betul605/2026_ZUGA-IC/asic/reports/summary.md

# ZUGA-IC Sky130 Sentez Ozeti

| Blok | Hucre | Alan (um^2) |
|---|---:|---:|
| obi_to_axi_lite | 206 | 2996.624000 |
| gpio_axi | 110 | 1406.348800 |
| timer_axi | 987 | 10218.550400 |
| uart_axi | 756 | 9303.923200 |
| i2c_master_axi | 657 | 8012.684800 |
| yz_csr | 780 | 10774.083200 |
| yz_accel | 22362 | 254860.681600 |
| yz_top | 22342 | 259630.256000 |
