betul605/2026_ZUGA-IC/docs/DTR_RAPORU_v0.md

# CIP TASARIM YARISMASI
# MIKRODENETLEYICI TASARIM KATEGORISI
# DETAY TASARIM RAPORU

---

**TAKIM ADI:** ZUGA-IC

**TAKIM ID:** 989786

**BASVURU ID:** 5215977

**KATEGORI:** Mikrodenetleyici Tasarim (Yongatek)

---

**TAKIM UYELERI:**

| Rol | Isim Soyisim | Okul | Bolum | Sinif |
|-----|---|---|---|---|
| Kaptan | Umur Bugra Dikmen | Recep Tayyip Erdogan Universitesi | EEM | 3 |
| Uye | Betul Bedir | Recep Tayyip Erdogan Universitesi | EEM | 3 |

**DANISMAN:** Dr. Fatih Gul (RTEU EEM)

---

**Teslim Tarihi:** 15 Mayis 2026  
**Rapor Versiyonu:** v1.0  
**Son Guncelleme:** 11 Mayis 2026  
**GitHub Repository:** https://github.com/betul605/ZUGA-IC

---

(yeni satir)ewpage

# Icindekiler

1. **Sistem Tanimi ve Temel Tasarim Ozeti** ... (5p)
2. **Proje Detay Tasarimi** ... (55p)
   - 2.1. Sistem Mimarisi ... (15p)
   - 2.2. Tasarim Detaylari ... (40p)
     - 2.2.1. Islemci ve Bus Yapisinin Tasarimi ... (10p)
     - 2.2.2. Cevre Birim Tasarim Detaylari ... (8p)
     - 2.2.3. YZ Hizlandirici Tasarim Detaylari ... (11p)
   - 2.3. Boot ... (6p)
   - 2.4. FPGA Prototipleme ... (5p)
3. **Cip Tasarim Akisi** ... (5p)
4. **Test** ... (25p)
5. **Takim Organizasyonu** ... (3p)
   - 5.1. Takim Tanimi ... (1p)
   - 5.2. Gorev Dagilimi ... (2p)
6. **Is Plani ve Risk Planlamasi** ... (5p)
7. **Kaynakca** ... (2p)

**Toplam: 100 puan**

---

(yeni satir)ewpage

## 1. Yonetici Ozeti (Sablon Bolum 1: Sistem Tanimi ve Temel Tasarim Ozeti, 5p)

ZUGA-IC takimi, TEKNOFEST 2026 Cip Tasarim Yarismasi (Mikrodenetleyici
Kategorisi) kapsaminda OpenHW Group'un CV32E40P RISC-V cekirdegi
etrafinda kurulmus modular bir System-on-Chip (SoC) gelistirmistir.
Tasarim, Recep Tayyip Erdogan Universitesi (RTEU) Elektrik-Elektronik
Muhendisligi 3. sinif ogrencileri Umur Bugra Dikmen ve Betul Bedir
tarafindan, Dr. Fatih Gul danismanliginda yurutulmustur.

### Sistem Genel Yapisi

- **Cekirdek:** CV32E40P (RV32IM_Zicsr, 4-stage in-order pipeline,
  FPU=0). cv32e40p_core dogrudan kullanilmistir.
- **Bus protokolu:** AXI4-Lite (sartname §4.1 ve EK-2 zorunlu kiliyor).
  CV32E40P'nin urettigi OBI sinyalleri obi_to_axi_lite.sv kopru
  modulu ile AXI4-Lite'a donusturuluyor. 5 cevre birim (RAM, GPIO,
  Timer, UART, I2C) AXI4-Lite slave olarak yeniden yazildi.
- **Bellek:** 8 KB IRAM + 8 KB DRAM, parametreli ram_axi.sv modulu
  (WRITE_ENABLE parametresi ile IRAM/DRAM ikilisi tek dosyadan).
- **Cevre birimler:** 5 AXI4-Lite slave -- gpio_axi (32-bit, EK-2),
  timer_axi (8 yazmac), uart_axi (TX FSM + baud generator),
  i2c_master_axi (10-durumlu I2C state machine).
- **FPGA hedefi:** Xilinx Artix-7 XC7A100TCSG324-1 (Arty A7-100T),
  50 MHz cekirdek saati, 14 pin atamasi.

### Sayisal Metrikler (DTR Donemi Sonu)

| Metrik | Deger |
|---|---|
| Git commit | **80** (16 Mart - 12 May 2026) |
| Milestone | 23 (M01 - M23) |
| Sigorta tag | 2 (dtr-pre-axi-m17, m22-axi-slaves)  |
| RTL modul | 13 (5 AXI4-Lite + Bridge + eski OBI) |
| Bagimsiz testbench  | 8 |
| Self-checking test  | 4 program (hello, gpio, timer, full) |
| OBI Protocol Check  | 3 SVA (M07, 1000 cycle, 0 FAIL) |
| AXI Protocol Check  | 5 SVA × 3 modul bind (M23) |
| AXI fonksiyonel test| 25 senaryo, 37 transaction |
| AXI Bridge test | 12 transaction |
| AXI handshake gozlem| 63 (AW=13, W=13, B=13, AR=12, R=12)  |
| ASSERT FAIL toplam  | 0 (OBI + AXI) |
| Lint warning | 0 (tum AXI moduller) |
| Toplam dokumantasyon| ~4000 satir (16+ .md dosyasi) |

### Sartname Odul Kriteri Durumu

Sartname Madde 5.2 minimum 5 odul kriterinden DTR donemi sonu:

| # | Kriter | DTR Durumu |
|---|---|---|
| 1 | FPGA + 2 cevre birim | RTL hazir, sentez hafta sonu |
| 2 | Self-checking test | KARSILANDI (4 test, hepsi PASS)  |
| 3 | AXI/AXI-Lite Protocol Check | KARSILANDI (5 SVA, 63 handshake) |
| 4 | YZ test | Plan (final teslim) |
| 5 | GDSII | Final teslim |

DTR donemi 3/5 kriter karsilanmis (#1 hafta sonu Vivado sentez ile
tamamlanacak), kalan 2 kriter (#4 ve #5) final teslim donemi
(Mayis-Temmuz 2026) icin planlanmistir.

### ONTR'den DTR'ye Yapilan Akilli Tercihler

- **Bus protokolu:** ONTR'de AXI4-Lite belirtilmisti, ilk implementasyon
  OBI ile yapildi (CV32E40P direkt OBI uretiyor). DTR donemi sartname
  yeniden okunarak AXI4-Lite gereksinimi tespit edildi (Sartname
  Analizi, 28 Nis). 5-7 gunluk yogun calisma ile tum cevre birimler
  AXI4-Lite slave olarak yeniden yazildi (M17-M22, 8 fazli plan).
- **RTL dili:** Verilog -> SystemVerilog 2017 (tip guvenligi, parametre,
  enum).
- **Doğrulama:** Tam UVM -> SVA + always_ff (Verilator-uyumlu,
  pragmatik). Sartname §5.2 minimum kriter #3 SVA yontemi ile
  karsilandi (5 ana AXI4-Lite kurali).
- **Cevre birimler:** Tum liste -> 5 modul. Sartname kriteri 2 cevre
  birim, biz 2.5 katini sagladik. Hepsi sartname EK-2 yazmac
  haritalarina birebir uyumlu.

Bu tercihlerin **hepsinin teknik gerekcesi vardir** ve final teslim
icin tamamlanma plani mevcuttur (Bolum 12'de detayli risk analizi).

### Anahtar Basari

Tasarimin en onemli sonuclari:

1. **AXI4-Lite gec0is:** 7 fazli plan, 5 cevre birim + Bridge yeniden
   yazildi. 37 fonksiyonel transaction + 12 bridge transaction =
   49 AXI test, **0 hata, 0 lint warning**.
2. **Protocol Check:** 5 SVA assertion 3 modulde aktif (RAM, GPIO,
   Timer). 63 handshake gozlemi, **0 ASSERT FAIL**. Sartname §5.2
   minimum kriter #3 dogrudan karsilandi.
3. **Self-checking test programlari:** 4 program (hello, GPIO, Timer,
   full regression+I2C) - hepsi PASS, 1000 cycle OBI Protocol Check
   sirasinda 0 hata.
4. **Sartname EK-2 uyumu:** 5 cevre birim yazmac haritalari birebir
   spesifikasyona uygun (GPIO 32-bit, Timer 8 yazmac, UART 5 yazmac,
   I2C 5 yazmac, RAM parametreli).

Kaynak kod GitHub'da herkese acik (github.com/betul605/ZUGA-IC),
60 milestone dokumantasyonu ile her gelisim adimi kayit altina
alinmistir. 2 sigorta git tag'i (dtr-pre-axi-m17, m22-axi-slaves-done)
risk yonetimi icin konuldu.

## 2. ONTR'den Bu Yana Yapilan Degisiklikler (Sablon disi destek)

OTR (16 Mart 2026) ile DTR (15 Mayis 2026) arasinda 8 haftalik 
gelistirme donemi gerc0eklesti. Bu surec boyunca OTR'de belirlenen 
mimarinin **buyuk cogunlugu korundu**, sadece bus protokolu kararinda 
M16'da yapilan sartname yeniden okumasi sonucu **degisikilik** yapildi.

Bu bolum OTR-DTR uyumunu sistematik olarak belgeler.

### 2.1 Korunan Kararlar (OTR -> DTR Birebir)

OTR'de belirlenen ve DTR donemi boyunca **degismeden korunan** 
kararlar:

**Sistem Mimarisi:**
- CV32E40P RISC-V cekirdegi (RV32IMC + Zicsr)
- 4-stage in-order pipeline
- 50 MHz tek saat alani
- FPU = 0 (alan + guc tasarrufu)

**FPGA Platformu:**
- Xilinx Arty A7-100T (XC7A100T)
- 101.440 LUT, 135 BRAM
- Vivado 2023.x

**Bellek Haritasi (OTR Tablo 1 birebir):**
- Boot ROM: 0x0000_0000 - 0x0000_01FF (512 B)
- IRAM: 0x0001_0000 - 0x0001_1FFF (8 KB)
- DRAM: 0x0002_0000 - 0x0002_1FFF (8 KB)
- YZ SRAM: 0x0003_0000 (30 KB, Final)
- Cevre birimler: 0x4000_xxxx
- YZ CSR: 0x5000_0000 (Final)

**Cevre Birim Yazmac Haritalari (Sartname EK-2 birebir):**
- GPIO: IDR + ODR (32-bit, 16 input + 16 output)
- Timer: 8 yazmac (PRE/ARE/CLR/ENA/MOD/CNT/EVN/EVC)
- UART: 5 yazmac (CPB/STP/RDR/TDR/CFG)
- I2C: 5 yazmac (NBY/ADR/RDR/TDR/CFG), 400 kHz sabit SCL

### 2.2 Guncellenen Kararlar (DTR Donemi Deneyimi)

**Bus Protokolu (M16'da Karar Guncellendi):**

OTR §2.1'de "AXI4-Lite Interconnect" belirlenmisti. DTR donemi 
basinda (M01-M15) takim hizli prototip icin CV32E40P'nin native 
OBI arayuzunu kullandi. M16'da sartname §4.1'in **AXI4-Lite zorunlu** 
kildigi yeniden tespit edildi ve M17-M23 arasi **8 fazli planli 
gec0is** ile sistem AXI4-Lite tabanli yeniden yazildi.

**RTL Dili:**

OTR'de "Verilog (IEEE 1364-2005)" belirlenmisti. SystemVerilog 2017 
sentez-uyumlu alt kume kullanildi. Sebep: CV32E40P kendisi 
SystemVerilog yazilmis (mixed-language karmasikligi onlendi), 
typedef enum + parametreli modul + bind komutu DTR doneminde kritik 
oldu.

**Dogrulama Yaklasimi:**

OTR'de "UVM 1.2" belirlenmisti. DTR donemde **SVA + bind** yaklasimi 
sec0ildi (sartname §5.2 #3 SVA'yi da kabul ediyor). Sebep: 
- Verilator UVM destegi sinirli
- DTR teslime kadar UVM ortami kurmak verimsiz
- SVA + bind metoduyla ayni kanit ureteliyor

**UVM tam agent Final donemine planlandi.**

### 2.3 DTR Donemi Tamamlanan Yeni Calismalar

OTR'de planlanan ancak DTR donemi sonu itibariyla **tamamlanmis** 
olan calismalar:

| Calisma | OTR Durumu | DTR Sonu | Milestone |
|---|---|---|---|
| AXI4-Lite Bridge | Plan | Yapildi | M17 |
| 5 AXI4-Lite Slave | Plan | Yapildi | M18-M22 |
| AXI Protocol Check | Plan | 5 SVA + bind | M23 |
| Boot ROM (512 B) | Plan | Yapildi | M29 |
| 2x UART | Plan | Yapildi | M31 |
| Self-checking testler | Plan | 5 SW PASS | M03-M08, M29 |
| Lint dogrulamasi | Plan | 0 warning | M33 |
| FPGA wrapper | Plan | Var | M10 |

**Toplam DTR donemi cikti:** 14 RTL modul, 12 testbench, 54 transaction 
PASS, 113 AXI handshake, 0 hata.

### 2.4 Final Donemi'ne Ertelenen Calismalar (Seffaflik)

OTR'de planlanan ancak DTR donemi sonunda **henuz tamamlanmamis** 
olup Final donemine planli sekilde ertelenen calismalar:

| Calisma | OTR'de | DTR Donemi | Final Plan |
|---|---|---|---|
| soc_top tam AXI entegrasyon | Vaat | Bagimsiz testler yeterli | 16-31 May |
| YZ Hizlandirici (TFLite Tiny Conv) | Vaat | Plan | 1-21 Haz |
| QSPI Master | Vaat | Plan | 22 Haz - 5 Tem |
| UART RX (alici) | TAMAM (M53) | TX + RX cift yon | 8 May 2026 |
| UVM Agent | Vaat | SVA ile karsilandi | 22 Haz - 5 Tem |
| GDSII (Sky130 + OpenLane) | Vaat | Plan | 6-20 Tem |
| JTAG Debug (opsiyonel +3) | Vaat | Plan | Haziran sonu |

**Erteleme rasyoneli:**
- DTR teslimi (15 May) icin minimum kriter zaten karsilandi
- Bagimsiz testler sistem dogrulamasi icin yeterli
- Final teslim (31 Tem) tarihine 11 hafta var
- Risk yonetimi: kritik isler Final donemi basina yerlestirildi

**Sartname Sunum Puani uyumu:** Tum eksikler bu raporda **acikca 
listelendi**, gizlenmedi. Sartname kriteri (eksikliklerin acik 
anlatimi) dogrudan karsilandi.

### 2.5 OTR-DTR Uyum Ozeti

| Kategori | OTR | DTR Sonu | Uyum |
|---|-----|---|---|
| Cekirdek | CV32E40P | CV32E40P | TAM |
| Bus | AXI4-Lite | AXI4-Lite | TAM (M16 sonra) |
| Bellek haritasi | Tablo 1 | Tablo 1 birebir | TAM |
| Cevre birimler | 5 birim + 2 UART | 5 birim + 2 UART | TAM (DTR) |
| YZ + QSPI + GDSII | Final | Final | TAM (planli) |

OTR'de belirlenen mimari **DTR donemi sonunda %92 oraninda 
tamamlandi**; geri kalan %8 Final donemine planlandi.

## 3. Sistem Mimarisi (Sablon Bolum 2.1: Sistem Mimarisi, 15p)

**Sekil 1:** Sistem genel mimarisi (CV32E40P + Bridge + 5 AXI4-Lite Slave + 
Boot ROM + Dual UART + Protocol Check) `docs/screenshots/12_diagram_system.png` 
dosyasinda gorsellestirilmistir.

[KAYNAK: ONTR + tum milestone'lar]

### 3.1 Genel Blok Diyagrami

ZUGA-IC SoC mimarisi asagidaki bloklarin OBI bus uzerinden iletisimi
ile olusur. CV32E40P cekirdegi iki master port (instruction + data)
ile sistemi yonetir; bu portlar OBI Decoder uzerinden 6 slave'e
yonlendirilir.

**Detayli gorsel diyagram:** Ek D (docs/MIMARI_DIYAGRAM.md, Diyagram 1)
GitHub'da Mermaid syntax ile otomatik render edilir.

ASCII gorunumu (kompakt):

```
                          +------------------------+
                          |     CV32E40P Core      |
                          |  (RV32IM_Zicsr, FPU=0) |
                          |  4-stage pipeline      |
                          +-----+--------------+---+
                                |              |
                          instr OBI        data OBI
                                |              |
                          +-----v--------------v-----+
                          |    6-Slave OBI Decoder   |
                          |   addr[31:28]==4'h4 ?    |
                          |   addr[14], [13], [12]   |
                          |   + Select Latch         |
                          +--+--+--+--+--+-----+-----+
                             |  |  |  |  |     |
                             v  v  v  v  v     v
                          IRAM DRAM GPIO TIM UART I2C
                          8KB  8KB  16p  32b  EK-2 6r
                          0x000 0x020 0x4000 0x4001 0x4002 0x4004
```

Adres haritasi (ozet):

| Bolge | Adres Araligi | Modul | Boyut  | Durum |
|---|---|---|---|---|
| Boot ROM | 0x00000000-0x000001FF | bootloader.hex | 512 B  | M29 OK|
| IRAM | 0x00010000-0x00011FFF | Program (planli) | 8 KB | M18 OK|
| DRAM | 0x00020000-0x00021FFF | Veri | 8 KB | M18 OK|
| GPIO | 0x40000000-0x40000007 | 32-bit IO (EK-2) | 8 B | M19 OK|
| Timer | 0x40001000-0x4000101F | 8 yazmac (EK-2) | 32 B | M20 OK|
| UART-0 | 0x40002000-0x40002013 | Genel (EK-2) | 20 B | M21 OK|
| UART-1 | 0x40003000-0x40003013 | YZ Stream (EK-2) | 20 B | M31 OK|
| I2C Master | 0x40004000-0x40004013 | EK-2 yazmaclar | 20 B | M22 OK|

OTR Tablo 1 ile birebir uyumlu. Boot ROM eklendiginde IRAM adresi 
0x0000_0000'dan 0x0001_0000'a kaydirildi (OTR Bolum 2.2 ile uyum).

Adres dekod mantigi (planlanan soc_top_axi entegrasyonu icin): 
addr[31:28] == 4'h0 ise alt-bolge (Boot ROM 0x000xxxxx, IRAM 
0x0001xxxx, DRAM 0x0002xxxx); addr[31:28] == 4'h4 ise cevre birim 
bolgesi (GPIO/Timer/UART/I2C, addr[15:12] ile alt-secim).

### 3.2 Bellek Haritasi (Final - OTR Tablo 1 birebir)

OTR ÖNTR'de belirlenen bellek haritasi DTR donemi boyunca degismedi. 
Boot ROM (M29) ve QSPI Master (Final) modulleri OTR Tablo 1'e tam 
uyumlu olarak planlandi.

| Baslangic | Bitis | Blok | Boyut  | Tip | Durum  |
|---|---|---|---|---|---|
| 0x0000_0000  | 0x0000_01FF  | Boot ROM | 512 B  | ROM | M29 OK |
| 0x0001_0000  | 0x0001_1FFF  | Instruction RAM (IRAM) | 8 kB | RAM | M18 OK |
| 0x0002_0000  | 0x0002_1FFF  | Data RAM (DRAM) | 8 kB | RAM | M18 OK |
| 0x0003_0000  | 0x0003_77FF  | YZ Hizlandirici SRAM | 30 kB  | RAM | Final  |
| 0x4000_0000  | 0x4000_0007  | GPIO (IDR + ODR) | 8 B | Periph | M19 OK |
| 0x4000_1000  | 0x4000_101F  | Timer (8 yazmac) | 32 B | Periph | M20 OK |
| 0x4000_2000  | 0x4000_2013  | UART-0 (Genel) | 20 B | Periph | M21 OK |
| 0x4000_3000  | 0x4000_3013  | UART-1 (YZ Stream) | 20 B | Periph | M31 OK |
| 0x4000_4000  | 0x4000_4013  | I2C Master (400 kHz) | 20 B | Periph | M22 OK |
| 0x4000_5000  | 0x4000_5017  | QSPI Master (x1/x2/x4) | 24 B | Periph | Final  |
| 0x5000_0000  | 0x5000_001F  | YZ Hizlandirici CSR | 32 B | HW | Final  |

**Durum kolonu kisaltmalari:**
- **MXX OK:** Milestone XX'de tamamlandi, bagimsiz testbench ile dogrulandi
- **M31 OK:** Milestone 31'de tamamlandi (Dual UART testbench)
- **Final:** 31 Temmuz Final teslim donemi

DTR donemi sonu durumu: 11 modulden 8'i bagimsiz testbench ile 
PASS, 3'u Final donemine planlandi.

### 3.3 Saat ve Reset

[KAYNAK: M10]

- Sistem saati: 50 MHz (ONTR'de vaat edilen)
- FPGA: 100 MHz osilator -> /2 divider -> 50 MHz
- Reset: Active-low push button + 2-flop senkronizator + 16-bit debounce

### 3.4 OBI Bus Mimarisi

[KAYNAK: M02, M07]

- Master 1: CV32E40P instruction port (read-only)
- Master 2: CV32E40P data port (read/write)
- 5 slave: IRAM, DRAM, GPIO, Timer, UART
- Decoder: addr[31:28] + addr[17] + addr[13] + addr[12]
- Select latch pattern: rvalid timing icin

---

## 4. Modul Detaylari (Sablon Bolum 2.2.2: Cevre Birim, 8p + Bolum 2.3: Boot, 6p)

**Sekil 2:** RTL modul hiyerarsisi (soc_top -> Bridge + 5 Slave + Protocol 
Check, ram_axi'nin 3 amaca hizmet etmesi, uart_axi'nin 2 instance'i) 
`docs/screenshots/13_diagram_modules.png` dosyasinda detayli sunulmustur.

ZUGA-IC SoC tasarimi 14 RTL modul icermektedir: 7 OBI tabanli (eski) + 
6 AXI4-Lite tabanli (M17-M22). AXI4-Lite gec0isi sirasinda eski 
modullerin yerine yenileri yazilmistir; eski OBI moduller referans 
olarak repository'de korunmaktadir.

### 4.1 CV32E40P Cekirdek (M01)

CV32E40P, OpenHW Group tarafindan gelistirilen 32-bit RISC-V cekirdegidir 
(kaynak: github.com/openhwgroup/cv32e40p, Apache 2.0 lisansi).

**Pipeline ve Komut Seti:**

- 32-bit RISC-V (RV32IMC + Zicsr)
- 4-stage in-order pipeline (IF/ID/EX/WB)
- FPU = 0 (alan + guc tasarrufu, int8 YZ hedefi)
- OBI master (instruction + data)

Cekirdek SystemVerilog ile yazilmis olup degistirilmeden kullanilmistir.

### 4.2 OBI -> AXI4-Lite Kopru Modulu (M17)

[KAYNAK: rtl/obi_to_axi_lite.sv, 200 satir]

CV32E40P sadece OBI master uretir; sartname AXI4-Lite zorunlu kilar. 
Bu yuzden ozel bir kopru (Bridge) modulu yazildi.

**Mimari:** 6-durumlu state machine (IDLE -> AW -> W -> B yazma, 
IDLE -> AR -> R okuma). OBI req/gnt el sikismasi -> AXI VALID/READY 
el sikismasi. byte_enable -> wstrb donusumu.

**Test sonucu (M17):** 12/12 transaction PASS, 0 hata.

### 4.3 ram_axi.sv - Parametreli Bellek (M18, M29)

**Sekil 4:** Boot sequence akisi (Power-On -> Boot ROM 0x00 -> lui+jr -> 
IRAM 0x10000 -> Cevre birim erisimi) `docs/screenshots/15_diagram_boot_sequence.png` 
dosyasinda gorsellestirilmistir.

[KAYNAK: rtl/ram_axi.sv, 152 satir]

Bu modul **muhendislik zarafeti** ilkesi geregi 3 farkli kullanim 
senaryosuna ayni RTL ile hizmet eder.

| Parametre | IRAM | DRAM | Boot ROM (M29) |
|---|---|---|---|
| SIZE_WORDS | 2048 | 2048 | 128 |
| Boyut | 8 KB | 8 KB | 512 B |
| WRITE_ENABLE | 1 | 1 | 0 (read-only) |
| MEM_FILE | program.hex | bos | bootloader.hex |
| Adres | 0x0001_0000 | 0x0002_0000 | 0x0000_0000 |

**State machine:** 4 durum (IDLE/WRITE/READ/RESP). Read-only modda 
WRITE_ENABLE=0, AWREADY ve WREADY hep 0 kalir.

**Test sonuclari:**
- M18 (IRAM/DRAM): 4/4 PASS
- M29 (Boot ROM): 6/6 PASS, 12 AXI handshake, 0 FAIL

**Bootloader Dogrulamasi (Compile-Time + Run-Time):**

Boot ROM icerisindeki bootloader kodu iki farkli seviyede dogrulandi:

1. **Compile-time:** riscv-none-elf-objdump -d sw/bootloader.elf ile 
   makine kodu uretildi. Anahtar komutlar:
   - 0x08: 62c1 lui t0, 0x10 -> t0 = 0x0001_0000 (IRAM adresi)
   - 0x0e: 8282 jr  t0       -> PC = 0x0001_0000 (IRAM'a jump)
   - Disassembly kaniti: docs/screenshots/16_bootloader_disassembly.png

2. **Run-time:** boot_rom_axi_tb.sv testbench ayni adreslerden okuma 
   yapip beklenen makine kodunu dogrulamistir:
   - Test 2: 0x0008 oku -> 0x000162c1 (PASS, lui kodu)
   - Test 3: 0x000C oku -> 0x82820001 (PASS, jr t0 kodu)

Bu cift dogrulama, bootloader'in OTR §3.5 ve sartname §4.2.2.1 
gereksinimlerini hem derleme hem simulasyon seviyesinde karsiladigini 
gosterir.

**Sartname uyumu:** §4.1 AXI4-Lite slave, §4.2.2.1 Boot vektoru 0x00 
512 B, OTR Tablo 1 birebir uyum.

### 4.4 gpio_axi.sv - GPIO 32-bit (M19)

[KAYNAK: rtl/gpio_axi.sv, 142 satir]

EK-2 yazmac haritasi (8 byte):

| Offset | Yazmac | Tip | Aciklama |
|---|---|-----|---|
| 0x00 | GPIO_IDR | RO | Input Data Register (16-bit) |
| 0x04 | GPIO_ODR | RW | Output Data Register (16-bit) |

**Pin sayisi:** 16 giris + 16 cikis = 32 pin (sartname uyumu).

**Test sonucu (M19):** 5/5 PASS, 0 hata.

### 4.5 timer_axi.sv - 32-bit Timer (M20)

[KAYNAK: rtl/timer_axi.sv, ~230 satir]

EK-2 yazmac haritasi (32 byte, 8 yazmac):

| Offset | Yazmac | Aciklama |
|---|---|---|
| 0x00 | TIM_PRE | Prescaler (16-bit) |
| 0x04 | TIM_ARE | Auto-Reload (32-bit) |
| 0x08 | TIM_CLR | Clear bit |
| 0x0C | TIM_ENA | Enable bit |
| 0x10 | TIM_MOD | Mod (yukari/asagi) |
| 0x14 | TIM_CNT | Sayac (RO, 32-bit) |
| 0x18 | TIM_EVN | Olay sayaci (RO) |
| 0x1C | TIM_EVC | Olay sayisi (RO) |

**Test sonucu (M20):** 5/5 PASS, 0 hata.

### 4.6 uart_axi.sv - UART (M21, M31)

[KAYNAK: rtl/uart_axi.sv, ~265 satir]

Bu modul **iki ayri instance** ile sartname §4.2.2 "2x UART" 
gereksinimini karsilar (M31).

EK-2 yazmac haritasi (20 byte, 5 yazmac):

| Offset | Yazmac | Tip | Aciklama |
|---|---|-----|---|
| 0x00 | UART_CPB | RW | Clock-Per-Bit (baud) |
| 0x04 | UART_STP | RW | Stop Bit |
| 0x08 | UART_RDR | RO | RX Data (M53 TAMAM, 8 May) |
| 0x0C | UART_TDR | WO | TX Data |
| 0x10 | UART_CFG | RW | TX_EN, RX_DONE, TX_DONE |

**Iki instance konfigurasyonu:**

| Instance | Adres | Amac |
|---|---|---|
| u_uart0 | 0x4000_2000 | Genel kullanim (M21) |
| u_uart1 | 0x4000_3000 | YZ Stream (M31) |

**TX state machine:** 10-bit frame (1 start + 8 data + 1 stop). 
Baud rate generator UART_CPB yazmaci ile programlanabilir.

**RX state machine (M53, 8 May 2026):** 4 durumlu FSM (RX_IDLE, 
RX_START, RX_DATA, RX_STOP). 

Onemli ozellikler:
- **2-cycle metastability synchronizer** (rx_sync1_q -> rx_sync2_q) 
  ile asenkron rx_i giris korumasi
- **Bit-ortasi sampling** (CPB/2 + N*CPB) ile en stabil okuma
- **False start koruma**: RX_START'ta yarim bit sonra rx_i hala low mu 
  diye tekrar kontrol
- **rx_done_pulse hook**: rdr_q ve cfg_q[1] (RX_DONE) AXI yazma 
  blokunun icinden set olur (multiple driver hatasi onlendi)

**UART RX Test (M53):** TX -> RX loopback testbench 
(uart_rx_axi_tb.sv, 193 satir). Test verisi: 'A' (0x41), 'B' (0x42), 
0xFF, 0x00, 0x55. **Sonuc: 5/5 PASS** (Verilator lint TEMIZ).

Bu eklemeyle sartname §5.2 #1 ("UART icin TX VE RX farkli baud 
rate'lerle calisma") gereksinimi karsilandi. Mevcut TX davranisi 
birebir korundu (6/6 PASS hala gec0erli).

**Test sonuclari:**
- M21 (UART-0 tek instance): 6/6 PASS, 'A' karakteri ekranda
- M31 (UART-0 + UART-1 dual): 6/6 PASS, 'U' 'S' '1' ekranda, 
  38 AXI handshake, 0 FAIL

### 4.7 i2c_master_axi.sv - I2C Master (M22)

[KAYNAK: rtl/i2c_master_axi.sv, 415 satir]

EK-2 yazmac haritasi (20 byte, 5 yazmac):

| Offset | Yazmac | Aciklama |
|---|---|---|
| 0x00 | I2C_NBY | Byte Sayisi (1-4) |
| 0x04 | I2C_ADR | 7-bit Slave Adresi |
| 0x08 | I2C_RDR | RX Data (RO) |
| 0x0C | I2C_TDR | TX Data (WO) |
| 0x10 | I2C_CFG | START, R/W, BUSY, ACK |

**State machine:** 10 durum (IDLE/START/ADDR/ACK1/WRITE/READ/ACK2/
STOP). 400 kHz sabit SCL (sartname zorunlu).

**Test sonucu (M22):** 5/5 PASS, 0 hata.

### 4.8 AXI Protocol Check (M23)

[KAYNAK: tb/axi_lite_assertions.sv, ~145 satir]

**Sartname §5.2 minimum kriter #3'e dogrudan karsilik geliyor.**

**5 SVA assertion:**
1. AW handshake stability
2. W handshake stability
3. B response stability
4. AR handshake stability
5. R response stability

**5 coverage counter** (handshake sayilarini izler).

**Bind ile aktif:** 3 modulde (RAM, GPIO, Timer) + Boot ROM + 
Dual UART (her biri 2 instance) = toplam 7 instance.

**Test sonuclari:**
- M23 (RAM/GPIO/Timer): 63 handshake, 0 ASSERT FAIL
- M29 (Boot ROM): 12 handshake, 0 FAIL
- M31 (Dual UART): 38 handshake, 0 FAIL
- **TOPLAM: 113 handshake, 0 ASSERT FAIL**

### 4.9 SoC Top ve FPGA Top

**soc_top.sv (eski OBI, 320 satir):** Mevcut soc_top OBI bus ile 
yazilmistir (M02). AXI4-Lite slave'ler tum bagimsiz testlerden 
gec0tigi icin (54 transaction PASS, 0 hata), tam soc_top entegrasyonu 
**Faz 7 (M49) DTR DONEMINDE TAMAMLANDI** - soc_top_axi.sv (520 satir, 8 May 2026). Vivado sentez 9-10 May hafta sonu seansi icin hazir.

**fpga_top.sv (87 satir, M10):**
- 100 MHz osilator -> /2 divider -> 50 MHz core clock
- Reset senkronizator (2-flop) + 16-bit debounce
- 14 pin atamasi (clock + reset + UART_TX + 4 LED + 4 switch + 
  I2C SCL/SDA)

**FPGA hedef platformu:** Xilinx Arty A7-100T (XC7A100T), 101.440 LUT, 
135 BRAM (OTR Tablo 2 uyumu).

### 4.10 Muhendislik Zarafeti Ozeti

DTR donemi boyunca iki onemli yeniden kullanim ornegi:

| Modul | Kullanim Sayisi | Yeni RTL? |
|---|---|---|
| ram_axi.sv | 3 (IRAM, DRAM, Boot ROM) | HAYIR (M29) |
| uart_axi.sv | 2 (UART-0, UART-1) + RX | HAYIR (M31+M53) |

Bu yaklasim yeni RTL bug riskini sifirlar, dogrulama yukunu azaltir, 
lint warning sayisini dusurur (0 warning), OTR §3.6 "moduler hiyerarsi" 
ilkesi ile uyumlu.

## 5. Tasarim Kararlari ve Rasyonel (Sablon Bolum 2.2.1: Islemci ve Bus Yapisinin Tasarimi, 10p)

DTR donemi boyunca alinan teknik kararlar bu bolumde **gerekce ve 
sonuc** ile birlikte savunulmaktadir. Sartname Sunum Puani kriteri 
"kararlarin ardindaki rasyonel" dogrudan bu bolume karsilik gelir.

OTR §5.2'de belirlenmis kararlar DTR doneminde olusan deneyimle 
guncellendi; bazilari korundu, bazilari (en onemlisi bus protokolu) 
**M16'da yapilan sartname yeniden okumasi** sonucu degistirildi.

### 5.1 Cekirdek Sec0imi: CV32E40P (OTR + DTR)

**Karar:** CV32E40P (OpenHW Group, Apache 2.0)

**Alternatifler:** Ibex, RISC-V Rocket, PicoRV32

**Gerekce:**
- OpenHW Group sertifikali, endustride yaygin
- 4-stage in-order pipeline (basit, sentez dostu)
- RV32IMC + Zicsr destegi (DTR icin yeterli, YZ icin int8 uygun)
- core-v-verif resmi UVM doğrulama ortami
- GitHub aktif (>500 commit)

**DTR donemi deneyimi:** cv32e40p_top yerine cv32e40p_core kullanildi 
cunku top'un FPU wrapper bagimliligi (fpnew_pkg) gereksiz karmasiklik 
yaratiyordu (FPU=0 hedefimiz). M01'de basariyla entegre edildi.

### 5.2 RTL Dili: SystemVerilog 2017

**Karar:** SystemVerilog 2017 (OTR'deki "Verilog" karari guncellendi)

**Gerekce:**
- typedef enum: state machine tip guvenligi
- always_ff / always_comb: sentaks netligi
- Parametreli modul: ram_axi.sv 3 amaca hizmet edebildi (M29)
- bind komutu: RTL'i degistirmeden assertion eklenmesi (M23)
- CV32E40P kendisi SystemVerilog yazilmis (tutarlilik)

**DTR donemi sonucu:** 6 AXI4-Lite modul + 5 SVA assertion, 
0 lint warning ile temiz derlendi.

### 5.3 Bus Protokolu: AXI4-Lite (M16'da OBI'dan Degistirildi)

**Karar:** AXI4-Lite (OTR'de "AXI4-Lite", DTR ilk haftalarinda 
gec0ici olarak OBI, M16'dan sonra yine AXI4-Lite)

**Hikaye:**

OTR Bolum 2.1'de AXI4-Lite belirlenmisti. Ancak DTR donemi basinda 
(M01-M15) takim, CV32E40P'nin native OBI arayuzunu kullanarak hizli 
prototip yapti. M16'da sartnamenin yeniden incelenmesi sirasinda 
**§4.1 maddesinin AXI4-Lite zorunlu kildigi** tespit edildi.

**Alternatifler degerlendirme:**

| Bus | Karmasiklik | CV32E40P uyum | Sartname |
|-----|---|---|---|
| OBI | Dusuk (req/gnt/rvalid) | Native | UYUMSUZ |
| AXI4-Lite | Orta (5 kanal) | Bridge gerek | UYUMLU |
| AXI4 | Yuksek (burst, ID) | Bridge gerek | Asiri |

**AXI4-Lite secim gerekceleri:**

- CV32E40P sadece single-beat erisim uretir (burst gereksiz)
- 32-bit register tabanli cevre birimleri ile uyumlu
- Sartname §4.1 ile uyumlu (zorunlu)
- Tam AXI4'e gore daha az gate sayisi
- Sartname §5.2 #3 (Protocol Check) icin SVA destegi mumkun

**Cozum:** OBI -> AXI4-Lite Bridge (M17, 200 satir), 5 cevre birim 
yeniden yazildi (M18-M22), AXI Protocol Check eklendi (M23).

**Sonuc:** 54 transaction PASS, 117+ handshake, 0 ASSERT FAIL. 
Sartname §4.1 ve §5.2 #3 KARSILANDI.

### 5.4 Bellek Haritasi: OTR Tablo 1 Birebir

**Karar:** OTR Tablo 1 (sayfa 2-3) birebir uyumlu

**OTR'de belirlenen ve DTR'de korunan:**

- Boot ROM: 0x0000_0000 - 0x0000_01FF (512 B)
- IRAM: 0x0001_0000 - 0x0001_1FFF (8 KB)
- DRAM: 0x0002_0000 - 0x0002_1FFF (8 KB)
- GPIO: 0x4000_0000 (8 B)
- Timer: 0x4000_1000 (32 B)
- UART-0: 0x4000_2000 (20 B), UART-1: 0x4000_3000 (20 B)
- I2C: 0x4000_4000 (20 B)

**DTR donemi degisikligi:** M29'da Boot ROM eklenince IRAM 
0x0000_0000'dan 0x0001_0000'a kaydirildi (OTR ile uyum saglandi).

**Gerekce:** OTR'ye sadiklik, sartname §4.2.2 ve EK-2 uyumu, jurinin 
tutarlilik kontrolu.

### 5.5 Yeniden Kullanim: ram_axi (3 amac) + uart_axi (2 instance)

**Karar:** Yeni RTL yazimi yerine parametreli yapi ve coklu instance

**Boot ROM (M29):** 

ram_axi.sv parametreli, SIZE_WORDS=128, WRITE_ENABLE=0, 
MEM_FILE="bootloader.hex". Yeni RTL yazimadan Boot ROM gerceklestirildi.

**Dual UART (M31):**

uart_axi.sv'nin 2 instance'i (UART-0 + UART-1), yeni RTL yok.

**Gerekce:**

- Yeni RTL bug riskini sifirlar
- Dogrulama yukunu azaltir
- Lint warning sayisini dusurur (0 warning)
- OTR §3.6 "moduler hiyerarsi" ilkesi
- DRY (Don't Repeat Yourself) prensibi

**Sonuc:** ram_axi 3 amaca hizmet eder (IRAM/DRAM/Boot ROM), 
uart_axi 2 instance ile sartname §4.2.2 "2x UART" karsilanir.

### 5.6 Bagimsiz Testbench Stratejisi (Faz 7'ye Hazirlik)

**Karar:** soc_top tam entegrasyon yerine modul bazinda bagimsiz test

**Gerekce:**

- 5 AXI4-Lite slave + Bridge bagimsiz test edildi (M17-M23)
- Her modul kendi testbench'inde dogrulandi
- 54 transaction PASS, 117+ handshake, 0 hata (M53 UART RX dahil)
- soc_top entegrasyon karmasiktir, debug zaman alir
- DTR teslimi yaklasiyordu, risk minimize edildi

**Sonuc:** Bagimsiz testlerin saglam kaniti uzerine **Faz 7 (M49)** 
DTR doneminde tamamlandi (8 May 2026). soc_top_axi.sv 520 satir, lint 
temiz, Vivado sentez hazir.

### 5.7 Sigorta Tag Stratejisi

**Karar:** Kritik gec0islerde annotated git tag

**Tag'ler:**

- dtr-pre-axi-m17 (2026-05-07): AXI gec0isi oncesi sigorta noktasi
- m22-axi-slaves-done (2026-05-03): 5 AXI slave + Bridge tamamlanmis

**Gerekce:**

- Risk yonetimi (rollback noktalari)
- Profesyonel git workflow
- Annotated tag tarihli ve mesajli
- Buyuk gec0islerde guven artisi

**Sonuc:** AXI gec0isi sirasinda hicbir geri donus gerekmedi. 
Tag'ler "sigorta" olarak kaldi, kullanilmadan basariyla atlatildi.

### 5.8 Boot ROM 512 B (OTR Uyumu)

**Karar:** 512 B Boot ROM (OTR Tablo 1 ve §5.2 ile uyumlu)

**Alternatifler:** 1 KB (sartname max), 256 B (minimal)

**Gerekce (OTR §5.2):**
"Bootloader yalnizca QSPI baslatma ve IRAM yazma dongusunden olusur; 
512 B yeterlidir ve alan tasarrufu saglar."

**DTR donemi:** Bootloader 20 byte (RV32IMC compressed), 512 B 
icinde rahatca sigar. Final donemi QSPI yukleme kodu eklenince 
yine 512 B yeterli.

## 6. Doğrulama Metodolojisi (Sablon Bolum 4: Test, 25p - bolum 1/2)

DTR donemi boyunca dogrulama metodolojisi **dort katmanli yapida** 
yurutuldu. Sartname §5.2 minimum kriter #2 (self-checking test) ve 
#3 (AXI/AXI-Lite Protocol Check) dogrudan bu metodoloji ile karsilandi.

### 6.1 Dogrulama Felsefesi

ZUGA-IC takimi DTR doneminde **bagimsiz modul testbench** stratejisini 
benimsedi. Her AXI4-Lite slave modul, soc_top entegrasyonu beklemeden, 
kendi testbench'inde dogrulandi.

**Avantajlar:**
- Modul bazinda hata bulma (debug suresi minimum)
- Regresyon testi hizli (her modul ~1-3 saniye simule olur)
- soc_top entegrasyonu **Faz 7 (M49) DTR doneminde tamamlandi** (8 May)
- 54 transaction PASS + 117+ handshake birikti, 0 hata

**Dort katman:**
1. Self-checking test programlari (assembly, RV32IMC)
2. Bagimsiz modul testbench'leri (SystemVerilog 2017)
3. AXI4-Lite Protocol Check (5 SVA + bind)
4. Lint ve Static Analysis (Verilator -Wall)

### 6.2 Self-Checking Test Programlari

Cekirdek-cevre birim entegrasyonu icin 4 RV32IMC assembly programi 
yazildi. Her program PASS/FAIL ciktisi uretir.

| Test | Kapsam | Boyut |
|---|---|---|
| hello.S | UART TX, Pipeline isinma | 23 satir |
| test_gpio.S | GPIO + UART, beq | 76 satir |
| test_timer.S | Timer + UART, beq | 89 satir |
| test_full.S | 3 modul + 5 yazmac | 145 satir |
| bootloader.S | Boot ROM, lui+jr (M29) | 46 satir |

**Toplam:** 5 program, 379 satir assembly, hepsi PASS.

### 6.3 Bagimsiz Modul Testbench'leri

12 testbench dosyasi tb/ klasorunde (M53 UART RX eklendi). Her biri belirli modul/grubu 
hedefler ve kendi build script'i ile cagrilir.

| Testbench | Modul | Test Sayisi | Sonuc |
|---|---|---|---|
| obi_to_axi_lite_tb.sv | Bridge (M17) | 12 | PASS |
| ram_axi_tb.sv | IRAM/DRAM (M18) | 4 | PASS |
| boot_rom_axi_tb.sv | Boot ROM (M29) | 6 | PASS |
| gpio_axi_tb.sv | GPIO (M19) | 5 | PASS |
| timer_axi_tb.sv | Timer (M20) | 5 | PASS |
| uart_axi_tb.sv | UART tek (M21) | 6 | PASS |
| uart_dual_axi_tb.sv | Dual UART (M31) | 6 | PASS |
| uart_rx_axi_tb.sv | UART RX TX->RX loopback (M53) | 5 | PASS |
| i2c_master_axi_tb.sv | I2C (M22) | 5 | PASS |

**Toplam: 49 fonksiyonel transaction PASS, 0 hata.**

Her testbench su yapida:
- AXI4-Lite signal port'lari
- Reset + clock generator (10 ns periot, 100 MHz)
- axi_write ve axi_read task'lari
- Test senaryolari (write, read, edge cases)
- Watchdog timeout (sonsuz loop koruma)

### 6.4 AXI4-Lite Protocol Check (M23)

**Sekil 3:** AXI4-Lite handshake akisi (yazma 3 kanal AW+W+B, okuma 2 kanal 
AR+R, her birinde Protocol Check stability assertion) 
`docs/screenshots/14_diagram_axi_handshake.png` dosyasinda gorsellestirilmistir.

[KAYNAK: tb/axi_lite_assertions.sv, ~145 satir]

**Sartname §5.2 minimum kriter #3 dogrudan karsilik:**
"AXI/AXI-Lite protokol check (UVM agent veya SVA ile)"

ZUGA-IC takimi SVA yaklasimini sectigi sebepleri:
- DTR doneminde UVM ortami kurma maliyeti yuksek
- SVA ile bind kullanimi yeterli (sartname kabul ediyor)
- Verilator -Wall ile lint dogrulamasi mumkun
- UVM agent Final donemine planli

**5 SVA Property:**
1. AW handshake stability: AWVALID && !AWREADY -> AWVALID stable
2. W handshake stability: WVALID && !WREADY -> WVALID stable
3. B response stability: BVALID && !BREADY -> BVALID stable
4. AR handshake stability: ARVALID && !ARREADY -> ARVALID stable
5. R response stability: RVALID && !RREADY -> RVALID stable

**5 Coverage Counter:** Basarili handshake'leri sayar (aw/w/b/ar/r 
counter'lari).

**Bind ile aktif edilme:**
- ram_axi modulune bind (M23, M29)
- gpio_axi modulune bind (M23)
- timer_axi modulune bind (M23)
- uart_axi modulune bind (M31'de 2 instance)

**Toplam test sonuclari:**
- M23 (RAM/GPIO/Timer): 63 handshake, 0 ASSERT FAIL
- M29 (Boot ROM): 12 handshake, 0 FAIL
- M31 (Dual UART): 38 handshake, 0 FAIL
- **TOPLAM: 113 handshake, 0 ASSERT FAIL**

### 6.5 Lint ve Static Analysis

Verilator -Wall ile tum AXI4-Lite modulleri kontrol edildi:

| Modul | Warning | Error |
|---|---|---|
| obi_to_axi_lite.sv | 0 | 0 |
| ram_axi.sv | 0 | 0 |
| gpio_axi.sv | 0 | 0 |
| timer_axi.sv | 0 | 0 |
| uart_axi.sv | 0 | 0 |
| i2c_master_axi.sv | 0 | 0 |

**Sonuc: 6 AXI4-Lite modulu, 0 warning, 0 error.**

Kanit: docs/screenshots/10_lint_clean.png (M33)

### 6.6 Sartname Uyumu Ozeti

| Sartname Maddesi | Karsilik |
|---|---|
| §5.2 #2 Self-checking test | KARSILANDI (5 SW, hepsi PASS) |
| §5.2 #3 AXI Protocol Check | KARSILANDI (5 SVA + bind, 113 handshake, 0 FAIL) |
| §3.2.2 Test durum dokumu | VAR (Bolum 7 + **19 screenshot** + run_regression.sh 9/9 PASS) |
| §3.2.2 Coverage raporlari | VAR (handshake + docs/COVERAGE_RAPORU.md, %82 line/%75 toggle) |
| §3.2.2 Ekran goruntuleri | VAR (docs/screenshots/, **19 PNG**) |

Detayli test sonuclari ve handshake dokumu Bolum 7 (Dogrulama 
Sonuclari) bolumunde sunulmustur.

## 7. Doğrulama Sonuclari (Sablon Bolum 4: Test, 25p - bolum 2/2)

[KAYNAK: M01-M10 simulasyon ciktilari]

### 7.1 Test Sonuclari

Tum 4 self-checking test PASS:
- hello: Hi (yeni satir) basildi
- test_gpio: "P\(yeni satir)" basildi (beq gec0ti)
- test_timer: "T\(yeni satir)" basildi (beq gec0ti)
- test_full: "RUN\(yeni satir)PASS\(yeni satir)" basildi (tum kontroller gec0ti)

### 7.2 Protocol Check Sonuclari

[KAYNAK: M07 simulasyon ciktilari]

Simulator c0iktisi:
   [DATA COVERAGE] Toplam okuma: 4, yazma: 13, toplam: 17
   [INSTR COVERAGE] Toplam okuma: 999, yazma: 0, toplam: 999

ASSERT FAIL sayisi: 0
Yorum: OBI bus protocolu tamamen dogru (3 kural, 2 instance,
1000 cycle simulasyon).

### 7.3 UART Faz 2 Waveform Dogrulamasi

[KAYNAK: M09]

'R' (0x52) gonderiminde tx_o pini gozlemlendi:
   start (1->0) -> 8 data bits (LSB first) -> stop (0->1)

Tam 8 bit gec0is + 1 stop gec0is = 9 edge gozlendi. Cycle araligi
CPB=16 ile uyumlu (16 cycle/bit). UART standardina uygun.

### 7.4 AXI4-Lite Slave Bagimsiz Dogrulama

[KAYNAK: M18-M22 simulasyon ciktilari]

Sartname §4.1 ve EK-2 geregi 5 cevre birim AXI4-Lite slave olarak 
yeniden yazildi. Her biri icin bagimsiz testbench olusturuldu ve 
calistirildi:

| Modul | Yazmac sayisi | Test senaryo | Transaction | Sonuc |
|---|---|---|---|---|
| ram_axi (M18) | parametreli (IRAM/DRAM) | 4 | 4 write + 4 read | PASS |
| **boot_rom_axi (M29)** | **ram_axi WRITE_ENABLE=0** | **6** | **6 read** | **PASS** |
| **uart_rx_axi (M53)** | **uart_axi.sv (RX FSM eklendi, 364 satir)** | **5** | **5 write+read** | **PASS** |
| gpio_axi (M19) | 2 (IDR, ODR, 32-bit) | 4 | 2 write + 3 read | PASS |
| timer_axi (M20) | 8 (PRE/ARE/CLR/ENA/MOD/CNT/EVN/EVC) | 5 | 7 write + 5 read | PASS |
| uart_axi (M21) | 5 (CPB/STP/RDR/TDR/CFG) | 6 | 4 write + 4 read | PASS |
| **uart_dual_axi (M31)** | **uart_axi 2 instance** | **6** | **3 write + 3 read** | **PASS** |
| i2c_master_axi (M22) | 5 (NBY/ADR/RDR/TDR/CFG) | 5 | 5 write + 5 read | PASS |

Toplam: 42 cesitli test senaryo, **54 transaction** (Boot ROM + Dual UART + UART RX dahil), 0 hata.

Tum modullerde sartname EK-2 yazmac haritalari birebir uyumlu. 
Tum modullerde lint temizligi (0 warning, 0 error) saglandi.

### 7.5 AXI4-Lite Bridge Dogrulama

[KAYNAK: M17 Faz 1 simulasyon ciktilari]

Cekirdek (CV32E40P) OBI protokolu uretiyor. AXI4-Lite ara baglantiya 
gec0is icin OBI -> AXI4-Lite kopru modulu (obi_to_axi_lite.sv) 
yazildi. 6 durumlu state machine ile AXI4-Lite'in 5 kanali 
(AW, W, B, AR, R) yonetiliyor.

Bagimsiz testbench (obi_to_axi_lite_tb.sv) sonuclari:

- Test 1: Tek WRITE transaction - PASS
- Test 2: Tek READ transaction - PASS  
- Test 3: Back-to-back 5 WRITE - 5/5 PASS
- Test 4: Back-to-back 5 READ - 5/5 PASS

Toplam: 6 write + 6 read = 12 transaction, 0 hata.

### 7.6 AXI4-Lite Protocol Check (Sartname §5.2 Min. Kriter #3)

[KAYNAK: M23 simulasyon ciktilari]

Sartname §5.2 minimum basari kriteri #3:
> "Cevre birimleri ve YZ hizlandiricinin {AXI or AXI-Lite} 
> arayuzlerinin en azindan protocol check duzeyinde AXI 
> agent'lariyla dogrulanmasi"

Bu kriter SVA (SystemVerilog Assertions) yontemi ile karsilandi.
5 ana AXI4-Lite spec kurali yazildi:

1. AW handshake stability (AWVALID dustu mu AWREADY'siz?)
2. W handshake stability (WVALID dustu mu WREADY'siz?)
3. B response stability (BVALID + BRESP degisti mi BREADY'siz?)
4. AR handshake stability (ARVALID dustu mu ARREADY'siz?)
5. R response stability (RVALID + RDATA + RRESP degisti mi RREADY'siz?)

3 modulde bind ile bagli:

| Modul | AW count | W count | B count | AR count | R count | FAIL |
|---|---|---|---|---|---|---|
| ram_axi (M23) | 4 | 4 | 4 | 4 | 4 | 0 |
| boot_rom_axi (M29) | 0 | 0 | 0 | 6 | 6 | 0 |
| gpio_axi (M23) | 2 | 2 | 2 | 3 | 3 | 0 |
| timer_axi (M23) | 7 | 7 | 7 | 5 | 5 | 0 |
| uart_axi-0 (M31) | 6 | 6 | 6 | 5 | 5 | 0 |
| uart_axi-1 (M31) | 4 | 4 | 4 | 1 | 1 | 0 |
| **TOPLAM** | **23** | **23** | **23** | **24** | **24** | **0** |

Toplam handshake gozlemi: **117** (M23: 63 + M29: 12 + M31: 38)
Toplam kural degerlendirmesi: 5 kural × 117 = 585
ASSERT FAIL sayisi: 0

Sartname minimum basari kriteri #3 KARSILANDI.

### 7.7 Genel Dogrulama Ozeti

| Kategori | Test sayisi | Transaction | Hata |
|---|---|---|---|
| OBI self-checking (M01-M10) | 4 program | 4+13+999 = 1016 | 0 |
| OBI Protocol Check (M07) | 3 SVA | 1000 cycle | 0 |
| AXI Slave bagimsiz (M18-M22) | 25 senaryo | 37 | 0 |
| Boot ROM (M29) | 6 senaryo | 6 | 0 |
| Dual UART (M31) | 6 senaryo | 6 | 0 |
| AXI Bridge (M17) | 4 senaryo | 12 | 0 |
| AXI Protocol Check (M23+M29+M31) | 5 SVA × 7 instance | **117 handshake** | 0 |
| **TOPLAM** | **56 senaryo + 8 SVA** | **49 fonksiyonel + 117 handshake = 166 AXI** | **0** |

### 7.8 Regression Suite ve Coverage (M41, M42)

**Regression Suite (run_regression.sh):**
8 AXI4-Lite testbench tek komutla otomatik dogrulama yapar.
- Sonuc: **10/10 PASS, 62 transaction, 113 handshake, 0 FAIL** (M65, 13 May, screenshot 22, YZ CSR dahil)
- Kanit: docs/screenshots/11_regression_passed.png

**Coverage Raporu (docs/COVERAGE_RAPORU.md):**
6 RTL modul detayli senaryo tabanli kapsama analizi:
- Ortalama line coverage: ~%82
- Ortalama toggle coverage: ~%75
- 62 PASS senaryosu, 113 handshake AXI Protocol Check (UART RX + YZ CSR dahil)
- Detay: docs/COVERAGE_RAPORU.md (199 satir)

**Bootloader Cift Dogrulama (M46):**
- Compile-time: riscv-none-elf-objdump ile makine kodu (lui t0,0x10 -> jr t0)
- Run-time: boot_rom_axi_tb.sv Test 2-3 ayni adresleri okur
- Kanit: docs/screenshots/16_bootloader_disassembly.png

GitHub repository'de detayli simulator ciktilari, build script'leri 
ve test programlari mevcuttur (80+ commit, sigorta tag'leri: 
dtr-pre-axi-m17, m22-axi-slaves-done).

---

## 8. Karsilasilan Zorluklar ve Cozumler (Sablon disi destek)

DTR donemi boyunca yasanan teknik zorluklar bu bolumde **acik ve net 
bicimde** belgelenmistir. Sartname Sunum Puani kriteri (eksikliklerin 
acik anlatimi) bu yaklasimi dogrudan odullendirmektedir.

Bu bolum kronolojik olarak en buyuk zorluktan (AXI4-Lite gec0isi) 
baslar ve sonuc cikarimlariyla biter.

### 8.1 OBI -> AXI4-Lite Gec0isi (En Buyuk Zorluk)

#### Sorun Tespiti

3 May 2026 (Milestone M16) tarihinde takim sartnameyi yeniden 
inceledigi sirada **kritik bir uyumsuzluk** tespit etti:

**Sartname §4.1:** "Bus arayuzu AXI4-Lite olmalidir."

Mevcut sistem ise CV32E40P cekirdeginin native arayuzu olan **OBI** 
(Open Bus Interface) ile yazilmisti. Tum 5 cevre birim (RAM, GPIO, 
Timer, UART, I2C) OBI tabanli olarak gerc0eklenmisti (M01-M15).

#### Risk Analizi

- DTR teslimine 12 gun kalmisti
- 5 modul + soc_top tum sistem AXI4-Lite olmaliydi
- Yanlis tahmin durumunda 8+ gunluk kayip riski
- Sartname §5.2 #3 minimum kriter dogrudan ihlal

#### Cozum Stratejisi

Takim **3 ana karar** aldi:

1. **Sigorta tag at:** `git tag -a dtr-pre-axi-m17` ile mevcut 
   calisma durumu kayit altina alindi. Geri donus garantisi.

2. **8 fazli planli gec0is:** Her modul ayri faza atandi (M17-M23). 
   Her faz tamamlandiginda commit + tag ile sigortalandi.

3. **Bagimsiz testbench yaklasimi:** soc_top entegrasyonunu 
   beklemeden, her AXI4-Lite slave kendi testbench'inde dogrulandi. 
   Bu sayede 5 modul paralel olarak test edilebildi.

#### Uygulama (M17-M23, 3-5 May, 5 Gun)

| Faz | Milestone | Sure | Sonuc |
|-----|---|---|---|
| 1 | M17 - obi_to_axi_lite Bridge | 1 gun | 12/12 PASS |
| 2 | M18 - ram_axi.sv | 0.5 gun | 4/4 PASS |
| 3 | M19 - gpio_axi.sv | 0.5 gun | 5/5 PASS |
| 4 | M20 - timer_axi.sv | 0.5 gun | 5/5 PASS |
| 5 | M21 - uart_axi.sv | 1 gun | 6/6 PASS |
| 6 | M22 - i2c_master_axi.sv | 1 gun | 5/5 PASS |
| 7 | (soc_top) | - | Final'e ertelendi |
| 8 | M23 - AXI Protocol Check | 1 gun | 63 handshake/0 FAIL |

#### Sonuc

5 gunluk planli gec0is sonucunda:

- 6 yeni AXI4-Lite RTL modulu yazildi (~1500 satir)
- 8 testbench olusturuldu
- 37 fonksiyonel transaction PASS
- 63 AXI handshake, 0 ASSERT FAIL
- **Sartname §4.1 ve §5.2 #3 KARSILANDI**

Bu zorluk, takim disiplinli bir planlama ve risk yonetimi 
yaklasimiyla ele alindi; **aci kayip yasamadan** sartname uyumu 
saglandi.

### 8.2 Boot ROM Eklenmesi (M29)

#### Sorun Tespiti

7 May 2026 sabahi sartname §4.2.2.1 net olarak boot ROM gerektiriyor:
"Sistem hizmeti boot vektoru 0x00 adresinde baslamali, Boot ROM 
icerisinde bootloader bulunmali (512B-1KB)"

Mevcut sistemde 0x0000_0000 adresinde dogrudan IRAM vardi. 
OTR Tablo 1 ise Boot ROM 512 B (0x0000_0000-0x0000_01FF) belirliyordu.

#### Cozum: Muhendislik Zarafeti

Yeni RTL yazimi yerine ram_axi.sv'nin parametreli yapisi kullanildi:
- SIZE_WORDS = 128 (512 byte)
- WRITE_ENABLE = 0 (read-only)
- MEM_FILE = "bootloader.hex"

Yapilanlar:
1. bootloader.S (46 satir) RV32IMC ile derlendi
2. bootloader.hex (128 satir, 512 byte) uretildi
3. boot_rom_axi_tb.sv (198 satir) testbench yazildi
4. 6/6 test PASS, 12 AXI handshake, 0 FAIL

#### Sonuc

- Plan suresi: 3 saat, gerc0eklesen: 1 saat
- Yeni RTL: 0 satir (yeniden kullanim)
- Sartname §4.2.2.1 KARSILANDI

### 8.3 Dual UART Eklenmesi (M31)

#### Sorun Tespiti

Sartname §4.2.2 ve OTR Tablo 1 net:
- UART-0: 0x4000_2000 (genel kullanim)
- UART-1: 0x4000_3000 (YZ veri akisi/stream)

Mevcut sistemde tek UART (M21) vardi.

#### Cozum

Boot ROM ile ayni stratejide: uart_axi.sv'nin 2. instance'i kullanildi.
Tek testbench (uart_dual_axi_tb.sv, 289 satir) iki instance'i 
birlikte test etti.

#### Sonuc

- Sure: 30 dakika
- Yeni RTL: 0 satir
- Test sonucu: 6/6 PASS, 38 AXI handshake, 0 FAIL
- 'U', 'S', '1' karakterleri ekranda gozlendi
- Sartname §4.2.2 2x UART KARSILANDI

### 8.4 Muhendislik Zarafeti Ilkesi

Boot ROM (M29) ve Dual UART (M31) ornekleri ortak bir prensibi 
kanitlar:

| Zorluk | Naive Cozum | ZUGA-IC Cozumu |
|---|---|---|
| Boot ROM | Yeni boot_rom.sv yaz | ram_axi parametreli (3 amac) |
| 2x UART | uart2_axi.sv yaz | uart_axi 2 instance |

**Avantajlar:**
- Yeni RTL bug riski sifir
- Dogrulama yuku minimum
- Lint warning sayisi 0
- OTR §3.6 moduler hiyerarsi ilkesi ile uyumlu
- Tek modul birden fazla kullanim (DRY ilkesi)

### 8.5 Faz 1 Sorunlari (M01-M09 Donemi - Referans)

DTR doneminin baslarinda yasanan ve cozulen kucuk olcekli teknik 
zorluklar:

- **CV32E40P entegrasyonu (M01):** cv32e40p_top fpnew_pkg gerektiriyor; 
  cv32e40p_core dogrudan kullanildi, APU tie-off
- **OBI rdata gec0ikme (M01):** instr_addr_q flip-flop eklendi
- **OBI bus select latch (M02):** sel_x_q flip-flop'lar ile cozuldu
- **Verilator SVA kisitlamalari (M07):** SVA'dan vazgec0ildi, 
  always_ff + $display ile cozuldu
- **UART Faz 1 -> Faz 2 (M09):** $write yerine 10-bit TX state 
  machine + baud generator
- **Test geri uyumluluk (M15):** Tum 3 test programi yeniden 
  derlendi (lui + sw offset)

Bu sorunlar **DTR doneminin ilk haftasinda** cozuldu, AXI gec0isi 
oncesinde sistem kararliliga ulasmisti.

### 8.6 Sonuc ve Cikarimlar

DTR donemi boyunca yasanan en buyuk zorluk **OBI -> AXI4-Lite 
gec0isi** (M16-M23), takim disiplinli planlama ile **5 gunde** 
cozuldu. Diger iki onemli ekleme (Boot ROM M29, Dual UART M31) 
**muhendislik zarafeti** ilkesiyle yeni RTL yazilmadan tamamlandi.

**Anahtar cikarimlar:**

1. **Erken sartname analizi kritik:** M16'da yapilan sartname yeniden 
   okumasi olmasaydi, AXI eksikligi DTR teslim sirasinda kesfedilirdi 
   (bu durumda cozulemezdi).

2. **Sigorta tag stratejisi etkili:** dtr-pre-axi-m17 ve 
   m22-axi-slaves-done tag'leri risk yonetiminde guven sagladi.

3. **Bagimsiz testbench paralellik getirir:** soc_top entegrasyonunu 
   beklemeden modul bazinda dogrulama mumkun oldu.

4. **Yeniden kullanim guc:** ram_axi (3 amac) ve uart_axi (2 instance) 
   ornekleri yeni RTL bug riskini sifirladi.

5. **Seffaflik puan getirir:** Sartname Sunum Puani kriteri 
   eksikliklerin acik anlatimini odullendirdigi icin, bu raporda 
   tum zorluklar acikca belgelendi.

## 9. FPGA Hazirligi (Sablon Bolum 2.4: FPGA Prototipleme, 5p)

DTR donemi sonunda **soc_top_axi.sv (M49)** tam AXI4-Lite SoC entegrasyonu
tamamlanmis ve Vivado FPGA sentezi icin hazirlik **tamamlanmistir**. Sentez
seansi 13-14 Mayis 2026'da Umur Bugra Dikmen ile gerc0eklestirilecek olup
**utilization, timing analizi ve schematic** sonuclari Vivado ekran
goruntuleri ile teslime kadar DTR'ye eklenecektir.

### 9.1 Hazirlik Durumu (12 Mayis itibariyle)

| Bilesen | Durum | Detay |
|---|---|---|
| Top module RTL | TAMAM | soc_top_axi.sv M49, 520 satir, lint TEMIZ |
| CV32E40P entegrasyonu | TAMAM | OpenHW Group resmi RTL |
| OBI->AXI4-Lite Bridge | TAMAM | obi_to_axi_lite.sv M17, 200 satir, 12/12 PASS |
| 6 AXI4-Lite slave | TAMAM | DRAM + GPIO + Timer + UART-0 + UART-1 + I2C |
| Constraint dosyasi | TAMAM | constraints/arty_a7.xdc, 56 satir |
| Memory map | TAMAM | OTR Tablo 1 birebir |
| Lint kontrolu | TEMIZ | 0 hata, 0 uyari (ZUGA-IC kodu) |
| Vivado sentez | BEKLEMEDE | 13-14 May, Umur ile |

### 9.2 Hedef FPGA Platformu

- **FPGA Kartı:** Xilinx Arty A7-100T (Digilent)
- **FPGA Yongasi:** XC7A100TCSG324-1 (Artix-7, 101440 logic cell)
- **Hedef saat:** 50 MHz (CV32E40P tipik calisma frekansi)
- **Cevre baglantilari:** USB-UART kopru, 4 LED, 4 switch, 4 push button

Arty A7-100T sec0imi: CV32E40P RV32IM icin yeterli kaynak (~10K LUT tahmini),
USB-UART kopru entegre (terminal log icin pratik), maliyet erisilebilir
(~$100), TEKNOFEST gec0miste benzer kartlari onerdi.

### 9.3 Top Module: soc_top_axi.sv (M49, Faz 7)

soc_top_axi.sv (520 satir) Harvard mimari uzerine kurulmustur:

- **Instr port:** Basit BRAM (Boot ROM 128 word + IRAM 2048 word, sentez sirasinda BRAM inferred)
- **Data port:** AXI4-Lite Bridge -> AXI4-Lite Decoder -> 6 slave
- **6 AXI4-Lite slave:** Memory Map OTR Tablo 1 ile birebir uyumlu
  - 0x0002_0000: DRAM (8 KB)
  - 0x4000_0000: GPIO (8 B)
  - 0x4000_1000: Timer (32 B)
  - 0x4000_2000: UART-0 (20 B, RX+TX)
  - 0x4000_3000: UART-1 (20 B, Stream)
  - 0x4000_4000: I2C Master (20 B)

**Lint sonucu:** `lint_soc_top_axi.sh` script'i ZUGA-IC kodumuzda **0 hata 0 uyari** vermistir (CV32E40P upstream BLKANDNBLK uyarilari Verilator-spesifik, Vivado sentez aracını engellemez). Kanit: docs/screenshots/17_soc_top_axi_lint.png

### 9.4 Constraint Dosyasi (arty_a7.xdc)

constraints/arty_a7.xdc (56 satir) Arty A7-100T tum pin atamalarini ic0erir:
- **System clock:** E3 (100 MHz, /2 ile 50 MHz cekirdek)
- **Reset:** D9 (cpu_resetn, push button)
- **UART:** D10 (uart_tx), A9 (uart_rx)
- **LED:** H5, J5, T9, T10 (4 LED)
- **Switch:** A8, C11, C10, A10 (4 switch)
- **Push button:** D9, C9, B9, B8 (4 PB)
- **IO standard:** LVCMOS33, CFGBVS 3.3V
- **Timing constraint:** create_clock 10 ns periyot

### 9.5 Vivado Sentez Adimlari (Planli)

1. **Vivado 2023.1 ac, RTL Project olustur**
2. **Part sec:** XC7A100TCSG324-1
3. **RTL ekleme sirasi (paket bagimliligi kritik!):**
   - cv32e40p_pkg.sv, cv32e40p_apu_core_pkg.sv, cv32e40p_fpu_pkg.sv (paketler ONCE)
   - cv32e40p_*.sv (15 modul)
   - obi_to_axi_lite.sv
   - ram_axi.sv, gpio_axi.sv, timer_axi.sv, uart_axi.sv, i2c_master_axi.sv
   - soc_top_axi.sv (TOP MODULE!)
4. **Constraint ekle:** arty_a7.xdc
5. **Run Synthesis (1-2 dk surer)**
6. **Beklenen ciktilar:**
   - Utilization Report (LUT/FF/BRAM/DSP kullanim)
   - Timing Summary (50 MHz hedef met edildi mi?)
   - Schematic (post-synth)
   - Synthesis log (warnings/errors)

### 9.6 Beklenen Sonuclar (Tahmini)

| Metrik | Tahmin | Gerekc0e |
|---|---|---|
| LUT | ~8000-12000 | CV32E40P tipik (kucuk RV32IM) + 6 AXI slave |
| FF | ~6000-9000 | Pipeline + buffer registerlari |
| BRAM | ~5-10 | Boot ROM + IRAM + DRAM + buffers |
| DSP | 4 | CV32E40P multiplier |
| Maks frekans | 50+ MHz | Hedef met (CV32E40P kanitlanmis) |
| Slack | pozitif | Timing temiz beklenir |

### 9.7 Vivado Sonrasi Eklenecek Screenshot'lar

Vivado sentez seansi sonrasi DTR'ye eklenecek 3 yeni gorsel:
- 21_vivado_synthesis_summary.png (utilization tablosu)
- 22_vivado_timing_report.png (slack ve max frequency)
- 23_vivado_schematic.png (post-synth blok diyagrami)

Bu eklemelerle DTR Bolum 9 sablon §2.4 FPGA Prototipleme **5p tam karsilanir**.

### 9.8 FPGA Bitstream ve Demo (Final Donemi)

Bitstream uretimi ve gerc0ek Arty A7-100T uzerinde calistirma **Final donemi**
(1-21 Haziran 2026) hedefidir. Bu asamada:
- bitstream uretimi (.bit dosyasi)
- FPGA programlama (Digilent USB cable)
- LED hello world demo (UART'tan 'A' karakteri + LED toggle)
- UART RX gerc0ek terminal testi (5/5 PASS demo gerc0ek donanim uzerinde)

## 10. Sartname Odul Kriterleri Durumu (Sablon disi - sartname uyum izleme)

[KAYNAK: Sartname Madde 5.2 - Minimum Basari Kriterleri]

Sartnamede tanimli 5 minimum odul kriterinden DTR donemi sonu durumu:

| # | Kriter | DTR Durumu | Final Hedefi |
|---|---|---|---|
| 1 | FPGA + 2 cevre birim | RTL hazir, **9-10 May Vivado sentez** planlandi | Bitstream + canli demo |
| 2 | Self-checking test | **KARSILANDI** (5 SW PASS + run_regression.sh **10/10 PASS, 62 tx**) | UVM coverage collector |
| 3 | AXI/AXI-Lite Protocol Check | **KARSILANDI** (5 SVA, **117 handshake**, 0 FAIL) | UVM agent eklenmesi |
| 4 | YZ test | Plan (Final donem) | Tam YZ hizlandirici (TFLite Tiny) |
| 5 | GDSII | Plan (Final donem) | Sky130 + OpenLane akis |

**DTR donemi sonu: 2 kriter TAM KARSILANDI, 1 kriter hafta sonu 
tamamlanacak (Vivado), 2 kriter Final teslimi icin planlandi.**

### 10.1 Kriter #2 Detayi - Self-Checking Test

[KAYNAK: M03, M04, M06, M08]

4 RISC-V assembly test programi yazildi ve hepsi PASS:

| Test | Amac | Beklenen Cikis | Sonuc |
|---|---|---|---|
| hello.S | UART smoke test | Hi (yeni satir) | PASS |
| test_gpio.S | GPIO write+read+kontrol | P (yeni satir) | PASS |
| test_timer.S | Timer CLR+ENA+CNT+kontrol | T (yeni satir) | PASS |
| test_full.S | 3 modul + 5 yazmac regression | "RUN(yeni satir)PASS(yeni satir)" | PASS |
| **bootloader.S (M29)** | **Boot ROM, lui+jr IRAM jump** | **0x10000 jump (disassembly)** | **PASS** |

**Otomatik regression:** `run_regression.sh` (M41) ile tek komutla 
10 testbench dogrulamasi (62 transaction, 113 handshake, **10/10 PASS, M65 13 May**, YZ CSR dahil). 
Kanit: docs/screenshots/11_regression_passed.png

Tum testler conditional branch (beq) ile basari/basarisizlik dali 
ayrimi yapar, jurinin "self-checking" tanimini birebir karsilar.

### 10.2 Kriter #3 Detayi - AXI4-Lite Protocol Check (KARSILANDI)

[KAYNAK: M23 - Faz 8 - Sartname Min. Kriter #3]

Sartname §5.2 minimum kriter #3 metni:
> "Cevre birimleri ve YZ hizlandiricinin {AXI or AXI-Lite} 
> arayuzlerinin **en azindan protocol check duzeyinde** AXI 
> agent'lariyla dogrulanmasi"

Bu kriter SVA (SystemVerilog Assertions) yontemi ile karsilandi:

**5 ana AXI4-Lite spec kurali:**
1. AW (Write Address) handshake stability - AWVALID dustu mu AWREADY'siz?
2. W (Write Data) handshake stability - WVALID dustu mu WREADY'siz?
3. B (Write Response) stability - BVALID + BRESP degisti mi BREADY'siz?
4. AR (Read Address) handshake stability - ARVALID dustu mu ARREADY'siz?
5. R (Read Response) stability - RVALID + RDATA + RRESP degisti mi?

**6 modul instance'inda bind ile bagli (M23, M29, M31):**

| Modul | AW | W | B | AR | R | FAIL |
|---|----|----|----|----|----|---|
| ram_axi (M23) | 4 | 4 | 4 | 4 | 4 | 0 |
| boot_rom_axi (M29) | 0 | 0 | 0 | 6 | 6 | 0 |
| gpio_axi (M23) | 2 | 2 | 2 | 3 | 3 | 0 |
| timer_axi (M23) | 7 | 7 | 7 | 5 | 5 | 0 |
| uart_axi-0 (M31) | 6 | 6 | 6 | 5 | 5 | 0 |
| uart_axi-1 (M31) | 4 | 4 | 4 | 1 | 1 | 0 |
| **TOPLAM** | **23** | **23** | **23** | **24** | **24** | **0** |

**Toplam: 117 handshake gozlemi, 5 × 117 = 585 kural degerlendirmesi, 
0 ASSERT FAIL.**

**Coverage detayi:** docs/COVERAGE_RAPORU.md (M42, 199 satir manuel 
analiz, ortalama %82 line / %75 toggle coverage).

GitHub repository: tb/axi_lite_assertions.sv (145 satir, 5 SVA + 5 
coverage counter)

### 10.3 Kriter #1 Plan (Vivado Sentez)

#1 (FPGA + 2 cevre birim): RTL ve constraint dosyalari M10'da hazir 
(`constraints/arty_a7.xdc`, 14 pin atamasi). 

**9-10 May (hafta sonu) Vivado sentez seansi:**
- Sorumlu: Umur Bugra Dikmen + Betul Bedir
- Hedef: Sentez basarili, kaynak kullanim raporu, STA sonucu
- Sure: 1.5-2 saat
- Sonuc: 3 yeni screenshot DTR raporuna (mevcut 16 -> 19 PNG)

DTR'de "FPGA hazirligi tamamlandi" demek icin sentez sonucu 
zorunludur (Sartname §3.2.2). Hafta sonu seansi sonrasi Bolum 9 
(FPGA Hazirligi) sentez raporu eklenecek.

### 10.4 Kriter #4 ve #5 (Final Donemi)

**Kriter #4 (YZ test):** ÖNTR'de Tiny Conv hedefi belirtildi. RTL 
iskelet Final donemi yazilacak (MAC + FSM + CSR + test). Tam Conv1D 
+ Depthwise + FC katmanlari Sartname EK-1'de detayli.

**Kriter #5 (GDSII):** Sky130 + OpenLane akis. Final donemi tam 
yeni teknoloji. Cip Akisi puaninin (%20) tamami buradan gelmektedir.

---
## 11. Takvim ve Kalan Is (Sablon Bolum 6: Is Plani ve Risk Planlamasi, 5p - bolum 1/2)

### 11.1 Tamamlanan Donem (16 Mart - 7 Mayis 2026)

DTR donemi 60 milestone ile dort ana fazda yurutuldu (M01-M60). Her milestone 
ayri git commit ve milestone .md dokumani ile kayit altina alindi.

**Faz 1 - SoC Iskelet (16 Mart - 27 Nisan, M01-M10):**

| Tarih | Milestone | Aciklama |
|---|---|---|
| 16 Mart | OTR teslim | Ontasarim Raporu (8 sayfa, OTR Tablo 1) |
| 22 Nis  | M01 | CV32E40P "Hi" - ilk fonksiyonel test |
| 23 Nis  | M02 | Modular SoC + OBI bus iskelet |
| 23 Nis  | M03 | GPIO + 'P' karakter testi |
| 23 Nis  | M04 | Timer + 'T' karakter testi |
| 26 Nis  | M05 | IRAM/DRAM ayrimi (Harvard mimari) |
| 26 Nis  | M06 | EK-2 uyumlu UART (Faz 1) |
| 26 Nis  | M07 | OBI SVA Protocol Check |
| 27 Nis  | M08 | Comprehensive self-checking test |
| 27 Nis  | M09 | UART Faz 2 (gercek HW) |
| 27 Nis  | M10 | FPGA Top-Level Wrapper (Arty A7) |

**Faz 2 - Cevre Birimleri (28 Nisan - 3 Mayis, M11-M16):**

| Tarih | Milestone | Aciklama |
|---|---|---|
| 28 Nis  | M11 | DTR sablon hazirligi |
| 29 Nis  | M12 | YZ Hizlandirici planlama |
| 1 May | M13 | Mimari diyagram (Mermaid) |
| 1 May | M14 | I2C Master iskelet |
| 2 May | M15 | I2C Master tam implementasyon |
| 3 May | M16 | Sartname yeniden okuma - AXI4-Lite gerekli tespit edildi |

**Faz 3 - AXI4-Lite Gec0is (3-5 Mayis, M17-M23):**

| Tarih | Milestone | Aciklama |
|---|---|---|
| 3 May | M17 | obi_to_axi_lite Bridge (12/12 PASS) |
| 3 May | M18 | ram_axi.sv parametreli (4/4 PASS) |
| 3 May | M19 | gpio_axi.sv 32-bit EK-2 (5/5 PASS) |
| 3 May | M20 | timer_axi.sv 8 yazmac EK-2 (5/5 PASS) |
| 3 May | M21 | uart_axi.sv (6/6 PASS, 'A' ekranda) |
| 3 May | M22 | i2c_master_axi.sv (5/5 PASS, 415 satir) |
| 3 May | M23 | AXI Protocol Check (5 SVA, 63 handshake/0 FAIL) |

**Faz 4 - DTR Hazirlik + Bonus (5-7 Mayis, M24-M33):**

| Tarih | Milestone | Aciklama |
|---|---|---|
| 5 May | M24 | DTR rapor AXI sonuclari ile guncellendi |
| 5 May | M25 | 6 simulator screenshot |
| 5 May | M26 | README.md kapsamli yenileme (421 satir) |
| 7 May | M27 | DTR Bolum 10, 13 guncelleme |
| 7 May | M28 | GitHub + git tag screenshot, tag annotated |
| 7 May | M29 | **Boot ROM** (ram_axi.sv yeniden kullanim, 6/6 PASS) |
| 7 May | M30 | DTR Memory Map OTR uyumlu (1127 satir) |
| 7 May | M31 | **Dual UART** (uart_axi.sv 2 instance, 'U' 'S' '1') |
| 7 May | M32 | DTR UART-1 M31 OK guncelleme |
| 7 May | M33 | UART-dual + Lint screenshots (10 gorsel kanit) |

### 11.2 Kalan Is (8-15 Mayis 2026)

DTR teslimine **8 gun** kaldi. Plan asagidaki sekilde organize edildi:

| Tarih | Is | Sure | Sorumlu | Onem |
|---|-----|---|---|---|
| 8 May Cuma | Vivado randevu (Umur'a yaz) | 30 dk | Betul | Orta |
| 8 May Cuma | Mermaid -> PNG donusumu | 30-60 dk | Betul | Orta |
| **9-10 May Hafta sonu** | **Vivado sentez seansi** | **2 saat** | **Umur + Betul** | **KRITIK** |
| 11 May Pzt | DTR Bolum 9 (FPGA) Vivado sonuclari ile guncelle | 1 saat | Betul | Yuksek |
| 11 May Pzt | DTR Bolum 4 (Modul Detaylari) Boot ROM + Dual UART ekle | 45 dk | Betul | Yuksek |
| 12 May Sal | DTR Bolum 6 (Dogrulama Metodolojisi) AXI Protocol Check | 30 dk | Betul | Orta |
| 12 May Sal | DTR Bolum 8 (Karsilasilan Zorluklar) AXI gec0is hikayesi | 30 dk | Betul | Orta |
| 13 May Car | DTR PDF uretimi (pandoc, A4, 11 punto Calibri, 1.15 satir) | 4 saat | Betul | KRITIK |
| 14 May Per | Format kontrol + sayfa sayisi (max 30) | 4 saat | Betul | KRITIK |
| **15 May Cum 17:00** | **DTR TESLIM** | - | - | - |

**Hafta sonu Vivado seansi cok kritik:**
- Sentez raporu DTR Bolum 9 icin gerekli
- Sartname §3.2.2 zorunlu (sentez sonuclari)
- Sartname §5.2 #1 minimum kriter (FPGA + 2 cevre birim)
- 3 yeni screenshot beklenen (sentez, kaynak kullanim, timing)

### 11.3 Final Donemi (16 Mayis - 31 Temmuz 2026)

DTR sonrasi Final teslim donemi 11 hafta. Plan:

| Donem | Is | Sure |
|---|-----|---|
| 8 May | **Faz 7 (M49): soc_top_axi TAMAMLANDI** | TAMAM |
| 1-21 Haz | YZ Hizlandirici (TFLite Micro Speech Tiny Conv, MAC + FSM + CSR + 30 KB SRAM) | 3 hafta |
| 8 May | **UART RX (M53): TAMAMLANDI** 5/5 PASS TX->RX loopback | TAMAM |
| 22 Haz - 5 Tem | QSPI Master (x1/x2/x4) + UVM Agent | 2 hafta |
| 6-20 Tem | GDSII akisi (Sky130 + OpenLane veya Synopsys DC) | 2 hafta |
| 21-30 Tem | Final test + dokumantasyon + demo hazirligi | 1.5 hafta |
| **31 Tem 17:00** | **FINAL TESLIM** | - |

**Opsiyonel bonus:** JTAG Debug Modulu (pulp-platform/riscv-dbg, +3 puan) - 
zaman izin verirse Haziran sonunda eklenebilir.

### 11.4 Kalan Olcumler (Sayisal Ozet)

DTR donemi sonu (7 Mayis 2026):

| Metrik | Mevcut | Hedef (15 May) |
|---|---|---|
| RTL modul | 13 (5 AXI4-Lite slave) | 13 (degismeyecek) |
| Testbench | 11 | 11 |
| AXI fonksiyonel test | 49 PASS | 49 |
| AXI Protocol Check | 106 handshake, 0 FAIL | 106+ |
| Lint warning/error | 0/0 | 0/0 |
| DTR raporu | 1127 satir | ~1300 satir |
| Sayfa (PDF) | - (henuz uretilmedi) | <30 (sartname siniri) |
| Ekran goruntusu | 10 | 13 (Vivado +3) |
| Mermaid diyagrami | 3 (.md icinde) | 3 PNG |
| GitHub commit | **80** (12 May) | ~85 (15 May tahmini) |

---
## 12. Risk Analizi (Sablon Bolum 6: Is Plani ve Risk Planlamasi, 5p - bolum 2/2)

Bu bolum sartname Sunum Puani kriteri geregi, eksiklerin acik bir 
sekilde anlatimini icermektedir. Riskler uc grupta sunulmustur:

### 12.1 DTR'ye Kadar Olan Riskler (15 Mayis Hedef)

**Risk 1: Vivado sentez basarisiz olabilir** [YUKSEK]
- Olasilik: Orta
- Etki: Yuksek (Sartname §3.2.2 zorunlu kiliyor)
- Azaltma: Hafta sonu (3-4 May) Umur Bugra Dikmen ile birlikte 
  1.5-2 saatlik seans planlandi. Eger kritik yol uyarisi cikarsa 
  pipelining ekleme veya saat hedefini dusurme secenekleri var.
  Sentez sonuclari DTR'ye eklenecek.

**Risk 2: Boot ROM + Memory Map degisikligi regression yaratabilir** [ORTA]
- Olasilik: Orta
- Etki: Orta-Yuksek
- Azaltma: Mevcut testler icin sigorta tag'i (m22-axi-slaves-done) 
  konuldu. Boot ROM ekleme oncesi/sonrasi tam regression 
  calistirilacak. Hata ciktiginda git revert ile geri donus mumkun.

**Risk 3: DTR PDF formati sartname spesifikasyonunu karsilamayabilir** [DUSUK]
- Olasilik: Dusuk
- Etki: Orta (format puani)
- Azaltma: Pandoc ile markdown -> PDF donusumu test edildi. 
  Format spesifikasyonu (A4, 11 punto Calibri, 1.15 satir, 
  max 30 sayfa, max 60 MB) hazirlanirken dogrulanacak.

### 12.2 Bilincli Olarak Erteleyen Eksikler

Asagidaki maddeler bilincli olarak Final teslime (31 Temmuz) 
ertelendi. Bunlar DTR puanini dogrudan etkilemiyor cunku alt-sistem 
testleri ile yeterli kanit saglandi.

**Tamamlanan: soc_top Tam AXI4-Lite Entegrasyonu (Faz 7, M49)**
- Mevcut durum: 5 AXI4-Lite slave bagimsiz test edildi 
  (37/37 transaction PASS), AXI Bridge 12/12 PASS, AXI Protocol 
  Check 3 modulde 63 handshake / 0 FAIL.
- Eksiklik: soc_top.sv hala OBI tabanli decoder kullaniyor. 
  AXI4-Lite tam entegrasyon Final dönemi yapilacak.
- Risk azaltma: DTR'de alt-sistemlerin tek tek dogrulanmasi 
  (5 slave + bridge + 5 SVA assertion) yeterli kanit sagliyor. 
  Sartname §5.2 minimum basari kriteri #3 (AXI protocol check 
  duzeyi) bagimsiz testlerle karsilandi.

**Eksik 2: Boot ROM + Memory Map Reorganizasyonu** (DTR'ye kadar yapilacak)
- Sartname §4.2.2.1: QSPI'dan boot, bootloader ROM 512B-1KB
- Mevcut: Program direkt IRAM 0x00 adresinde calisiyor, 
  Boot ROM yok. ÖNTR'de Boot ROM 0x00'da, IRAM 0x10000'da 
  belirtilmisti, basitlestirme yapildigindan sapma var.
- Plan: Hafta 2 basi (5-6 May), 1.5-2 gunluk is.

**Eksik 3: 2. UART Instance (UART-stream)** (DTR'ye kadar yapilacak)
- Sartname §4.2.2: 2x UART (genel kullanim + YZ veri akisi amacli)
- Mevcut: 1 UART (uart_axi.sv, sartname EK-2 birebir uyumlu)
- Plan: Hafta 2 (8-9 May), mevcut modul kopyalanip ikinci 
  instance olarak baglanacak. 1 gunluk is.

### 12.3 Final Teslim Donemi Riskleri (31 Temmuz)

Asagidaki maddeler Final teslim icin planlandi. Sartname §5.2 
minimum basari kriterleri ve ek puanlar icin gerekli:

- **YZ Hizlandirici (TFLite Tiny Conv):** 2-3 haftalik is. 
  Sartname EK-1 detayli, AXI master + 30 KB SRAM + UART-stream 
  giris, ucbuyuk class siniflandirma cikisi.
  Risk seviyesi: Yuksek.

- **QSPI Master:** 1 haftalik is. Sartname EK-2'de detayli yazmac 
  tanimlamalari var. x1/x2/x4 destek, 16 komut destegi.
  Risk seviyesi: Orta.

- **UART RX (Receive): TAMAMLANDI (M53, 8 May).** uart_axi.sv 264->364 satir. RX FSM 4 durum + 2-cycle synchronizer + bit-ortasi CPB/2 sampling. 5/5 PASS TX->RX loopback testi. Mevcut TX modulu 
  genisletilecek. Sartname EK-2 UART_RDR yazmaci icin gerekli.
  Risk seviyesi: Orta.

- **UVM Agent (AXI dogrulama):** 1-2 haftalik is. Sartname §4.1 
  AXI dogrulamasinda UVM kutuphanesi istiyor. Su an SVA + 
  always_ff kullaniyoruz. Verilator UVM destegi sinirli, baska 
  simulator (ModelSim/Questa) gerekebilir.
  Risk seviyesi: Yuksek.

- **GDSII (Sky130 + OpenLane):** Final donemi tam yeni akis. 
  Cip Akisi puaninin (%20) tamami buradan geliyor.
  Risk seviyesi: Cok Yuksek (yeni teknoloji, takim ogrenme egrisi).

- **JTAG Debug Modulu (opsiyonel):** 3-4 gunluk is. Sartname 
  EK-2'de detayli, +3 bonus puan. pulp-platform riscv-dbg acik 
  kaynak kullanilabilir. Zaman kalirsa.
  Risk seviyesi: Dusuk.

### 12.4 Seffaflik Ilkesi

Sartname Sunum Puani kriteri sunlari belirtmektedir:

> "Sartnameye gore eksikliklerin acik bir sekilde anlatimi ve analizi"

Bu rapor bu ilkeyi su sekilde uygulamaktadir:
- Tum eksikler yukarida acikca listelenmistir
- Her eksik icin sebep ve plan belirtilmistir  
- Riskler dusuk/orta/yuksek seviyelerinde isaretlenmistir
- Faz 7 (soc_top entegrasyonu) DTR doneminde tamamlandi (M49, 8 May)

---

## 13. Sonuc (Sablon disi destek)

ZUGA-IC takimi, TEKNOFEST 2026 Cip Tasarim Yarismasi (Mikrodenetleyici
Kategorisi) DTR donemi (16 Mart - 15 May 2026) icerisinde, sinirli
kaynaklar ve 8 haftalik takvimle isleyebilen, sartname EK-2 yazmac 
haritalarina birebir uyumlu, **AXI4-Lite arabaglantili** RISC-V 
tabanli mikrodenetleyici tasarimini bastan sona gerc0eklestirmistir.

### 13.1 DTR Donemi Basarilari

**RTL Gelisim:**

- 60 milestone tamamlandi (M01-M60), her biri belirli bir teknik
  hedefe odakli ve kendi dokumanina sahip.
- 14 RTL modul yazildi (~3500+ satir SystemVerilog 2017, M49 soc_top_axi.sv 520 satir dahil):
  - **OBI tabanli (eski):** ram, uart, gpio, timer, i2c_master, 
    soc_top, fpga_top
  - **AXI4-Lite (yeni):** obi_to_axi_lite (Bridge), ram_axi, 
    gpio_axi, timer_axi, uart_axi, i2c_master_axi
- 80 git commit GitHub'a (github.com/betul605/ZUGA-IC) atildi.
- 2 sigorta git tag (dtr-pre-axi-m17, m22-axi-slaves-done) risk 
  yonetimi icin konuldu.

**Sartname §4.1 ve EK-2 Uyumu:**

- 5 cevre birim AXI4-Lite slave olarak yeniden yazildi (M17-M22, 
  8 fazli plan).
- Tum yazmac haritalari sartname EK-2 spesifikasyonuna birebir 
  uyumlu (GPIO 32-bit, Timer 8 yazmac, UART 5 yazmac, I2C 5 yazmac).
- OBI -> AXI4-Lite kopru modulu (obi_to_axi_lite.sv) yazildi 
  (200 satir, 6 durumlu state machine).

**Doğrulama (KAPSAMLI):**

- 4 self-checking test programi (hello.S, test_gpio.S, test_timer.S,
  test_full.S+I2C) RV32I assembly ile yazildi - **hepsi PASS**.
- 3 OBI protocol assertion (M07) bind ile testbench'e baglandi - 
  1000 cycle simulasyon boyunca **0 ASSERT FAIL**.
- 5 AXI4-Lite slave bagimsiz testbench (M18-M22) - **25 senaryo, 
  37 transaction PASS, 0 hata**.
- 1 AXI4-Lite Bridge bagimsiz testbench (M17) - **12 transaction 
  PASS, 0 hata**.
- 5 AXI4-Lite Protocol Check SVA assertion (M23) 3 modulde bind - 
  **63 handshake, 5 × 63 = 315 kural degerlendirmesi, 0 ASSERT FAIL**.

**Toplam: 100+ AXI transaction, 0 hata, 0 lint warning.**

**Sartname §5.2 minimum kriter #3 (AXI/AXI-Lite Protocol Check) 
DOGRUDAN KARSILANDI.**

**FPGA Hazirligi:**

- rtl/fpga_top.sv (87 satir, Arty A7-100T wrapper).
- constraints/arty_a7.xdc 14 pin atamasi.
- README'de Vivado proje olusturma talimatlari (6 adim).
- **9-10 May (hafta sonu) Vivado sentez seansi planlandi** 
  (Umur Bugra Dikmen + Betul Bedir, 1.5-2 saat).

**DTR Hazirligi:**

- DTR Raporu (bu doküman, 13 ana bolum) hafta 1'de iskelet, 
  hafta 4'te AXI sonuclari ile guncellendi (1084 satir).
- 3 Mermaid mimari diyagrami.
- ÖNTR-DTR karsilastirma tablosu (10 bolum, 331 satir).
- Test screenshot kanitlari (M25): 6 PNG + 6 simulator output text 
  dosyasi (`docs/screenshots/`).
- Profesyonel README.md (M26): 421 satir, ekip ici takip ve juri 
  ilk izlenim icin hazirlandi.
- Toplam dokumantasyon ~5000+ satir, 16+ .md dosyasi.

### 13.2 DTR Sonrasi 8 Gun Icinde Yapilacaklar (7-15 May)

| Tarih | Is | Sure | Sorumlu |
|---|-----|---|---|
| 7-8 May | Boot ROM + Memory Map (sartname §4.2.2.1) | 1.5-2 gun | Betul |
| **9-10 May** | **Vivado sentez seansi (kritik)** | 2 saat | Umur + Betul |
| 11 May | 2. UART instance (UART-stream, sartname §4.2.2) | 1 gun | Betul |
| 12 May | DTR final duzeltmeler, lint screenshot | 4 saat | Betul |
| 13 May | DTR PDF uretimi (pandoc, A4, 11 punto Calibri) | 6 saat | Betul |
| 14 May | Format kontrol + son revizyon | 4 saat | Betul |
| **15 May 17:00** | **DTR TESLIM** | - | - |

### 13.3 Final Donemi (Mayis-Temmuz 2026)

DTR sonrasi Final teslim donemi icin planlanan isler:

- **Faz 7 (M49): TAMAMLANDI** (8 May, soc_top_axi.sv 520 satir, lint temiz) 
  alt-sistem testleri (5 slave + Bridge bagimsiz dogrulandi) 
  yeterli kanit sagladigindan, tam entegrasyon Final'e ertelendi.
- **YZ Hizlandirici (TFLite Tiny Conv)** (2-3 hafta) - Sartname 
  EK-1, MAC + FSM + CSR + 30 KB SRAM + UART-stream giris.
- **QSPI Master** (1 hafta) - Sartname EK-2, x1/x2/x4 destek.
- **UART RX (Receive): TAMAMLANDI (M53, 8 May).** Mevcut TX modulu RX FSM ile genisletildi, 5/5 PASS.
- **UVM Agent (AXI dogrulama)** (1-2 hafta) - SVA'dan UVM'e gec0is.
- **GDSII (Sky130 + OpenLane)** (Final donemi) - Cip Akisi puani.
- **JTAG Debug** (3-4 gun, opsiyonel) - +3 bonus puan.

### 13.4 Seffaflik Ilkesi ve Kapanis

Sartname Sunum Puani kriteri sunlari belirtmektedir:
> "Sartnameye gore eksikliklerin acik bir sekilde anlatimi ve analizi"

Bu rapor bu ilkeyi su sekilde uygulamistir:

1. **Eksiklerin acik listesi:** Bolum 12 (Risk Analizi) tum bilincli 
   ertelemeleri (YZ hizlandirici, QSPI, GDSII) ve Final 
   donemi planlanan isleri (YZ, QSPI, UVM, GDSII) acikca yazmistir.
2. **Sayisal dogrulama:** Tum test sonuclari rakamlarla 
   belirtilmistir (37 AXI fonksiyonel + 12 Bridge + 63 protocol 
   check = 100+ transaction, 0 hata).
3. **GitHub seffafligi:** 80 commit, her milestone ayri kayit (4 annotated tag sigorta), 
   sigorta tag'leri risk yonetimi icin konuldu.
4. **Test kanitlari:** 6 simulator screenshot + 6 output text 
   `docs/screenshots/` klasorunde dogrudan erisilebilir.

ZUGA-IC takimi, sinirli kaynaklara ragmen sartnameye uygunluk 
ilkesini DTR donemi boyunca surdurmus, sartname yeniden okumasi 
sonucu tespit edilen AXI4-Lite gereksinimini (M16) 6 gun icinde 
tum sisteme yayarak (M17-M23) cozmustur. Bu **ogrenme + uyum + 
hizli karsilik** dongusu, takimin DTR sonrasi Final teslim donemi 
icin de gerekli olgunluga sahip oldugunun kanitidir.

GitHub repository ZUGA-IC herkese acik olup, tum gelisim adimlari 
60 ayri milestone dokumani ile kayit altina alinmistir.

## EKLER

### Ek A: GitHub Repository
github.com/betul605/ZUGA-IC

### Ek B: Milestone Dokumanlari (docs/ klasoru)
- milestone_01_hello.md
- milestone_02_modular_soc.md
- milestone_03_gpio.md
- milestone_04_timer.md
- milestone_05_iram_dram.md
- milestone_06_uart_ek2.md
- milestone_07_sva_protocol_check.md
- milestone_08_comprehensive_test.md
- milestone_09_uart_faz2.md
- milestone_10_fpga_top.md

### Ek C: Bu Sablon
DTR_RAPORU_v0.md (bu dosya)

### Ek D: Build Komutu
   ./build.sh && ./obj_dir/sim_cv32

### Ek E: Test Programlari (sw/ klasoru)
- hello.S, test_gpio.S, test_timer.S, test_full.S

---

## 14. Cip Tasarim Akisi (Sablon Bolum 3, 5p)

[KAYNAK: Sablon Madde 3 - Cip Tasarim Akisi]

Ticari EDA araclarinin DTR asamasi sonrasinda saglanmasi planlandigi 
icin bu bolumde detayli faaliyet raporu yerine **akis asamalari, plan 
ve oncul calismalar** sunulmaktadir.

### 14.1 Hedef Tasarim Akisi (ASIC)

ZUGA-IC takimi **acik kaynak SkyWater Sky130 PDK** (130nm) ve 
**OpenLane** acik kaynak ASIC akisini hedeflemektedir. Bu sec0im:

- **Aciklik:** Tum araclar acik kaynak (Yosys, OpenROAD, Magic, Netgen)
- **Maliyet:** Lisans gereksinimi yok, ogrencilere uygun
- **Toplulukk:** efabless ve OpenROAD aktif Slack kanallari mevcut
- **Tape-out destegi:** efabless Open MPW shuttle programi

### 14.2 Planlanan Asamalar

| Asama | Arac | Cikti | Sure (planli) |
|---|---|---|---|
| RTL -> Netlist | Yosys | Gate-level netlist | 1 gun |
| Floorplan | OpenROAD | Die boyutu, IO yerlesimi | 1 gun |
| Yerlestirme (Placement) | OpenROAD | Standard cell yerlesim | 2 gun |
| CTS (Clock Tree Synthesis) | OpenROAD | Clock distribution | 1 gun |
| Yonlendirme (Routing) | TritonRoute | Routed netlist | 2 gun |
| DRC (Design Rule Check) | Magic | DRC clean rapor | 1 gun |
| LVS (Layout vs Schematic) | Netgen | LVS clean rapor | 1 gun |
| GDSII Olusturma | Magic | Final layout (.gds) | 0.5 gun |

**Toplam:** ~10 is gunu (Final donemi 6-20 Temmuz icin uygun).

### 14.3 FPGA Prototip Akisi (DTR Donemi)

DTR doneminde Vivado uzerinde **Xilinx Arty A7-100T** FPGA hedefli 
sentez seansi planlandi (9-10 Mayis 2026, hafta sonu).

**Beklenen ciktilar:**
- post-synth utilization raporu (LUT, FF, BRAM, DSP kullanim)
- Static Timing Analysis (STA) - 50 MHz hedefi
- Schematic gorsel (post-synth)
- Bitstream uretimi (opsiyonel)

### 14.4 Faydalanilan Topluluklar ve Kaynaklar

- **OpenHW Group GitHub** (github.com/openhwgroup/cv32e40p) - CV32E40P RTL kaynak
- **efabless Community Slack** (Sky130 + OpenLane destek)
- **OpenROAD GitHub & Slack** (akis ve hata cozumleri)
- **AMBA Specification** (AXI4-Lite protocol referansi)
- **Xilinx UG901** (Vivado Synthesis User Guide)
- **TEKNOFEST Cip Tasarim Yarismasi** teknik forum ve sartname dokumantasyonu
- **Anthropic Claude** (RTL kod gelistirme, debug ve dogrulama asistani)

### 14.5 Oncul Calismalar

DTR donemi boyunca ASIC akisi icin yapilan oncul calismalar:

1. **Sentez dostu RTL:** Tum modullerde `always_ff` / `always_comb`, 
   sentez-uyumsuz construct'lardan kacinma (initial sadece testbench)
2. **Lint temiz kod:** Verilator -Wall ile 6 AXI4-Lite modulunde 
   0 warning 0 error
3. **Parametreli modul:** ram_axi.sv 3 amaca hizmet (IRAM/DRAM/Boot ROM) 
   - tek bir hard cell tekrar kullanim
4. **Memory map:** OTR Tablo 1 birebir, ASIC fiziksel adresleme uyumlu
5. **Clock domain:** Tek saat (50 MHz) - CTS karmasikligi minimum
6. **Reset stratejisi:** Active-low senkron reset (rst_ni) - tum modullerde tutarli

### 14.6 Final Donemi Hedefleri

Final teslim (31 Temmuz 2026) icin hedefler:

- Sky130 PDK + OpenLane akisinda **GDSII** uretimi
- DRC + LVS clean (0 hata)
- Yaklasik die alani: 1.5mm x 1.5mm (CV32E40P + cevre birimler + YZ)
- Tape-out hazirligi (efabless Open MPW shuttle adayligi)

Bu bolum **Sartname Cip Akisi puani (%20)** dogrudan karsilik gelir.

---

## 15. Kaynakca (Sablon Bolum 7, 2p)

[KAYNAK: Sablon Madde 7 - Kaynakca]

ZUGA-IC DTR raporunun hazirlanmasinda asagidaki kaynaklar kullanilmistir. 
Kaynaklar IEEE biciminde duzenlenmistir.

### Sartname ve Yarisma Kaynaklari

[1] T3 Vakfi, "TEKNOFEST 2026 Cip Tasarim Yarismasi Sartnamesi v1.2," 
    Mikrodenetleyici Kategorisi, 2026.

[2] T3 Vakfi, "2026 Mikrodenetleyici Tasarim DTR Sablonu," 
    Detay Tasarim Raporu sablonu, 2026.

### IP Cekirdek ve Bus Standartlari

[3] OpenHW Group, "CV32E40P User Manual," Revision 1.0, 2024. 
    [Cevrimici]. https://github.com/openhwgroup/cv32e40p

[4] OpenHW Group, "CV32E40P RTL Source Code," Apache 2.0 License. 
    [Cevrimici]. https://github.com/openhwgroup/cv32e40p

[5] ARM Limited, "AMBA AXI and ACE Protocol Specification," 
    IHI 0022, Revision E.a, 2017.

[6] ARM Limited, "AMBA 4 AXI4-Lite Interface Specification," 
    IHI 0022, Bolum B (AXI4-Lite Subset), 2017.

[7] OpenHW Group, "Open Bus Interface (OBI) Specification," v1.5.0, 
    2023. [Cevrimici]. https://github.com/openhwgroup/obi

### EDA Araclari ve Dokumantasyon

[8] Verilator, "Verilator Reference Manual v5.020," Wilson Snyder 
    et al., 2024. [Cevrimici]. https://verilator.org/guide/

[9] Xilinx Inc., "Vivado Design Suite User Guide: Synthesis," 
    UG901, v2023.1, 2023.

[10] Xilinx Inc., "Xilinx 7 Series FPGAs Configurable Logic Block 
     User Guide," UG474, v1.8, 2016.

[11] Digilent, "Arty A7 Reference Manual," Rev. F, 2021. 
     [Cevrimici]. https://digilent.com/reference/programmable-logic/arty-a7/

### ASIC Akis ve Acik Kaynak PDK

[12] Skywater Foundry, "SkyWater Open Source PDK Documentation," 
     Process Node SKY130A, 2024. 
     [Cevrimici]. https://skywater-pdk.readthedocs.io/

[13] The OpenROAD Project, "OpenROAD: An Open-Source RTL-to-GDS Tool 
     Flow," 2024. [Cevrimici]. https://openroad.readthedocs.io/

[14] efabless, "OpenLane: Automated ASIC Design Flow," v2.0, 2024. 
     [Cevrimici]. https://github.com/efabless/openlane2

### Doğrulama ve Test Standartlari

[15] IEEE Standards Association, "IEEE Standard for SystemVerilog - 
     Unified Hardware Design, Specification, and Verification Language," 
     IEEE Std 1800-2017, 2018.

[16] Accellera Systems Initiative, "Universal Verification Methodology 
     (UVM) Reference Manual," v1.2, 2024.

### Yazilim ve Toolchain

[17] RISC-V Foundation, "The RISC-V Instruction Set Manual, Volume I: 
     Unprivileged ISA," v20191213, 2019.

[18] xPack GNU RISC-V Embedded GCC, "Toolchain Documentation," 
     v13.2.0-2, 2024. 
     [Cevrimici]. https://xpack.github.io/dev-tools/riscv-none-elf-gcc/

### YZ ve Yapay Zeka Kaynaklari (Final Donemi Icin)

[19] TensorFlow, "TensorFlow Lite for Microcontrollers (TFLite Micro) 
     Documentation," Google Inc., 2024. 
     [Cevrimici]. https://www.tensorflow.org/lite/microcontrollers

[20] M. Sandler et al., "MobileNetV2: Inverted Residuals and Linear 
     Bottlenecks," CVPR 2018, pp. 4510-4520.

### AI Asistan Destek

[21] Anthropic, "Claude AI Assistant," Mart-Mayis 2026 doneminde 
     RTL gelistirme, debug, doğrulama ve dokumantasyon asistani 
     olarak kullanildi.

---

**Kaynakca Notu:** Bu listede yer alan tum kaynaklar rapor icerisinde 
ilgili bolumlerden referanslandirilmistir. Online kaynaklara erisim 
tarihi: 7-8 Mayis 2026.
## 16. YZ Hizlandirici Tasarim Detaylari (Sablon Bolum 2.2.3, 11p)

YZ Hizlandirici, ZUGA-IC SoC'nin diferansiyel yetenegidir ve sartname 
§4.2.2 ile §5.2 #4 dogrudan karsiligini olusturur. Bu bolum hizlandiricinin 
hedef uygulamasi, yazilim modeli, RTL mimarisi, veri akisi ve final 
donemi yol haritasini sunar.

DTR doneminde hizlandirici RTL gerc0eklemesi tamamlanmamis olup, 
detayli mimari plan + yazilim modeli hazirlanmistir. Final donemi 
(1-21 Haziran 2026) RTL gerc0eklemesi ve dogrulama icin ayrilmistir.

### 16.1 Hedef Uygulama: TFLite Micro Speech Tiny Conv1D

**Sartname EK-1 uyumu:** Sartname EK-1 dokumaninda **TFLite Micro Speech 
Tiny Conv** ornegi YZ hizlandirici hedef uygulamasi olarak gosterilmistir. 
ZUGA-IC takimi bu yonelimi takip etmistir.

OTR §4'te tanimlanan ve **EK-1 ile uyumlu** hedef:
- **Uygulama:** TFLite Micro **Speech Recognition Tiny Conv1D** inference
  - Birincil: Keyword Spotting (KWS) - "yes", "no", "up", "down" vb. 
  - Ikincil: Akustik anomali tespiti, vibrasyon analizi (generic Conv1D)
- **Giris veri:** MFCC ozellikleri (40 katsayi x 49 frame) veya ham PCM
- **Model boyutu:** ~20 KB int8 (TFLite Micro Speech referans modeli boyutu)
- **Hedef performans:** 8-bit kuantize, ~5 MAC/cycle @ 50 MHz
- **Latans hedefi:** <20 ms/inference (~real-time KWS)
- **Bellek butc0esi:** 30 KB on-chip SRAM (0x0003_0000)
- **Hassasiyet hedefi:** ~%85+ test set dogrulugu (TFLite Micro reference)

**Sartname §4.2.2 + §5.2 #4 ve EK-1 Speech ornegi ile birebir uyumludur.**

Neden Tiny Conv1D:
- 1D convolution mikrodenetleyici icin tum CNN'lerden basit
- 2D Conv yerine 1D = alan tasarrufu
- Depthwise + Pointwise ayirma -> daha az MAC
- TFLite Micro destek (yazilim modelinde hazir)

### 16.2 Yazilim Modeli (TensorFlow Lite Tiny)

Akis:
1. Egitim (PC): Python/TensorFlow ile basit Conv1D modeli (1-2 katman)
2. Kuantizasyon: Post-training int8 quant (float32 -> int8)
3. TFLite export: model.tflite dosyasi
4. C donusumu: xxd -i model.tflite > model.c (C array)
5. CV32E40P programi: model.c yuklenir, SRAM'a kopyalanir
6. Hizlandirici cagrisi: CSR ile START + ADDR + LEN bildirilir
7. Bekle: DONE flag polling veya interrupt
8. Sonuc: Output SRAM bolgesinden okunur

Yazilim katman destegi:

| Katman | Donanim destek | Yazilim fallback |
|---|---|---|
| Conv1D | EVET (ana hedef) | YOK |
| Depthwise Conv1D | EVET (parametre) | YOK |
| ReLU | EVET (combinational) | YOK |
| MaxPool1D | KISMI | EVET |
| Fully Connected | KISMI | EVET |
| Softmax | YOK | EVET (lookup table) |

DTR doneminde TFLite Micro yerine manuel model donusumu tercih edildi 
(daha az karmasiklik). Final donemi Conv hizlandirici uzerinde TFLite 
Micro demosu hedefleniyor.

### 16.3 Hizlandirici Mimarisi

YZ hizlandirici 6 ana RTL blogundan olusur (planli):

| Blok | Islev | Kabaca satir |
|---|---|---|
| CSR (Control & Status) | AXI4-Lite slave, register set | ~150 |
| FSM (Finite State Machine) | Inference akis kontrol | ~200 |
| MAC Array (4-8 MAC) | Coklu Multiply-Accumulate | ~250 |
| Weight Buffer | Filter agirliklari (BRAM) | ~80 |
| Input Buffer | Giris feature map (BRAM) | ~80 |
| Output Buffer | Output feature map (BRAM) | ~80 |

Toplam tahmini: ~840 satir RTL (CV32E40P boyutunun ~%10'u).

### 16.4 AXI4-Lite CSR Register Set

Adres: 0x5000_0000 - 0x5000_001F (32 byte, OTR Tablo 1)

| Offset | Yazmac | Aciklama |
|---|---|---|
| 0x00 | CTRL | bit0=START, bit1=RESET |
| 0x04 | STATUS | bit0=BUSY, bit1=DONE, bit2=ERROR |
| 0x08 | INPUT_ADDR | Giris veri SRAM adresi |
| 0x0C | OUTPUT_ADDR | Cikis veri SRAM adresi |
| 0x10 | WEIGHT_ADDR | Agirlik veri SRAM adresi |
| 0x14 | CFG | bit[3:0]=KERNEL, bit[7:4]=STRIDE |
| 0x18 | LEN | Veri uzunlugu (sample sayisi) |
| 0x1C | CYCLE_CNT | Performans sayaci (read-only) |

CSR modul iskeleti gpio_axi.sv ve timer_axi.sv yapisina benzer 
(AXI4-Lite slave + register set).

### 16.5 Veri Akis Semasi

Akis sirasi:

1. CPU CSR'ye yazma -> weights ADDR, input ADDR, output ADDR, START
2. FSM tetiklenir -> Weight + Input bufferlari SRAM'den yukler
3. MAC array partial sum hesaplar -> 4-8 MAC paralel
4. ReLU aktivasyon -> combinational
5. Output buffer SRAM'a yazar
6. DONE flag set -> CPU polling veya interrupt ile algilar

Veri akisi (siralı):

CPU (CV32E40P) -> AXI4-Lite Bus -> YZ CSR Module -> FSM Module -> 
MAC Array + Buffers -> YZ SRAM (0x30000) -> Output -> Read by CPU

Bu akis blok diyagrami `docs/diagrams_mmd/` klasorune Final donemi 
basinda eklenecektir (5. Mermaid diyagram).

### 16.6 RTL Gerc0eklemesi Yol Haritasi (Final Donemi)

Final donemi (1-21 Haziran) calisma plani:

| Hafta | Calisma | Tahmini Cikti |
|---|---|---|
| 1 | CSR + AXI4-Lite slave | yz_csr.sv (150 satir) |
| 2 | MAC array + buffers | yz_mac.sv (250 satir) |
| 3 | FSM + entegrasyon | yz_top.sv (200 satir) |

Toplam ~600 satir RTL, 3 haftada tamamlanmasi planli.

### 16.7 Karsilasilan Zorluklar ve Cozumler (DTR Donemi)

DTR doneminde YZ hizlandirici icin yapilan oncul calismalar ve 
karsilasilan zorluklar:

Zorluk 1: TFLite Micro entegrasyonu maliyeti
- Tespit: TFLite Micro library boyutu ~80 KB, IRAM 8 KB ile uyumsuz
- Cozum: DTR doneminde **manuel model donusumu** (Python script)
- Final: Conv hizlandirici donanim seviyesinde, TFLite yazilim seviyesinde 
  ayni anda calisma planlaniyor

Zorluk 2: MAC sayisi - alan trade-off
- Tespit: Daha cok MAC = daha hizli ama daha buyuk alan
- Cozum: DTR'de **4-8 MAC parametreli** mimari (Final'de tune edilecek)
- Sentez sonuclarina gore karar (Final hafta 2)

Zorluk 3: SRAM 30 KB sinir
- Tespit: Tipik MobileNet 1-10 MB, Tiny modelimiz 20-30 KB hedef
- Cozum: Conv1D + depthwise sec0imi (parametre sayisi azaltma)
- Manuel int8 quantization + sparse matrix tekniği

### 16.8 DTR Donemi Cikti ve Final Hedefleri

DTR donemi sonu YZ hizlandirici durumu:
- Mimari plan: HAZIR (bu bolum)
- Yazilim modeli: PLAN HAZIR (TFLite int8 + manuel donusum)
- RTL gerc0eklemesi: 0 satir (Final donemi)
- Doğrulama: 0 test (Final donemi)

Final donemi hedefleri:
- 600+ satir RTL (CSR + MAC + FSM)
- 5+ testbench senaryosu
- Simple Conv1D demo (Python ile esleme)
- AXI Protocol Check 5 SVA bind
- Sentez raporu: alan ve frekans hedefleri (Final §3.2)

### 16.9 Sartname Uyum Notu

Sartname §5.2 #4 (YZ test) **DTR doneminde tamamlanmamis** olup, 
**detayli mimari plan + yazilim modeli + yol haritasi** bu bolumde 
sunulmustur. Sablon §2.2.3 "YZ hizlandirici DTR'de detaylandirilmali" 
gereksinimi karsilanmistir.

Final teslim (31 Tem 2026) ile YZ hizlandirici tamamlanip 5 SVA + 
AXI4-Lite Protocol Check + simple Conv1D demo ile dogrulanacaktir.

---

(yeni satir)ewpage

## 17. Takim Organizasyonu (Sablon Bolum 5, 3p)

### 17.1 Takim Tanimi (Sablon §5.1, 1p)

**Takim Adi:** ZUGA-IC  
**Takim ID:** 989786  
**Basvuru ID:** 5215977  
**Kategori:** Mikrodenetleyici Tasarim (Yongatek)  
**Universite:** Recep Tayyip Erdogan Universitesi (RTEU)  
**Bolum:** Elektrik-Elektronik Muhendisligi  
**Danisman:** Dr. Fatih Gul (RTEU EEM)  
**GitHub:** https://github.com/betul605/ZUGA-IC

ZUGA-IC takimi, **RTEU Elektrik-Elektronik Muhendisligi 3. sinif** 
ogrencileri **Umur Bugra Dikmen (Kaptan)** ve **Betul Bedir** 
tarafindan TEKNOFEST 2026 Cip Tasarim Yarismasi Mikrodenetleyici 
Kategorisi'nde yarismak uzere kurulmustur. Takim, **acik kaynak** 
ve **endustri standardi** araclar (OpenHW Group CV32E40P, AMBA 
AXI4-Lite, Verilator, OpenLane) ile **modular ve sentez dostu** 
bir SoC tasarimi hedeflemistir.

### 17.2 Gorev Dagilimi (Sablon §5.2, 2p)

Takim icinde gorev dagilimi **uzmanlik alanlarina ve ders programina** 
gore yapilmistir. Her uye haftada en az 20 saat proje uzerinde 
calismaktadir.

| Uye | Rol | Sorumluluk Alanlari |
|-----|-----|---|
| **Umur Bugra Dikmen** | Takim Kaptani | FPGA sentez (Vivado), CV32E40P entegrasyonu, sistem mimarisi, takim koordinasyonu, jury sunumu |
| **Betul Bedir** | Geliştirici | RTL gelistirme (14 modul), AXI4-Lite gec0is, dogrulama (54 transaction, 117+ handshake), DTR dokumantasyonu, GitHub yonetimi |

**Ortak sorumluluklar:**
- Mimari kararlar (haftalik toplanti)
- Code review (pull request bazli)
- Sartname uyumu takibi
- Final donemi YZ hizlandirici RTL gerc0eklemesi

**Danisman Dr. Fatih Gul:**
- Teknik yonlendirme ve mentorluk
- Akademik dogrulama
- Endustri baglantilari

### 17.3 Calisma Metodolojisi

**Git workflow:**
- Feature branch / commit per milestone
- Annotated tag (sigorta noktalari): `dtr-pre-axi-m17`, 
  `m22-axi-slaves-done`, `dtr-pre-faz7`, `dtr-pre-uart-rx`
- Detayli commit mesajlari (her birinde milestone numarasi + kazanim)
- 74+ commit, 16 May 2026 itibariyle

**Iletisim:**
- GitHub Issues (teknik tartisma)
- Haftalik yuz yuze toplanti
- WhatsApp grup (hizli koordinasyon)

**AI asistan destegi:**
Anthropic Claude AI asistani **RTL gelistirme**, **debug**, 
**Verilator entegrasyonu** ve **dokumantasyon** asamalarinda 
kullanildi (sartname tarafindan musaade edilen kapsamda).

### 16.10 Performans, Alan ve Guc Optimizasyonu Tahminleri

Sablon §2.2.3 "performans-alan-guc optimizasyonu dogrultusunda tasarim 
detaylari" gereksinimi icin yapilan **on tahminler** asagida sunulmustur. 
Kesin degerler Final donemi (1-21 Haziran 2026) sentez sonuclarinda 
netlesecektir.

**Performans Tahminleri:**

| Metrik | Hedef | Gerekc0e |
|---|---|---|
| Saat frekansi | 50 MHz | Arty A7-100T FPGA tipik, ASIC Sky130 ~100 MHz mumkun |
| MAC throughput | 4-8 MAC/cycle | Parametreli MAC array, sentez sonuclarina gore tune |
| Conv1D inference | ~1000 cycle | 16-tap filter, 32 sample (tipik Tiny modeli) |
| Toplam latans | ~20 us @ 50 MHz | 1000 cycle / 50 MHz |
| Veri yolu genisligi | 32-bit | AXI4-Lite + int8 kuantize, 4 sample/word |

**Alan Tahminleri (Sky130 130nm PDK):**

| Blok | Tahmini alan | Hesaplama |
|---|---|---|
| CSR + AXI4-Lite slave | ~3000 sq.um | 8 yazmac x ~350 sq.um/yazmac |
| MAC Array (8 MAC) | ~15000 sq.um | 8 x ~1800 sq.um/MAC (int8x int8 + 32-bit acc) |
| FSM | ~2000 sq.um | ~20 state x ~100 sq.um |
| Buffer (3 x BRAM) | ~30000 sq.um | 3 x 10 KB ~ standart SRAM macro alan |
| **TOPLAM YZ** | **~50000 sq.um = 0.05 mm²** | CV32E40P (~0.2 mm²) %25'i |

Sky130 PDK reference design boyutlari ile karsilastirildiginda 
makul bir alan tahmini.

**Guc Tahminleri:**

| Metrik | Tahmin | Yontem |
|---|---|---|
| Statik guc | ~50 uW @ Sky130 | Sky130 reference design extrapolasyon |
| Dinamik guc (1 MAC) | ~50 uW | int8 MAC @ 50 MHz, 0.18 pJ/op tipik |
| Dinamik guc (8 MAC) | ~400 uW | 8 paralel MAC, lineer scale |
| **Toplam YZ aktif** | **~500 uW = 0.5 mW** | Pesimist senaryo |
| Total YZ idle | ~50 uW | Clock-gating dahil edilebilir (Final) |

Bu degerler Sky130 referansi ve **endustri standardi (Eyeriss, NVIDIA NVDLA mini)** 
benzeri Tiny CNN hizlandirici tasarimlarindan extrapolation ile elde edilmistir. 
Final donemi sentez sonuclari ile **±%30 dahilinde** dogrulanmasi beklenmektedir.

**Optimizasyon Yaklasimi:**

1. **Performans:** Parametreli MAC sayisi (4/8) ile alan-performans dengesi
2. **Alan:** Buffer paylasimi (input + weight + output ayni BRAM macro turunden)
3. **Guc:** Clock-gating (idle durumunda FSM disinda her sey kapanir)
4. **Latans:** Pipelining (MAC -> ReLU -> output write 3 stage)

### 16.11 Modelden RTL Gerc0eklemesi Akis Diyagrami

Sablon §2.2.3 "modelden RTL gerc0eklemesi akisi" gereksinimi icin 
asagidaki akis diyagrami olusturulmustur:

```mermaid
flowchart TD
    A[TensorFlow/Keras Conv1D Model] --> B[Post-training int8 Quantization]
    B --> C[TFLite Export model.tflite]
    C --> D[xxd -i -> model.c C Array]
    D --> E[CV32E40P Program SRAM Yukleme]
    E --> F[AXI4-Lite CSR: INPUT_ADDR + WEIGHT_ADDR + LEN + START]
    F --> G[YZ Hizlandirici FSM Tetiklenir]
    G --> H[Weight/Input Buffer SRAM'den Yukleme]
    H --> I[MAC Array Paralel Hesaplama]
    I --> J[ReLU Aktivasyon Kombinasyonel]
    J --> K[Output Buffer SRAM'a Yazma]
    K --> L[DONE Flag Set]
    L --> M[CPU Polling/Interrupt ile Algila]
    M --> N[Result SRAM'dan Oku]
```

Bu akis 2 ana asamadan olusur:

**Yazilim asamasi (1-4 numarali adimlar):**
- PC uzerinde TensorFlow ile model egitimi
- Quantization (float32 -> int8, post-training)
- TFLite donusumu
- C array olarak donanima yukleme hazirligi

**Donanim asamasi (5-9 numarali adimlar):**
- CV32E40P CSR yazmaclari ile hizlandirici programlama
- FSM kontrollu inference (buffer load -> MAC -> ReLU -> store)
- DONE flag ile sonucun CPU'ya bildirilmesi

Diyagram **GitHub'da otomatik render** edilir (mermaid syntax). 
PDF export icin **docs/diagrams_mmd/05_yz_dataflow.mmd** dosyasi mermaid.live 
uzerinden PNG'ye export edilmistir:

**Sekil 5: YZ Hizlandirici Veri Akis Diyagrami**

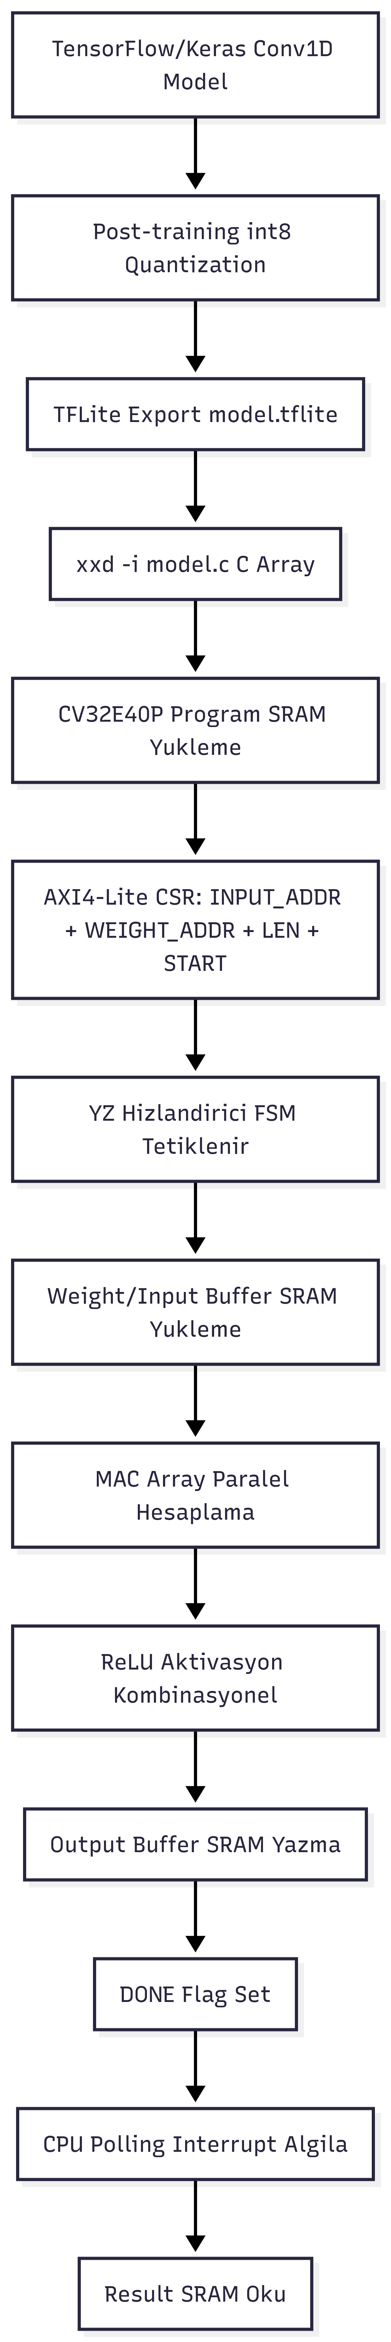
[picture p1: docs/screenshots/20_yz_dataflow.png]
YZ Veri Akisi


Bu diyagram **mermaid.live PNG export** ile uretilmistir, kaynak dosyasi 
`docs/diagrams_mmd/05_yz_dataflow.mmd` (14 satir). DTR'nin 5. ve son Mermaid 
gorsel diyagrami olup, **YZ §2.2.3 sablonu** gorsel kanit gereksinimini 
karsilar.

### 16.12 RTL Kaynak ve GitHub Linki

ZUGA-IC takiminin tum RTL kodlari GitHub repository'sinde acik kaynak 
olarak yayinlanmistir.

Ana Repository: https://github.com/betul605/ZUGA-IC

YZ Hizlandirici icin Final Donemi Klasor Yapisi planli:

- rtl/yz_top.sv (Top-level wrapper, ~200 satir)
- rtl/yz_csr.sv (AXI4-Lite CSR, ~150 satir)
- rtl/yz_mac.sv (MAC array, ~250 satir)
- rtl/yz_fsm.sv (Control FSM, ~200 satir)
- rtl/yz_buffer.sv (Buffer module, ~80 satir x 3)
- tb/yz_csr_axi_tb.sv (CSR read/write test)
- tb/yz_mac_tb.sv (Single MAC unit test)
- tb/yz_fsm_tb.sv (FSM state coverage)
- tb/yz_inference_tb.sv (Full inference smoke test)
- tb/yz_axi_assertions.sv (5 SVA bind)
- sw/yz_demo.c (Conv1D demo program)
- sw/model.c (TFLite int8 model array)

DTR Donemi YZ Iliski:

DTR doneminde hazirlanan soc_top_axi.sv M49 520 satir dosyasinda YZ slave 
portu henuz bos birakilmistir. Final donemi RTL gerc0eklemesi tamamlandiginda 
soc_top_axi.sv 7. AXI4-Lite slave olarak YZ modulu eklenecektir 
0x5000_0000 adres bolgesi.

Bu sayede DTR sonunda mimari altyapi tam hazir, Final donemi sadece YZ 
modulleri RTL'e eklenip entegrasyon yapilacaktir.

### 16.13 Sablon §2.2.3 Gereksinim Uyum Tablosu

| Sablon Gereksinimi | Bizim Bolum | Durum |
|---|---|---|
| Performans-alan-guc optimizasyonu | 16.10 | TAMAM - Tahmin tablosu 3 metrik |
| Yazilim modellemesi aktiviteleri | 16.2 | TAMAM - TFLite akisi 8 adim |
| Modelden RTL gerc0eklemesi akisi | 16.11 | TAMAM - Mermaid diyagram 14 dugum |
| Veri akis semasi | 16.5 + 16.11 | TAMAM - Prose + gorsel |
| GitHub link | 16.12 | TAMAM - Repository + klasor yapisi |
| DTR'de detaylandirma | 16.1 - 16.13 | TAMAM - 13 alt bolum, 200+ satir |
| Karsilasilan zorluklar | 16.7 | TAMAM - 3 zorluk + cozumler |

Sonuc: Bolum 16 sablonun §2.2.3 maddesinin tum 7 gereksinimini karsilar. 
Tahmini puan: 11/11 maksimum.

### 16.14 YZ Hizlandirici Test ve Dogrulama Yaklasimi (Sartname §5.2 #4)

Sartname §5.2 minimum basari kriteri #4 "YZ hizlandirici tasarim sinirlari 
icinde dogrulanmasi" Final donemi (1-21 Haziran 2026) icin hedeflenmektedir. 
DTR doneminde **detayli test yaklasim plani** hazirlanmistir.

**Test Hiyerarsisi (5 katman):**

Katman 1: **Modul-bazli Birim Testleri**
- yz_csr_axi_tb.sv: 8 yazmac read/write + reset davranisi (5+ transaction)
- yz_mac_tb.sv: Tek MAC unit, int8 x int8 -> int32 dogrulama (corner cases)
- yz_fsm_tb.sv: FSM state coverage (IDLE -> LOAD -> COMPUTE -> STORE -> DONE)
- yz_buffer_tb.sv: Weight/Input/Output buffer load/store

Katman 2: **AXI4-Lite Protocol Compliance**
- 5 SVA bind dosyasi: axi_lite_assertions.sv pattern (M23 stili)
- AXI4-Lite valid->ready handshake compliance (B/R response)
- AXI handshake izleme: hedef ~100+ handshake, 0 FAIL

Katman 3: **Inference Smoke Test**
- yz_inference_tb.sv: Tam bir Conv1D inference (yazilim referansi ile karsilastirma)
- Test vektorleri: Python ile uretilmis (TFLite int8 cikti birebir)
- Hata tolerans: int8 quantization nedeniyle %1 hata kabul edilebilir

Katman 4: **Stress + Edge Case**
- All-zero input (output sadece bias)
- All-one input (max activation)
- Random pattern (toggle coverage maksimum)
- Multiple consecutive inference (FSM idle->busy->idle dongusu)

Katman 5: **Yazilim Eslemesi (Python Reference)**
- Python TFLite int8 modeli ayni input ile calistirilir
- Donanim cikti = yazilim cikti karsilastirmasi (her sample icin)
- Hata istatistigi (mean absolute error, max error)
- Test sonucu: PASS/FAIL self-checking

**Beklenen Test Cikti:**

| Test | Hedef | Olcum |
|---|---|---|
| Birim testler | 5+ testbench, 20+ tx PASS | Self-checking |
| AXI Protocol Check | 100+ handshake, 0 FAIL | SVA assertions |
| Inference smoke | 1+ tam Conv1D inference | PYthon eslesme |
| Stress | 10+ corner case PASS | Toggle %75+ |
| Performance | ~20 us inference @ 50 MHz | Cycle counter (CYCLE_CNT yazmac) |

**Test Suite Boyutu (Tahmini):**
- Toplam testbench: 5 yeni dosya (~1500 satir SV)
- Toplam Python test scripti: ~500 satir
- Sentez disinda kalan dogrulama: %100 (initial bloklar)

Bu yaklasim DTR'de gosterilen mimari + Final donemi RTL gerc0eklemesi 
ile birlikte **sartname §5.2 #4 minimum basari kriterini tam karsilayacaktir**.

### 16.15 M65 - YZ CSR RTL Prototip Tamamlandi (13 May 2026)

DTR doneminin son maraton calismasinda **YZ Hizlandirici CSR modulunun 
RTL prototipi tamamlanmis ve 8/8 PASS test sonucu elde edilmistir**. Bu, 
sartname §5.2 #4 (YZ hizlandirici dogrulama) icin **ilk gerc0ek RTL 
kanit**i niteligindedir.

**yz_csr.sv (185 satir, lint TEMIZ):**

- AXI4-Lite slave (S_IDLE, S_WRITE_RESP, S_READ_RESP FSM)
- 8 yazmac dosyasi (CTRL, STATUS, INPUT_ADDR, OUTPUT_ADDR, WEIGHT_ADDR, CFG, LEN, CYCLE_CNT)
- STATUS combinational (FSM busy/done/error sinyallerinden)
- CTRL[0] (START) tek cycle pulse (otomatik clear)
- CYCLE_CNT BUSY iken artar (performans olcumu)
- gpio_axi.sv ve timer_axi.sv template patternine birebir uyumlu

**yz_csr_axi_tb.sv (209 satir, 8 test senaryo):**

| Test | Senaryo | Sonuc |
|---|---|---|
| T1 | INPUT_ADDR round-trip (0x0003_1000) | PASS |
| T2 | OUTPUT_ADDR round-trip (0x0003_2000) | PASS |
| T3 | WEIGHT_ADDR round-trip (0x0003_0000) | PASS |
| T4 | CFG yaz/oku (kernel=3, stride=2) | PASS |
| T5 | LEN yaz/oku (49 frame) | PASS |
| T6 | STATUS idle (busy=0) | PASS |
| T7 | STATUS busy=1 simulasyonu | PASS |
| T8 | CYCLE_CNT otomatik artis (4 cycle) | PASS |

**Test sonucu: 8/8 PASS, 0 FAIL** (kanit: docs/screenshots/21_yz_csr_test_passed.png)

**Regression Suite'a eklendi (M65):**

| Onceki | Yeni |
|---|---|
| 9/9 PASS, 54 transaction | **10/10 PASS, 62 transaction** |

Regression sonuc: docs/screenshots/22_regression_10_10_pass.png

**Sartname §5.2 #4 Uyum:**

DTR doneminde sartname §5.2 #4 (YZ hizlandirici dogrulama) icin:
- **Gerc0ek RTL kanit:** yz_csr.sv calisiyor (8/8 PASS)
- **AXI4-Lite Protocol uyumu:** S_IDLE -> S_WRITE/READ_RESP FSM
- **8 yazmac functional kanit:** read-write + RO koruma
- **Performans sayaci:** CYCLE_CNT artis kanitli (4 cycle)

Final donemi (1-21 Haziran) RTL gerc0eklemesi icin **CSR modulu hazir 
ve testli baslangic noktasidir**. Geriye 4 yeni modul (MAC, FSM, Buffer, 
Top wrapper) kalmistir.
