betul605/2026_ZUGA-IC/docs/COVERAGE_RAPORU.md

# ZUGA-IC AXI4-Lite Coverage Raporu

**Tarih:** 8 Mayıs 2026  
**Yöntem:** Manuel senaryo tabanlı analiz (formal Verilator coverage Final dönemine)  
**Kaynak:** Sartname §3.2.2 (coverage raporlari zorunlu)

---

## Özet

| Metrik | Değer |
|---|---|
| Toplam RTL modül | 6 (AXI4-Lite slave + Bridge) |
| Toplam kod satırı (yorumsuz) | 949 satır |
| Toplam test senaryosu | 47 PASS |
| Toplam AXI handshake | 113 (0 FAIL) |
| **Tahmini ortalama line coverage** | **~82%** |
| **Tahmini ortalama toggle coverage** | **~75%** |

---

## Modül Bazında Detay

### 1. obi_to_axi_lite.sv (Bridge, M17)

| Özellik | Değer |
|---|---|
| Kod satırı (yorumsuz) | 120 |
| Test senaryosu | 12 PASS |
| State machine durumu | 6 (IDLE/AW/W/B + IDLE/AR/R) |
| Test eden testbench | obi_to_axi_lite_tb.sv |

**Kapsanan:**
- Tüm 6 state geçişi
- OBI req/gnt/rvalid handshake
- AXI4-Lite VALID/READY handshake
- byte_enable -> wstrb dönüşümü
- Reset davranışı

**Tahmini line coverage:** ~85%

### 2. ram_axi.sv (RAM/Boot ROM, M18+M29)

| Özellik | Değer |
|---|---|
| Kod satırı (yorumsuz) | 93 |
| Test senaryosu | 4 (IRAM) + 6 (Boot ROM) = 10 PASS |
| State machine durumu | 4 (IDLE/WRITE/READ/RESP) |
| Test eden testbench | ram_axi_tb.sv + boot_rom_axi_tb.sv |

**Kapsanan:**
- Tüm 4 state geçişi
- Read + Write modları
- WRITE_ENABLE=0 (Boot ROM) yazma reddi
- $readmemh ile bellek yükleme
- Edge: 0x100 boş bölge okuma

**Tahmini line coverage:** ~90% (en yüksek, 2 testbench tarafından test ediliyor)

### 3. gpio_axi.sv (M19)

| Özellik | Değer |
|---|---|
| Kod satırı (yorumsuz) | 94 |
| Test senaryosu | 5 PASS |
| State machine durumu | 3 (IDLE/WRITE/READ) |
| Test eden testbench | gpio_axi_tb.sv |

**Kapsanan:**
- IDR (input) okuma
- ODR (output) yazma + okuma
- 32-bit (16+16) pin atama
- Reset davranışı
- AXI write+read combo

**Tahmini line coverage:** ~85%

### 4. timer_axi.sv (M20)

| Özellik | Değer |
|---|---|
| Kod satırı (yorumsuz) | 153 |
| Test senaryosu | 5 PASS |
| State machine durumu | 4 (IDLE/WRITE/READ/COUNT) |
| 8 yazmaç | PRE/ARE/CLR/ENA/MOD/CNT/EVN/EVC |
| Test eden testbench | timer_axi_tb.sv |

**Kapsanan:**
- Prescaler (PRE) yapilandirma
- Auto-Reload (ARE) testi
- Enable (ENA) ile sayim baslatma
- Sayac (CNT) okuma
- Reset

**Eksik (DTR için kabul edilebilir):**
- Olay sayacı (EVN/EVC) detaylı testi
- Mod degisikligi (yukari/asagi)

**Tahmini line coverage:** ~75%

### 5. uart_axi.sv (M21+M31)

| Özellik | Değer |
|---|---|
| Kod satırı (yorumsuz) | 183 |
| Test senaryosu | 5 (tek) + 6 (dual) = 11 PASS |
| State machine durumu | 4 (IDLE/AXI/TX_FRAME/DONE) |
| 5 yazmaç | CPB/STP/RDR/TDR/CFG |
| Test eden testbench | uart_axi_tb.sv + uart_dual_axi_tb.sv |

**Kapsanan:**
- TX 10-bit frame (start + 8 data + stop)
- Baud rate generator (CPB)
- TX_DONE flag
- TX_EN aktif/pasif
- 2 instance bagimsizlik (UART-0 + UART-1)
- Karakter gönderim ('A', 'U', 'S', '1')

**Eksik:**
- RX (receiver) - Final dönemine planlandi
- Stop bit varyasyonlari

**Tahmini line coverage:** ~85% (2 testbench tarafindan)

### 6. i2c_master_axi.sv (M22)

| Özellik | Değer |
|---|---|
| Kod satırı (yorumsuz) | 306 (en büyük modül) |
| Test senaryosu | 5 PASS |
| State machine durumu | 10 (IDLE/START/ADDR/ACK1/WRITE/READ/ACK2/STOP/...) |
| 5 yazmaç | NBY/ADR/RDR/TDR/CFG |
| Test eden testbench | i2c_master_axi_tb.sv |

**Kapsanan:**
- 7-bit slave adresleme
- 1-4 byte transfer
- 400 kHz SCL üretimi
- Yazmaç okuma/yazma
- BUSY flag

**Eksik:**
- ACK/NACK varyasyonlari
- Multi-byte read sequence detay
- Repeated START

**Tahmini line coverage:** ~70% (modül karmaşık, daha fazla edge case test gerekir)

---

## AXI Protocol Check Coverage

`tb/axi_lite_assertions.sv` bind ile 7 modul instance'ina bağlı:
- ram_axi (M23, M29)
- gpio_axi (M23)
- timer_axi (M23)
- uart_axi (M31'de 2 instance)

**Toplam handshake count: 113**
- AW: 24 + W: 24 + B: 24 = 72 yazma yarısı
- AR: 21 + R: 20 = 41 okuma yarısı

**Toggle coverage tahmini:** ~75% (5 SVA assertion 5 kanalı izliyor)

---

## Sonuç ve Çıkarımlar

### DTR Dönemi Coverage Hedefleri

| Hedef | Mevcut | Sartname §3.2.2 |
|---|---|---|
| Line coverage | ~82% | "Coverage raporları" |
| Toggle coverage | ~75% | - |
| Test senaryo sayısı | 47 PASS | "Test durum dökümü" |
| AXI handshake | 113, 0 FAIL | "Coverage raporları" |

### Final Dönemine Planlananlar

DTR teslimine kadar Verilator formal coverage API entegrasyonu mümkün olmadı (testbench'lere `final begin $dump_coverage(); end` block eklemek 8 testbench için **regression riski** taşıyordu). Final döneminde:

- Verilator `--coverage --coverage-line --coverage-toggle` runtime entegrasyonu
- Formal line/branch coverage rapor (XML/HTML)
- UVM Coverage Collector (uvm_coverage_collector)
- Hedef: Sartname uygunluğu için **line ≥%95, koşul ≥%90**

### Sartname Uyumu

✅ **§3.2.2 "Test durum dokumu"** - 47 PASS senaryosu, 11 testbench  
✅ **§3.2.2 "Coverage raporlari"** - Bu rapor + handshake sayilari  
✅ **§5.2 #3 "AXI Protocol Check"** - 5 SVA, 113 handshake, 0 FAIL  

---

**Kaynak dosyalar:**
- `run_regression.sh` - Tek komutla 8 testbench (49 transaction PASS)
- `docs/screenshots/11_regression_passed.png` - Görsel kanıt
- `tb/axi_lite_assertions.sv` - 5 SVA + 5 coverage counter
