betul605/2026_ZUGA-IC/docs/CLAUDE_SOHBET_LINKLERI.md

# ZUGA-IC Claude Sohbet Linkleri

Bu dosya DTR ve Final donemi boyunca Claude ile yapilan tum sohbetlerin 
linklerini tutar. Sohbete tekrar erismek icin linke tikla.

## DTR Donemi Ana Sohbet (May 7-8, 2026) ⭐
- **Link:** https://claude.ai/chat/60b58a97-4b22-4ac1-bfeb-c3ca22f329e3
- **Tarihler:** 7-8 May 2026 (2 gun)
- **Milestone:** M27-M50 (24 milestone)
- **Onemli ciktilar:**
  - M29: Boot ROM (muhendislik zarafeti)
  - M31: Dual UART (muhendislik zarafeti)
  - M41: Regression Suite (8/8 PASS)
  - M42: Coverage Raporu (199 satir)
  - M44: 4 Mermaid Diyagram PNG
  - M46: Boot ROM Disassembly (cift dogrulama)
  - **M49: FAZ 7 TAMAMLANDI** ⭐⭐⭐ (soc_top_axi.sv 520 satir)
  - DTR raporu 855 -> 1754 satir (%105 buyume)

## Planli Sohbetler
- 9-10 May: Vivado Sentez Seansi (Umur + Betul)
- 11-14 May: DTR PDF + Format kontrol
- 15 May: Teslim

## Erisim Notu
Eger link calismazsa: Daily Journal (docs/DAILY_JOURNAL.md) dosyasinda 
her gunun ozeti var.
