betul605/2026_ZUGA-IC/docs/screenshots/07_github_commits.png

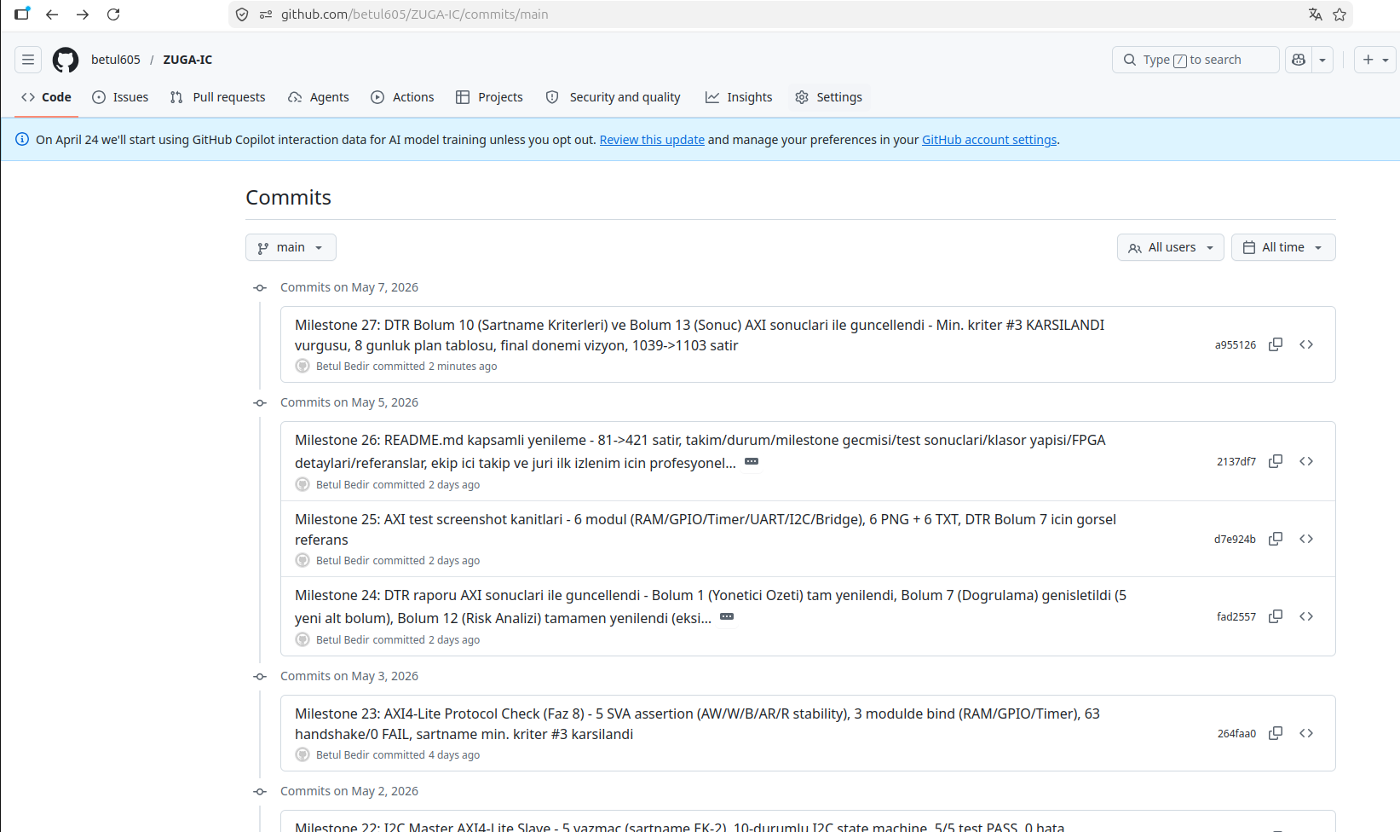
docs/screenshots/07_github_commits.png
