betul605/2026_ZUGA-IC/docs/screenshots/08_git_tags.png

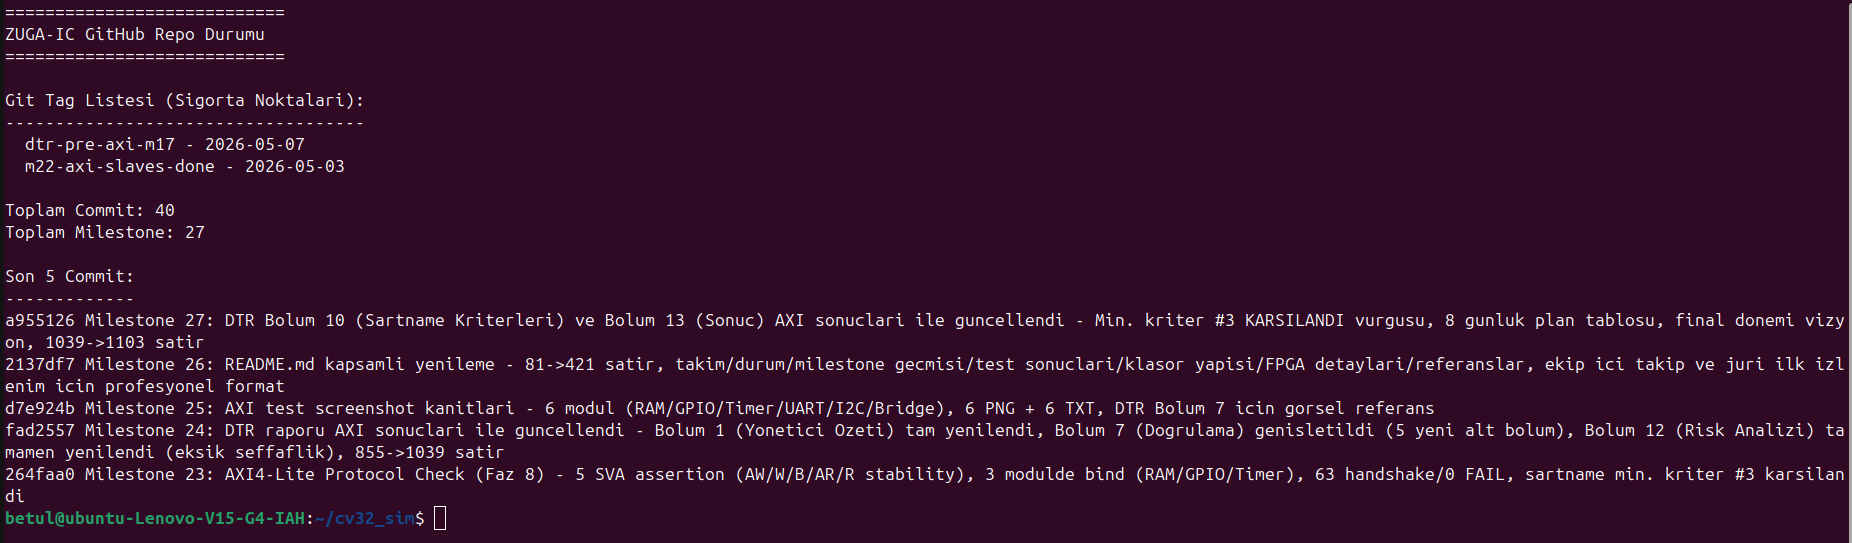
docs/screenshots/08_git_tags.png
