betul605/2026_ZUGA-IC/docs/screenshots/11_regression_passed.png

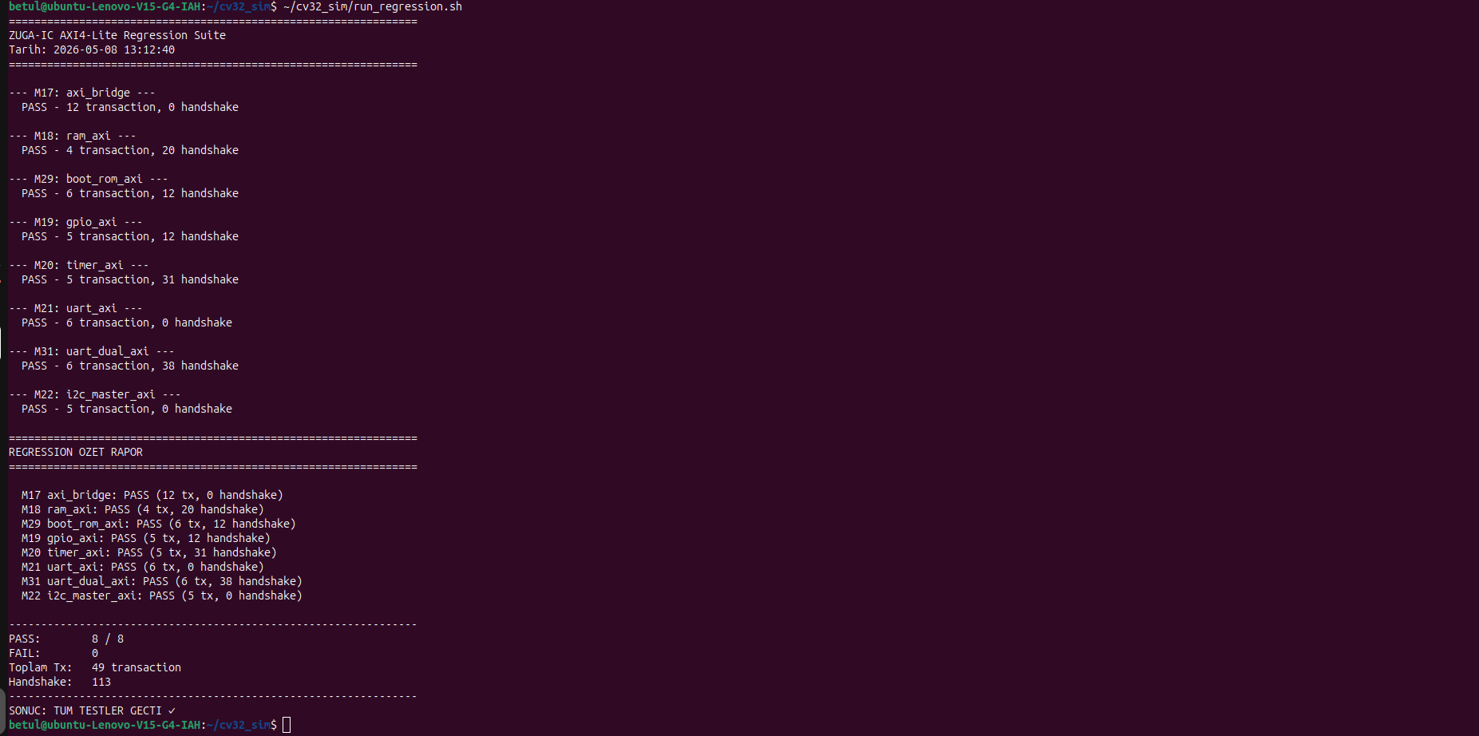
docs/screenshots/11_regression_passed.png
