betul605/2026_ZUGA-IC/docs/screenshots/12_diagram_system.png

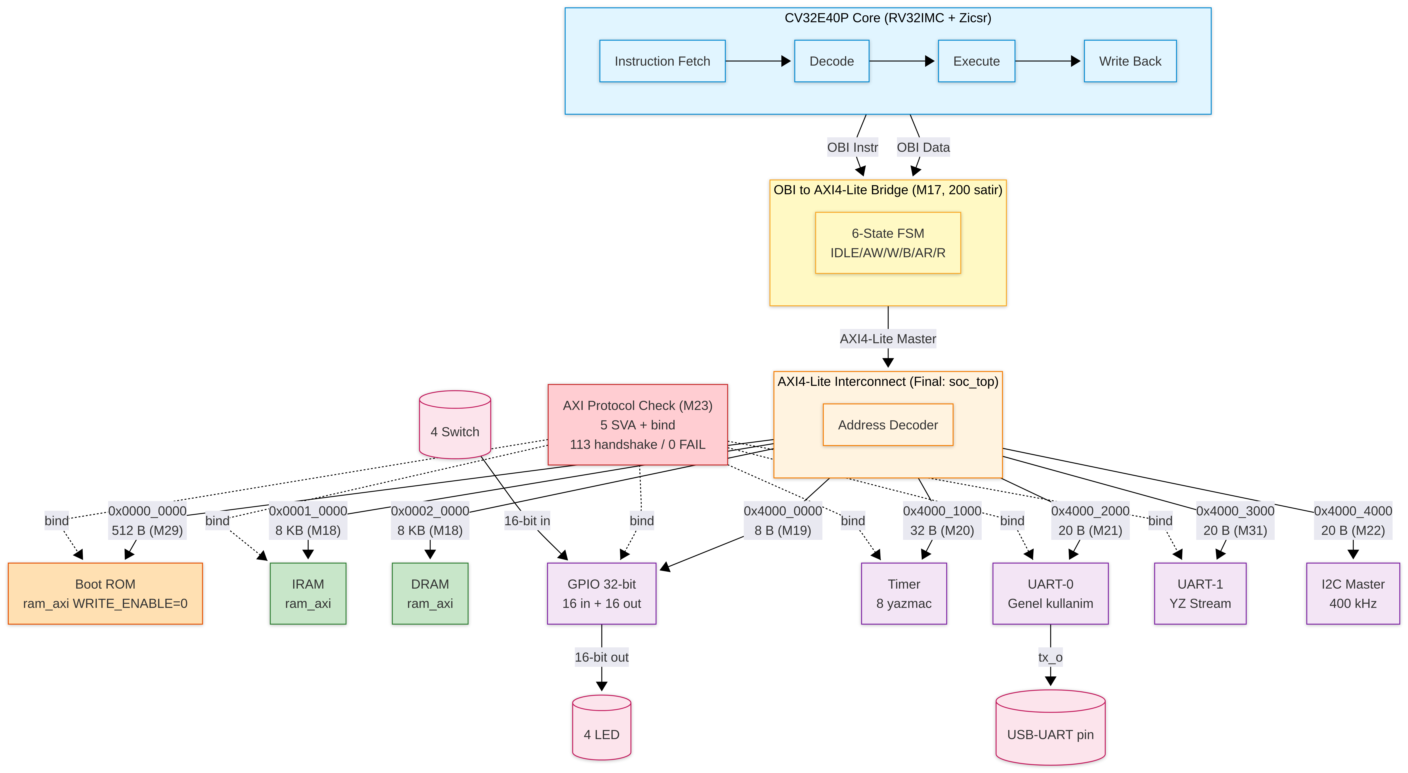
docs/screenshots/12_diagram_system.png
