betul605/2026_ZUGA-IC/docs/screenshots/13_diagram_modules.png

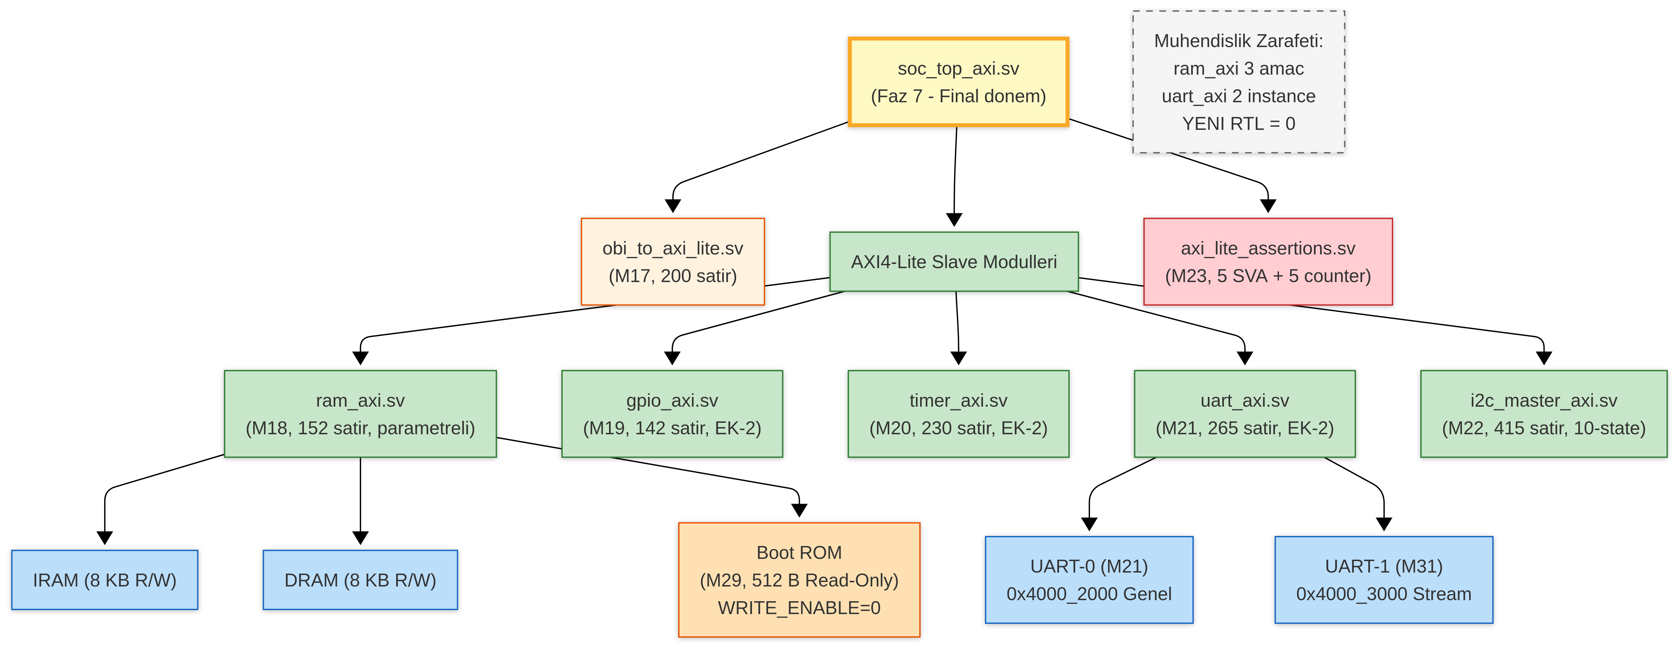
docs/screenshots/13_diagram_modules.png
