betul605/2026_ZUGA-IC/docs/screenshots/14_diagram_axi_handshake.png

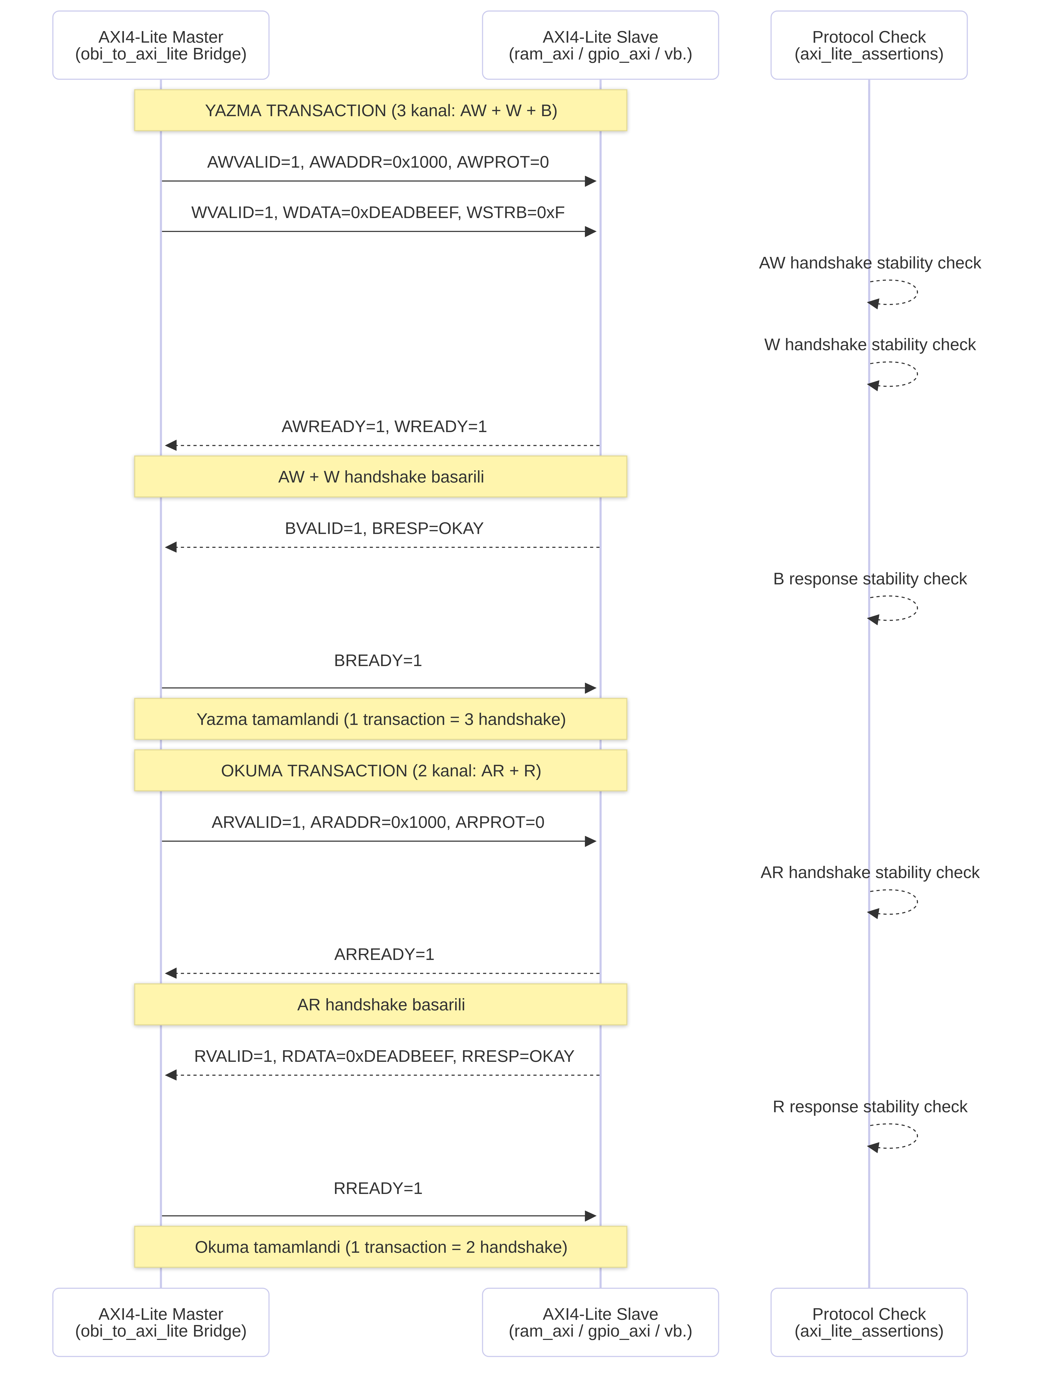
docs/screenshots/14_diagram_axi_handshake.png
