betul605/2026_ZUGA-IC/docs/screenshots/15_diagram_boot_sequence.png

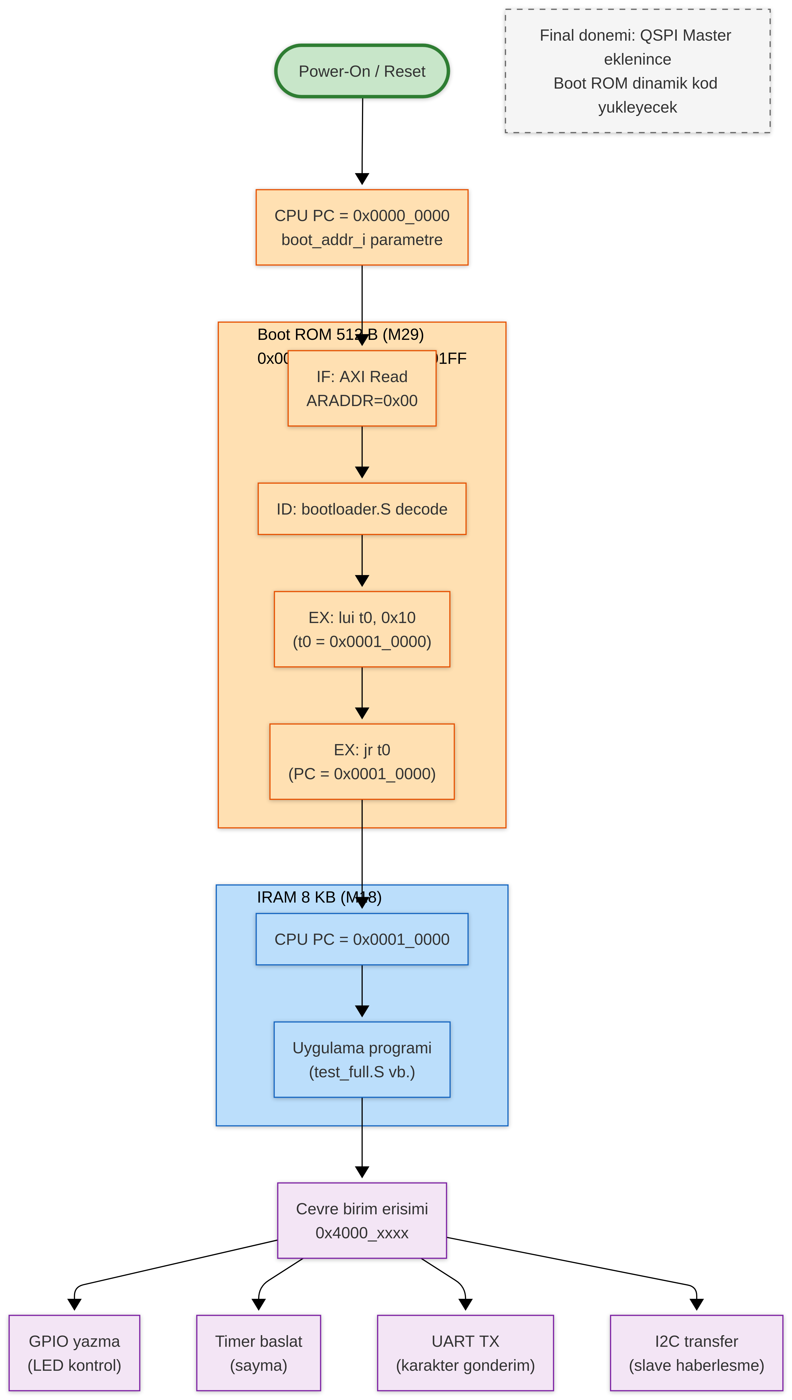
docs/screenshots/15_diagram_boot_sequence.png
