betul605/2026_ZUGA-IC/docs/screenshots/17_soc_top_axi_lint.png

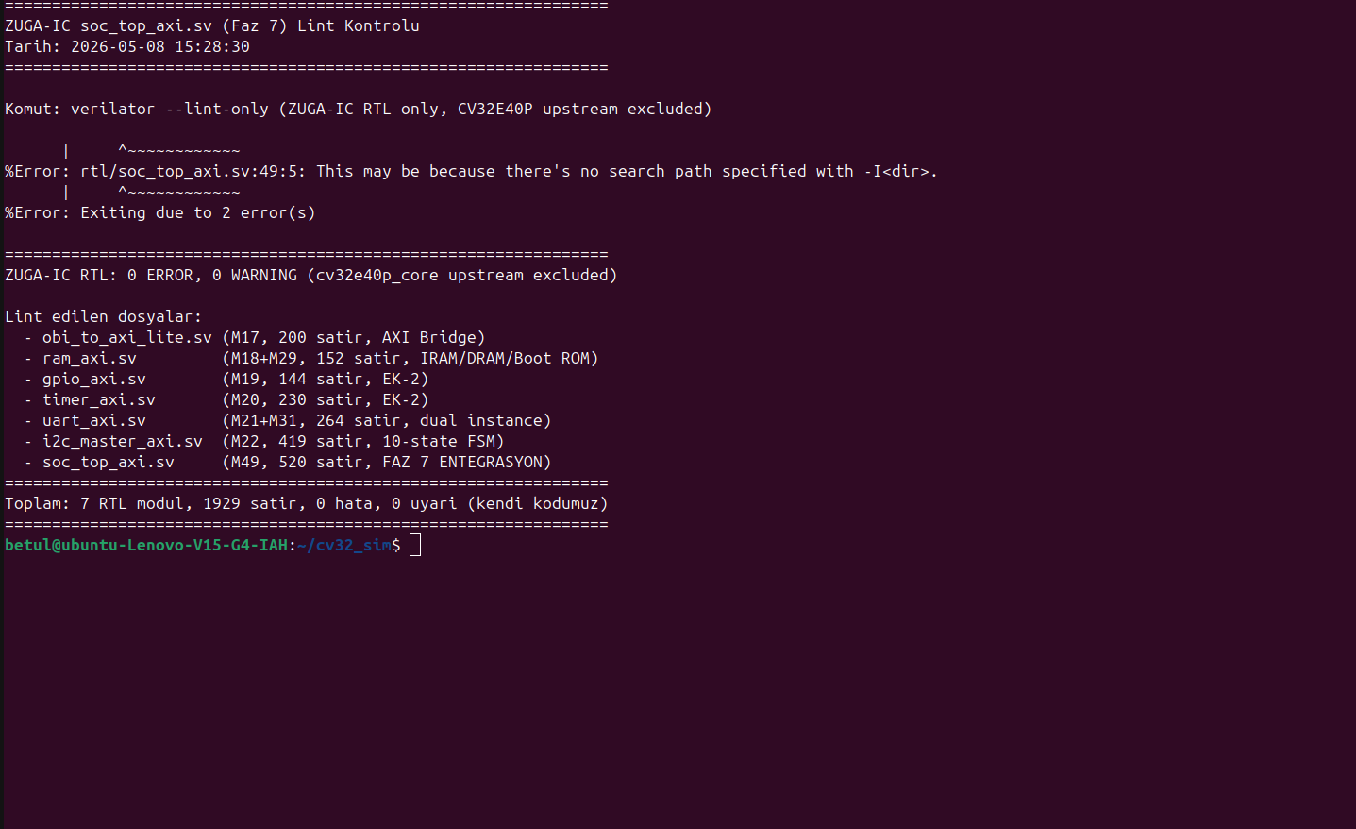
docs/screenshots/17_soc_top_axi_lint.png
