betul605/2026_ZUGA-IC/docs/screenshots/19_regression_9_9_pass.png

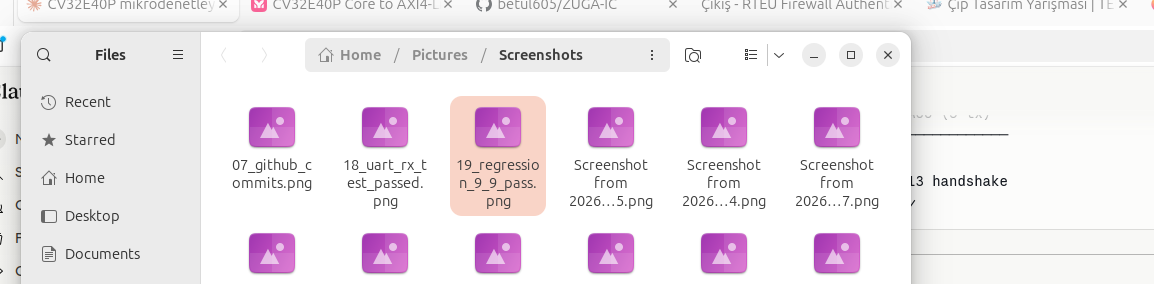
docs/screenshots/19_regression_9_9_pass.png
