betul605/2026_ZUGA-IC/asic/gds/i2c_master_axi/metrics.csv

design | design_name | config | flow_status | total_runtime | routed_runtime | (Cell/mm^2)/Core_Util | DIEAREA_mm^2 | CellPer_mm^2 | OpenDP_Util | Final_Util | Peak_Memory_Usage_MB | synth_cell_count | tritonRoute_violations | Short_violations | MetSpc_violations | OffGrid_violations | MinHole_violations | Other_violations | Magic_violations | pin_antenna_violations | net_antenna_violations | lvs_total_errors | cvc_total_errors | klayout_violations | wire_length | vias | wns | pl_wns | optimized_wns | fastroute_wns | spef_wns | tns | pl_tns | optimized_tns | fastroute_tns | spef_tns | HPWL | routing_layer1_pct | routing_layer2_pct | routing_layer3_pct | routing_layer4_pct | routing_layer5_pct | routing_layer6_pct | wires_count | wire_bits | public_wires_count | public_wire_bits | memories_count | memory_bits | processes_count | cells_pre_abc | AND | DFF | NAND | NOR | OR | XOR | XNOR | MUX
/openlane/designs/i2c_master_axi | i2c_master_axi | run1 | flow completed | 0h1m35s0ms | 0h1m14s0ms | 23866.666666666668 | 0.09 | 11933.333333333334 | 12.6 | -1 | 600.62 | 810 | 0 | 0 | 0 | 0 | 0 | 0 | 0 | 7 | 7 | 0 | -1 | -1 | 40402 | 7014 | 0.0 | -1 | -1 | -1 | 0.0 | 0.0 | -1 | -1 | -1 | 0.0 | 29876154.0 | 0.0 | 13.52 | 14.55 | 2.02 | 1.51 | 0.0 | 632 | 1009 | 49 | 360 | 0 | 0 | 0 | 847 | 24 | 2 | 57 | 31 | 190 | 19 | 6 | 24
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
