betul605/2026_ZUGA-IC/asic/gds/obi_to_axi_lite/metrics.csv

design | design_name | config | flow_status | total_runtime | routed_runtime | (Cell/mm^2)/Core_Util | DIEAREA_mm^2 | CellPer_mm^2 | OpenDP_Util | Final_Util | Peak_Memory_Usage_MB | synth_cell_count | tritonRoute_violations | Short_violations | MetSpc_violations | OffGrid_violations | MinHole_violations | Other_violations | Magic_violations | pin_antenna_violations | net_antenna_violations | lvs_total_errors | cvc_total_errors | klayout_violations | wire_length | vias | wns | pl_wns | optimized_wns | fastroute_wns | spef_wns | tns | pl_tns | optimized_tns | fastroute_tns | spef_tns | HPWL | routing_layer1_pct | routing_layer2_pct | routing_layer3_pct | routing_layer4_pct | routing_layer5_pct | routing_layer6_pct | wires_count | wire_bits | public_wires_count | public_wire_bits | memories_count | memory_bits | processes_count | cells_pre_abc | AND | DFF | NAND | NOR | OR | XOR | XNOR | MUX
/openlane/designs/obi_to_axi_lite | obi_to_axi_lite | run1 | flow completed | 0h1m1s0ms | 0h0m45s0ms | 20224.0 | 0.0625 | 10112.0 | 7.28 | -1 | 542.6 | 356 | 0 | 0 | 0 | 0 | 0 | 0 | 0 | 27 | 25 | 0 | -1 | -1 | 45029 | 3642 | 0.0 | -1 | -1 | -1 | 0.0 | 0.0 | -1 | -1 | -1 | 0.0 | 37606380.0 | 0.0 | 23.34 | 25.07 | 0.88 | 0.74 | 0.0 | 76 | 374 | 35 | 331 | 0 | 0 | 0 | 155 | 1 | 0 | 3 | 7 | 10 | 0 | 0 | 73
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
