betul605/2026_ZUGA-IC/asic/gds/timer_axi/metrics.csv

design | design_name | config | flow_status | total_runtime | routed_runtime | (Cell/mm^2)/Core_Util | DIEAREA_mm^2 | CellPer_mm^2 | OpenDP_Util | Final_Util | Peak_Memory_Usage_MB | synth_cell_count | tritonRoute_violations | Short_violations | MetSpc_violations | OffGrid_violations | MinHole_violations | Other_violations | Magic_violations | pin_antenna_violations | net_antenna_violations | lvs_total_errors | cvc_total_errors | klayout_violations | wire_length | vias | wns | pl_wns | optimized_wns | fastroute_wns | spef_wns | tns | pl_tns | optimized_tns | fastroute_tns | spef_tns | HPWL | routing_layer1_pct | routing_layer2_pct | routing_layer3_pct | routing_layer4_pct | routing_layer5_pct | routing_layer6_pct | wires_count | wire_bits | public_wires_count | public_wire_bits | memories_count | memory_bits | processes_count | cells_pre_abc | AND | DFF | NAND | NOR | OR | XOR | XNOR | MUX
/openlane/designs/timer_axi | timer_axi | run1 | flow completed | 0h1m55s0ms | 0h1m31s0ms | 29133.333333333336 | 0.09 | 14566.666666666668 | 16.83 | -1 | 622.32 | 1123 | 0 | 0 | 0 | 0 | 0 | 0 | 0 | 9 | 9 | 0 | -1 | -1 | 53459 | 9522 | 0.0 | -1 | -1 | -1 | 0.0 | 0.0 | -1 | -1 | -1 | 0.0 | 40574515.0 | 0.0 | 18.11 | 18.18 | 3.04 | 2.11 | 0.0 | 907 | 1356 | 32 | 356 | 0 | 0 | 0 | 1200 | 41 | 32 | 62 | 11 | 251 | 141 | 47 | 66
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
