betul605/2026_ZUGA-IC/asic/gds/uart_axi/metrics.csv

design | design_name | config | flow_status | total_runtime | routed_runtime | (Cell/mm^2)/Core_Util | DIEAREA_mm^2 | CellPer_mm^2 | OpenDP_Util | Final_Util | Peak_Memory_Usage_MB | synth_cell_count | tritonRoute_violations | Short_violations | MetSpc_violations | OffGrid_violations | MinHole_violations | Other_violations | Magic_violations | pin_antenna_violations | net_antenna_violations | lvs_total_errors | cvc_total_errors | klayout_violations | wire_length | vias | wns | pl_wns | optimized_wns | fastroute_wns | spef_wns | tns | pl_tns | optimized_tns | fastroute_tns | spef_tns | HPWL | routing_layer1_pct | routing_layer2_pct | routing_layer3_pct | routing_layer4_pct | routing_layer5_pct | routing_layer6_pct | wires_count | wire_bits | public_wires_count | public_wire_bits | memories_count | memory_bits | processes_count | cells_pre_abc | AND | DFF | NAND | NOR | OR | XOR | XNOR | MUX
/openlane/designs/uart_axi | uart_axi | run1 | flow completed | 0h1m45s0ms | 0h1m23s0ms | 28688.88888888889 | 0.09 | 14344.444444444445 | 15.18 | -1 | 597.75 | 987 | 0 | 0 | 0 | 0 | 0 | 0 | 0 | 8 | 8 | 0 | -1 | -1 | 43152 | 8405 | 0.0 | -1 | -1 | -1 | 0.0 | 0.0 | -1 | -1 | -1 | 0.0 | 31414433.0 | 0.0 | 15.22 | 15.99 | 1.47 | 1.99 | 0.0 | 776 | 1178 | 45 | 372 | 0 | 0 | 0 | 1020 | 24 | 22 | 53 | 11 | 188 | 104 | 9 | 10
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
