betul605/2026_ZUGA-IC/asic/gds/yz_csr/metrics.csv

design | design_name | config | flow_status | total_runtime | routed_runtime | (Cell/mm^2)/Core_Util | DIEAREA_mm^2 | CellPer_mm^2 | OpenDP_Util | Final_Util | Peak_Memory_Usage_MB | synth_cell_count | tritonRoute_violations | Short_violations | MetSpc_violations | OffGrid_violations | MinHole_violations | Other_violations | Magic_violations | pin_antenna_violations | net_antenna_violations | lvs_total_errors | cvc_total_errors | klayout_violations | wire_length | vias | wns | pl_wns | optimized_wns | fastroute_wns | spef_wns | tns | pl_tns | optimized_tns | fastroute_tns | spef_tns | HPWL | routing_layer1_pct | routing_layer2_pct | routing_layer3_pct | routing_layer4_pct | routing_layer5_pct | routing_layer6_pct | wires_count | wire_bits | public_wires_count | public_wire_bits | memories_count | memory_bits | processes_count | cells_pre_abc | AND | DFF | NAND | NOR | OR | XOR | XNOR | MUX
/openlane/designs/yz_csr | yz_csr | run1 | flow completed | 0h1m51s0ms | 0h1m25s0ms | 32511.111111111113 | 0.09 | 16255.555555555557 | 16.85 | -1 | 612.33 | 1077 | 0 | 0 | 0 | 0 | 0 | 0 | 0 | 17 | 17 | 0 | -1 | -1 | 78019 | 10241 | 0.0 | -1 | -1 | -1 | 0.0 | 0.0 | -1 | -1 | -1 | 0.0 | 61141562.0 | 0.0 | 26.69 | 28.39 | 3.12 | 3.21 | 0.0 | 637 | 1222 | 44 | 566 | 0 | 0 | 0 | 918 | 3 | 1 | 24 | 2 | 176 | 30 | 1 | 257
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
