betul605/2026_ZUGA-IC/asic/gds/gpio_axi/metrics.csv

design | design_name | config | flow_status | total_runtime | routed_runtime | (Cell/mm^2)/Core_Util | DIEAREA_mm^2 | CellPer_mm^2 | OpenDP_Util | Final_Util | Peak_Memory_Usage_MB | synth_cell_count | tritonRoute_violations | Short_violations | MetSpc_violations | OffGrid_violations | MinHole_violations | Other_violations | Magic_violations | pin_antenna_violations | net_antenna_violations | lvs_total_errors | cvc_total_errors | klayout_violations | wire_length | vias | wns | pl_wns | optimized_wns | fastroute_wns | spef_wns | tns | pl_tns | optimized_tns | fastroute_tns | spef_tns | HPWL | routing_layer1_pct | routing_layer2_pct | routing_layer3_pct | routing_layer4_pct | routing_layer5_pct | routing_layer6_pct | wires_count | wire_bits | public_wires_count | public_wire_bits | memories_count | memory_bits | processes_count | cells_pre_abc | AND | DFF | NAND | NOR | OR | XOR | XNOR | MUX
/openlane/designs/gpio_axi | gpio_axi | gpio_run | flow completed | 0h0m52s0ms | 0h0m39s0ms | 10330.578512396694 | 0.0484 | 5165.289256198347 | 4.44 | -1 | 507.3 | 159 | 0 | 0 | 0 | 0 | 0 | 0 | 0 | 2 | 2 | 0 | -1 | -1 | 15444 | 1428 | 0.0 | -1 | -1 | -1 | 0.0 | 0.0 | -1 | -1 | -1 | 0.0 | 12923149.0 | 0.0 | 9.76 | 12.02 | 0.37 | 0.31 | 0.0 | 75 | 286 | 26 | 236 | 0 | 0 | 0 | 88 | 0 | 0 | 1 | 2 | 2 | 0 | 0 | 16
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
