betul605/2026_ZUGA-IC/demo/harness_results/full_20260919_99.36pct/samples.csv

index | name | golden_ref | predicted | matches_golden | truth_info | matches_truth_info | golden_scores | scores | score_error_pct | latency_ms | tx_ms | timeout | retries | raw
0 | go_f19279c4_nohash_0 | no | no | 1 | unknown | 0 | -128;-107;-121;100 | -219976;64344;32838;125639 |  | 105.024 | 167.245 | 0 | 0 | RESULT: no scores=-219976,64344,32838,125639
1 | no_256c0a05_nohash_0 | no | no | 1 | no | 1 | -128;-127;-128;126 | -116390;20660;-6811;152586 |  | 105.118 | 167.571 | 0 | 0 | RESULT: no scores=-116390,20660,-6811,152586
2 | no_9be15e93_nohash_0 | no | no | 1 | no | 1 | -128;-127;-128;127 | -117989;18922;-2973;160206 |  | 102.140 | 170.230 | 0 | 0 | RESULT: no scores=-117989,18922,-2973,160206
3 | yes_ffb86d3c_nohash_0 | yes | yes | 1 | yes | 1 | -128;-127;127;-128 | -209126;28418;171093;3584 |  | 104.678 | 167.537 | 0 | 0 | RESULT: yes scores=-209126,28418,171093,3584
4 | go_0c40e715_nohash_1 | no | no | 1 | unknown | 0 | -128;-124;-128;124 | -221579;66761;-34705;173115 |  | 104.346 | 170.152 | 0 | 0 | RESULT: no scores=-221579,66761,-34705,173115
5 | yes_7be9f58a_nohash_0 | yes | yes | 1 | yes | 1 | -128;-120;98;-105 | -109987;2688;83451;31368 |  | 100.563 | 169.901 | 0 | 0 | RESULT: yes scores=-109987,2688,83451,31368
6 | yes_525eaa62_nohash_2 | yes | yes | 1 | yes | 1 | -128;-128;127;-127 | -69492;-52395;145259;-137 |  | 105.081 | 167.546 | 0 | 0 | RESULT: yes scores=-69492,-52395,145259,-137
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
155 | yes_bdd22e4d_nohash_3 | yes | yes | 1 | yes | 1 | -128;-128;127;-128 | -177269;-3303;191136;28941 |  | 107.217 | 166.636 | 0 | 0 | RESULT: yes scores=-177269,-3303,191136,28941
