betul605/2026_ZUGA-IC/demo/harness_results/demo40_20260918_100pct/samples.csv

index | name | golden_ref | predicted | matches_golden | truth_info | matches_truth_info | golden_scores | scores | score_error_pct | latency_ms | tx_ms | timeout | retries | raw
0 | go_27c24504_nohash_3 | no | no | 1 | unknown | 0 | -128;-96;-124;92 | -150131;62052;8900;112371 |  | 100.630 | 170.065 | 0 | 0 | RESULT: no scores=-150131,62052,8900,112371
1 | go_726382d6_nohash_1 | no | no | 1 | unknown | 0 | -128;-113;-128;112 | -99466;47440;-67995;117786 |  | 105.249 | 166.972 | 0 | 0 | RESULT: no scores=-99466,47440,-67995,117786
2 | no_9be15e93_nohash_0 | no | no | 1 | no | 1 | -128;-127;-128;127 | -117989;18922;-2973;160206 |  | 105.469 | 167.061 | 0 | 0 | RESULT: no scores=-117989,18922,-2973,160206
3 | yes_1496195a_nohash_3 | yes | yes | 1 | yes | 1 | -128;-128;127;-128 | -213286;2530;192645;22536 |  | 105.154 | 166.995 | 0 | 0 | RESULT: yes scores=-213286,2530,192645,22536
4 | no_bde0f20a_nohash_0 | no | no | 1 | no | 1 | -128;-126;-128;126 | -177318;101097;-74534;226927 |  | 109.155 | 166.737 | 0 | 0 | RESULT: no scores=-177318,101097,-74534,226927
5 | yes_3e31dffe_nohash_0 | yes | yes | 1 | yes | 1 | -128;-128;127;-128 | -163486;-25323;203960;-38359 |  | 108.198 | 169.681 | 0 | 0 | RESULT: yes scores=-163486,-25323,203960,-38359
6 | go_28e47b1a_nohash_1 | unknown | unknown | 1 | unknown | 1 | -128;80;-128;-80 | -148807;119149;-44088;88414 |  | 117.034 | 166.831 | 0 | 0 | RESULT: unknown scores=-148807,119149,-44088,88414
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
39 | yes_9b8a7439_nohash_4 | yes | yes | 1 | yes | 1 | -128;-128;127;-128 | -195062;17010;219620;-35933 |  | 108.621 | 167.101 | 0 | 0 | RESULT: yes scores=-195062,17010,219620,-35933
