betul605/2026_ZUGA-IC/results/ZUGA-IC_20260915_185034/samples.csv

index | name | golden_ref | predicted | matches_golden | truth_info | matches_truth_info | golden_scores | scores | score_error_pct | latency_ms | tx_ms | timeout | retries | raw
0 | vec_yes | yes |  | 0 | yes | 0 |  |  |  |  | 167.354 | 1 | 1
1 | vec_yes | yes |  | 0 | yes | 0 |  |  |  |  | 167.484 | 1 | 1
2 | vec_yes | yes |  | 0 | yes | 0 |  |  |  |  | 167.384 | 1 | 1
3 | vec_yes | yes |  | 0 | yes | 0 |  |  |  |  | 167.480 | 1 | 1
