betul605/2026_ZUGA-IC/docs/screenshots/01_ram_axi_test.png

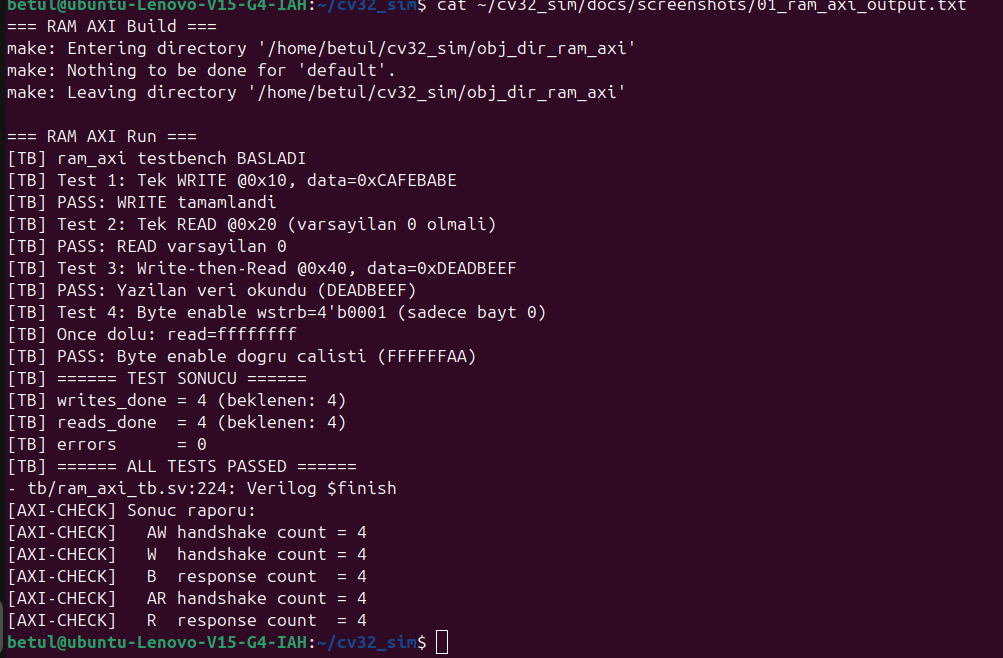
docs/screenshots/01_ram_axi_test.png
