betul605/2026_ZUGA-IC/docs/screenshots/04_uart_axi_test.png

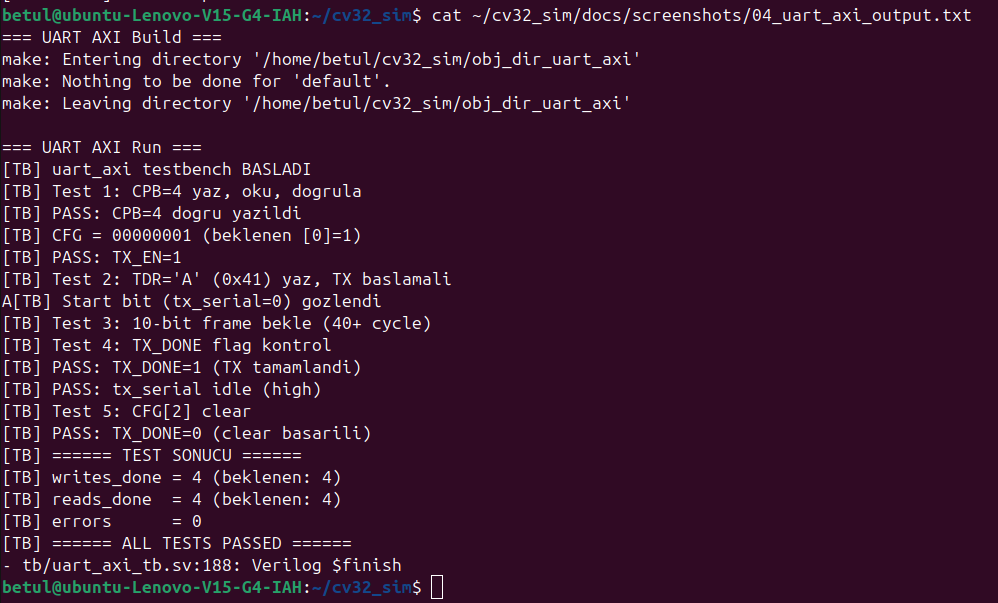
docs/screenshots/04_uart_axi_test.png
