betul605/2026_ZUGA-IC/docs/screenshots/05_i2c_master_axi_test.png

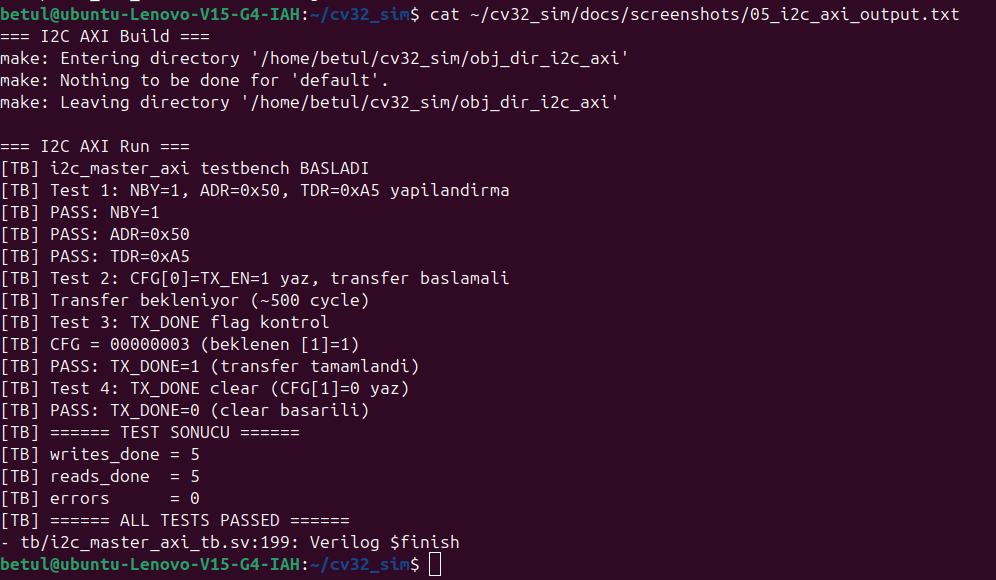
docs/screenshots/05_i2c_master_axi_test.png
