betul605/2026_ZUGA-IC/docs/screenshots/18_uart_rx_test_passed.png

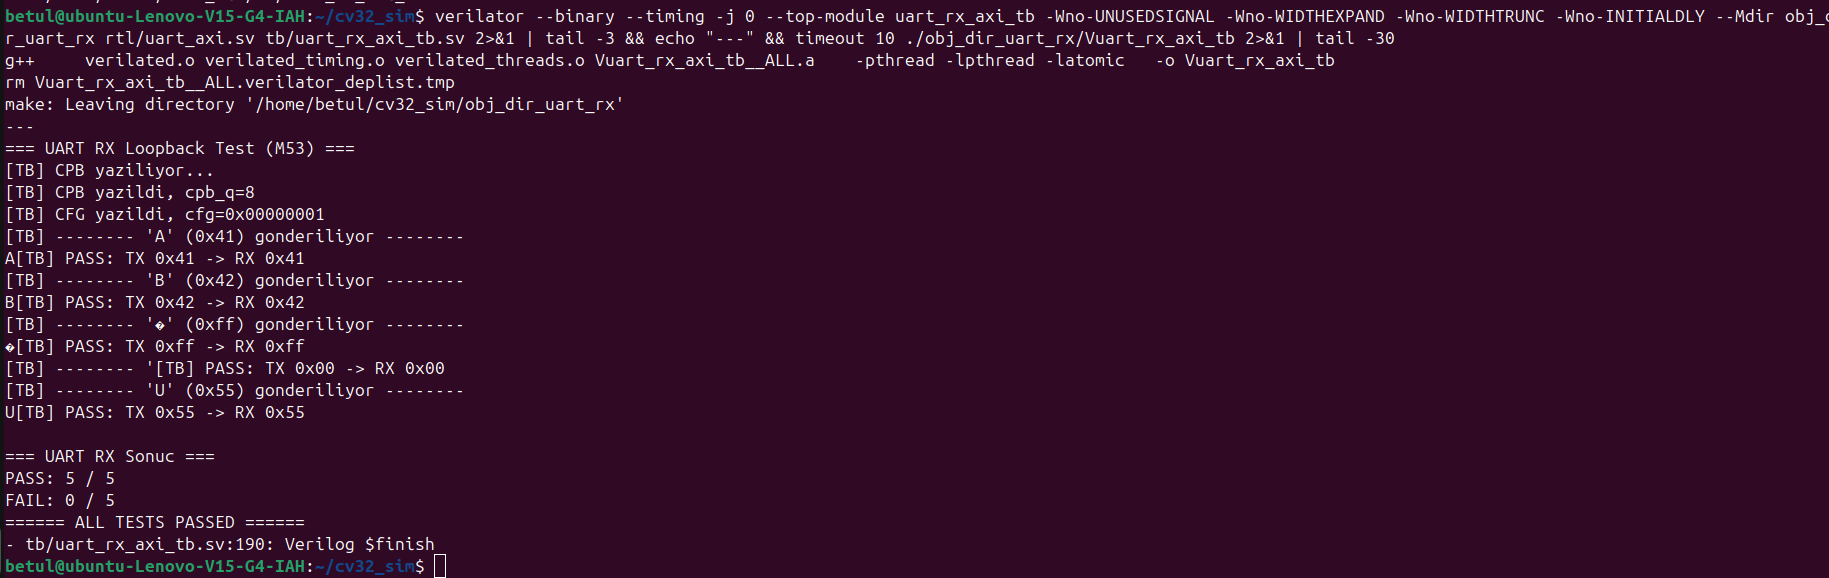
docs/screenshots/18_uart_rx_test_passed.png
