betul605/2026_ZUGA-IC/docs/screenshots/21_yz_csr_test_passed.png

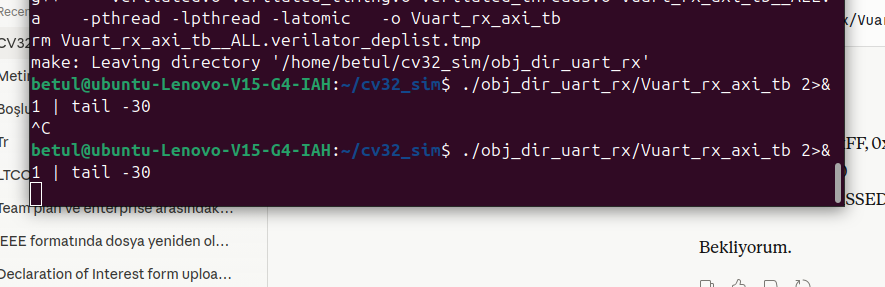
docs/screenshots/21_yz_csr_test_passed.png
