betul605/2026_ZUGA-IC/docs/DAILY_JOURNAL.md

# ZUGA-IC Daily Journal (Gunluk Calisma Notlari)

Bu dosya DTR ve Final donemi boyunca her gunun ne yapildigini ozetler.
Sohbet erisim sorunu olursa veya yarinki Claude bagam kurabilsin diye.

---

## 8 May 2026 (Cuma) — TARIHI GUN: 24 Milestone! ⭐⭐⭐

**Calisma suresi:** ~16 saat  
**Sonuc:** M27-M50, DTR raporu 855 -> 1754 satir (%105 buyume), Faz 7 TAMAMLANDI

### Yapilanlar (Kronolojik)

**Sabah (M27-M33): DTR Birinci Dalga**
- M27: DTR Bolum 10, 13 yenilendi
- M28: GitHub commits + git tag screenshot
- M29: **Boot ROM** (512 B, 6/6 PASS) - ram_axi.sv yeniden kullanim (yeni RTL YOK)
- M30: DTR Memory Map OTR Tablo 1 birebir
- M31: **Dual UART** (UART-0 + UART-1, 6/6 PASS) - uart_axi.sv 2 instance
- M32-M33: DTR UART-1 ekleme + lint screenshots

**Ogleden Sonra (M34-M40): DTR Ikinci Dalga**
- M34: DTR Bolum 11 (Takvim, 1196 satir)
- M35: DTR Bolum 4 (Modul Detaylari, 1311)
- M36: DTR Bolum 6 (Dogrulama Metodolojisi, 1392)
- M37: DTR Bolum 8 (Karsilasilan Zorluklar, 1522)
- M38: DTR Bolum 5 (Tasarim Kararlari, 1600)
- M39: DTR Bolum 2 (ONTR Degisiklikler, 1678)
- M40: README milestone tablosu

**Aksam (M41-M48): Ekstra Puan Dalgasi**
- M41: **Regression Suite** (run_regression.sh, 8/8 PASS otomatik)
- M42: **Coverage Raporu** (199 satir, ~%82 line, ~%75 toggle)
- M43: DTR Bolum 6.6 referanslar
- M44: **4 Mermaid Diyagram PNG** (12-15: system/modules/handshake/boot)
- M45: DTR'ye 4 Sekil referansi
- M46: **Boot ROM Disassembly** (compile + run cift dogrulama)
- M47: DTR Bolum 7 refresh (49 tx, 117 handshake)
- M48: DTR Bolum 10 refresh

**Gece (M49-M50): FAZ 7 TAMAMLANDI DALGASI ⭐⭐⭐**
- M49: **soc_top_axi.sv** (520 satir, Harvard mimari, lint temiz!)
- M50: DTR'de Faz 7 "ertelendi" -> "TAMAMLANDI" (9 yer)

### Bugun Eklenen Dosyalar
- rtl/soc_top_axi.sv (520 satir) ⭐⭐⭐
- rtl/ram_axi.sv (yeniden kullanim, M29 Boot ROM)
- sw/bootloader.S + bootloader.hex
- tb/boot_rom_axi_tb.sv (198 satir)
- tb/uart_dual_axi_tb.sv (289 satir)
- run_regression.sh (96 satir)
- run_coverage.sh (114 satir, manuel)
- lint_soc_top_axi.sh
- docs/COVERAGE_RAPORU.md (199 satir)
- docs/diagrams_mmd/ (4 mermaid kaynak)
- docs/screenshots/11_regression_passed.png
- docs/screenshots/12-15: 4 mermaid PNG
- docs/screenshots/16_bootloader_disassembly.png
- docs/screenshots/17_soc_top_axi_lint.png

### Bugun Atilan Sigorta Tag
- `dtr-pre-faz7` (M48 sonu, M49 oncesi geri donus noktasi)

### Sayilar (8 May aksam itibariyle)
- RTL modul: **14** (soc_top_axi yeni!)
- AXI transaction: 49 PASS
- AXI handshake: 117 (0 FAIL)
- Lint: 0 warning (kendi kodumuz)
- DTR rapor: 1754 satir, 12/13 bolum guncel
- Gorsel: 17 PNG
- GitHub commit: 65
- Annotated tag: 3 (dtr-pre-axi-m17, m22-axi-slaves-done, dtr-pre-faz7)

### Sartname Uyum Skor
- §3.2.2: 9/10 ✅ (sadece Vivado sentez sonuclari kaldi)
- §5.2: 3/5 ✅ (Vivado sonrasi 4/5, YZ + GDSII Final'de)
- §4.1 AXI4-Lite: ✅ TAM SoC (soc_top_axi.sv)
- §4.2.2 2x UART: ✅ M31
- §4.2.2.1 Boot ROM: ✅ M29

### Yarin Yapilacaklar (9 May)
- [ ] Umur'a Vivado randevusu yaz (saat + soc_top_axi top module)
- [ ] (Opsiyonel) DTR README badge 39 -> 50

### Hafta Sonu (9-10 May)
- [ ] **Vivado sentez seansi (Umur + Betul, 2 saat)**
- [ ] Top module: soc_top_axi
- [ ] Hedef: 50 MHz Arty A7-100T
- [ ] 3 yeni screenshot (sentez/utilization/timing)

### Onemli Notlar
- soc_top_axi.sv Harvard mimari kullaniyor (instr ROM + data AXI4-Lite)
- Verilator UNOPTFLAT uyarilari CV32E40P upstream'de, Vivado'yu engellemez
- Bridge zaten 2 instance kullanilabilir ama mimari basitlik icin tek
- Boot ROM 128 word + IRAM 2048 word birlesik instr_mem (BRAM inferred)

---

## 7 May 2026 (Persembe) — DTR Donemi Baslangici

**Calisma suresi:** ~9 saat  
**Sonuc:** M13-M26, DTR raporu temel olusturma

(Detay icin bir onceki Claude sohbetine bakin)

---

### 11 May Aksam - UART RX Maratonu (M53-M54)

**Sablon Test 25p icin kritik eksik kapatildi.**

**M53 TAMAMLANDI: UART RX (5/5 PASS) ⭐⭐⭐⭐⭐**

uart_axi.sv 264 -> 364 satir:
- RX FSM 4 durum (RX_IDLE / START / DATA / STOP)
- 2-cycle metastability synchronizer (rx_sync1_q -> rx_sync2_q)
- Bit-ortasi sampling (CPB/2 + N*CPB)
- False start koruma (RX_START'ta yarim bit sonra tekrar kontrol)
- rx_done_pulse: rdr_q + cfg_q[1] AXI yazma blokunda set (multiple driver onlendi)
- Verilator lint: 0 hata 0 uyari

uart_rx_axi_tb.sv (193 satir):
- TX -> RX loopback (tx_o ile rx_i ayni tele bagli)
- 5 test: 'A', 'B', 0xFF, 0x00, 0x55
- Calisan uart_axi_tb.sv stili (wait stratejisi)
- **5/5 PASS** (screenshot 18_uart_rx_test_passed.png)

Yasanan zorluk: Verilator --timing testbench'lerde initial blok 
non-blocking sorunlu. Cozum: `wait (axi_awready && axi_wready)` 
(do/while @posedge yerine).

**M54: DTR'ye UART RX yansitildi**

- 4 yer "Faz 3 ertelendi" -> "M53 TAMAMLANDI" (Bolum 2, 11, 12)
- Bolum 4.6 UART_AXI: 264->364 satir, RX state machine paragrafi eklendi
- 6 yer "49 transaction" -> "54 transaction" (UART RX 5 yeni test)
- Bolum 7: Testbench tablosu + AXI transaction tablosu UART RX satiri
- DTR 2206 -> 2228 satir

**Bugunun toplam bilanco (M27-M54, 28 milestone):**
- 71 commit
- DTR 855 -> 2228 satir (%160 buyume)
- +18 puan garanti (Cip Akisi + Kaynakca + YZ)
- Faz 7 (M49) + UART RX (M53) = 2 BUYUK kazanim
- 18 gorsel kanit (17.lint + 18.uart_rx_test eklendi)
- 4 annotated tag

**Tahmini DTR puani: 87-92 / 100** (Vivado sonrasi 95+)

**Kalan kritik isler (15 May teslime 7 gun):**
1. DDK testbench geldiginde ./dtr_demo dizini hazirla (ELEME!)
2. DTR'yi sablon yapisina cevirme (2-3 saat)
3. Vivado sentez (9-10 May, Umur ile)
4. DTR Bolum 9 (FPGA Prototipleme) Vivado sonrasi
5. Kapak + Icindekiler (30 dk)
6. PDF + format kontrol (3-4 saat)

### 11 May Aksam (Devam) - Sablon Uyum Maraton (M55-M58)

**Sablon paylasildi ve DTR sablon yapisina uyarlandi.**

**M55: README guncellemesi**
- Badge 39 -> 72 commit, 39 -> 54 milestone
- AXI tests 100+ -> 117+
- Asama tablosuna M27-M54 satirlari (DTR dalgasi + FAZ 7 + UART RX + sablon)
- 446 -> 464 satir

**M56: Kapak + Icindekiler**
- Sablon formati kapak (CIP TASARIM YARISMASI / MIKRODENETLEYICI / DETAY TASARIM RAPORU)
- Takim tablosu + danisman + GitHub link
- Icindekiler sablon 7 ana bolum + alt + 100p dagilim
- \newpage page break
- DTR 2228 -> 2266 satir

**M57: Sablon indekslemesi + Takim Org bolumu**
- 13 ana bolume sablon karsiligi etiketi (Bolum 1->§1, 3->§2.1, vb.)
- Duplikat Bolum 15 Kaynakca silindi (106 satir tekrar)
- Bolum 17 Takim Organizasyonu eklendi (Sablon §5, 3p)
  - 17.1 Takim Tanimi (1p)
  - 17.2 Gorev Dagilimi (2p): Umur Kaptan + Betul Gelistirici
  - 17.3 Calisma Metodolojisi (git workflow + AI asistan)
- DTR 2266 -> 2227 satir (net cleanup)

**M58: YZ Hizlandirici Bolum 16 guclendirme (sablon §2.2.3 11p MAKSIMUM!)**

4 yeni alt bolum eklendi:
- 16.10 Performans-Alan-Guc Tahminleri
  - Sky130 PDK: ~0.05 mm² alan tahmini
  - Guc: ~0.5 mW aktif, ~50 uW idle
  - Performans: 4-8 MAC/cycle @ 50 MHz
- 16.11 Modelden RTL Mermaid Diyagrami (14 dugum)
  - Yazilim asamasi (1-4): TF -> Quant -> TFLite -> C array
  - Donanim asamasi (5-9): CSR -> FSM -> MAC -> ReLU -> Output
  - Kaynak: docs/diagrams_mmd/05_yz_dataflow.mmd
- 16.12 GitHub link + Final klasor yapisi planli
- 16.13 Sablon §2.2.3 uyum tablosu (7/7 gereksinim TAMAM)

DTR 2227 -> 2367 satir (+140)

**DTR son durum:**
- 2367 satir, 17 bolum (16 + Takim Organizasyonu)
- 18 gorsel kanit
- 76 commit, 4 annotated tag
- Sablon 11/12 bolum karsilanmis (sadece §2.4 FPGA Vivado bekliyor)

**Tahmini DTR puani: 93-97 / 100** (Vivado sentez sonrasi 98-100!)

**Bugun toplam (M27-M58, 32 milestone):**
- DTR 855 -> 2367 satir (%177 buyume!)
- +21 puan garanti (Cip Akisi 5p + Kaynakca 2p + YZ 11p + Takim Org 3p)
- Faz 7 (M49) + UART RX (M53) = 2 BUYUK kazanim
- Sablon uyum %92 (11/12)

**Kalan kritik isler (15 May teslime 4 gun):**
1. DTR PDF uretimi (pandoc, 1 saat)
2. Vivado sentez (Umur ile, hafta sonu)
3. DDK testbench geldiginde ./dtr_demo dizini (ELEME kriteri)
4. Son revizyon

### 12 May (Devam) - Regression Maraton (M59-M60)

**Test kanitlarini guclendirme calismasi.**

**M59: Regression Suite 9/9 PASS (54 tx, 113 hs)**

Yapilanlar:
- uart_dual_axi_tb.sv'de rx_i bagli degildi (M53'te uart_axi.sv'ye rx_i 
  portu eklemistik, dual UART testbench kalmis) -> 1'b1 idle baglandi
- build_uart_rx_axi.sv yeni script (UART RX bagimsiz build)
- run_regression.sh'a UART RX satiri eklendi
- Sonuc: 9/9 PASS, 54 transaction, 113 handshake
- Screenshot 19_regression_9_9_pass.png alindi

Regression detayi:
| Testbench | Milestone | Transaction | Handshake |
|---|---|---|---|
| axi_bridge | M17 | 12 | 0 |
| ram_axi | M18 | 4 | 20 |
| boot_rom_axi | M29 | 6 | 12 |
| gpio_axi | M19 | 5 | 12 |
| timer_axi | M20 | 5 | 31 |
| uart_axi | M21 | 6 | 0 |
| uart_dual_axi | M31 | 6 | 38 |
| uart_rx_axi | M53 | 5 | 0 |
| i2c_master_axi | M22 | 5 | 0 |
| **TOPLAM** | | **54** | **113** |

**M60: DTR'ye 9/9 PASS yansitildi**
- 4 yer "8/8 PASS" -> "9/9 PASS"
- 49 -> 54 transaction (4 yer)
- Bolum 7.8 Regression Suite + Bolum 10 Sartname tablosu guncellendi
- Screenshot 19 referansli

**Bugun toplam (M27-M60, 34 milestone):**
- 79 commit, 19 gorsel kanit
- DTR 855 -> 2366 satir (%177 buyume!)
- +21 puan garanti
- Faz 7 + UART RX + YZ MAKSIMUM
- Sablon 11/12 uyum

**Kalan kritik isler:**
1. Vivado sentez (Umur ile, hafta sonu)
2. DDK testbench dizini (./dtr_demo, eleme!)
3. DTR final revizyon (tutarlilik)
4. PDF uretimi (pandoc)

### 12 May Aksam (Devam) - Final Revizyon Maraton (M61-M64)

**DTR icerik mukemmellestirme + sablon §2.4 + sartname §5.2 #4 + EK-1.**

**M61: DTR tutarlilik revizyonu**
- 3 RTL modul sayisi (13 -> 14, soc_top_axi M49 dahil)
- 1 testbench sayisi (11 -> 12, UART RX M53)
- 2 gorsel sayisi (11 PNG -> 19 PNG)
- 9 commit/milestone sayisi (37 -> 80 commit, 23/26/33/48/40/26 -> 60 milestone)
- 14 numerik guncelleme, DTR sayilari M27-M60 reflect

**M62: 20. PNG YZ Veri Akis Diyagrami**
- 05_yz_dataflow.mmd mermaid.live PNG export (542 KB)
- DTR Bolum 16.11'e Sekil 5 olarak referansli
- YZ §2.2.3 gorsel kanit gereksinimi TAM
- 19 -> 20 PNG

**M63: DTR Bolum 9 FPGA Hazirligi tam yenileme**
- Eski 53 satir (3-4 May, fpga_top.sv OBI eski) -> 108 satir
- soc_top_axi.sv M49 ile guncellenmis (520 satir Harvard mimari)
- 8 alt bolum: 9.1 hazirlik tablo, 9.2 Arty A7-100T, 9.3 top module, 
  9.4 constraint, 9.5 Vivado adimlar, 9.6 beklenen sonuclar, 9.7 sentez 
  sonrasi 3 screenshot plan, 9.8 bitstream Final
- Vivado sentez 13-14 May icin tam hazirlik
- Sablon §2.4 5p icin guc0lu temel

**M64: YZ Bolum 16 sartname §5.2 #4 ve EK-1 uyum**
- 16.1 hedef uygulama TFLite Micro Speech Tiny Conv1D olarak guncellendi
  - EK-1 ile birebir esleshtirme (KWS birincil + akustik anomali ikincil)
  - MFCC ozellikleri 40x49 frame
  - %85+ dogruluk hedefi
- 16.14 YZ Test ve Dogrulama Yaklasimi (yeni alt bolum)
  - 5 katman test hiyerarsisi:
    Katman 1: Modul birim testleri (yz_csr/mac/fsm/buffer tb)
    Katman 2: AXI Protocol Compliance (5 SVA, 100+ handshake)
    Katman 3: Inference smoke test (yz_inference_tb)
    Katman 4: Stress + edge case (all-zero, all-one, random)
    Katman 5: Python yazilim eslemesi (referans karsilastirma)
  - Beklenen: ~1500 satir testbench + ~500 satir Python
  - 100+ handshake hedefi
- DTR 2431 -> 2497 satir (+66)

**DTR son durum (12 May 16:50):**
- 2497 satir, 17 bolum
- 20 PNG gorsel kanit
- 84 commit
- Sablon 12/12 uyum (tum sablonun her bolumu karsiland - sadece Vivado sonuc bekliyor)
- YZ §2.2.3: 11/11 MAKSIMUM
- Faz 7 + UART RX + EK-1 Speech + 5 katman test plan

**Tahmini DTR puani: 96-99 / 100** (Vivado sentez sonrasi 99-100!)

**Bugun toplam (M27-M64, 38 milestone):**
- 84 commit, 20 gorsel
- DTR 855 -> 2497 satir (%192 buyume!)
- +21 puan garanti
- Faz 7 + UART RX + YZ MAKSIMUM + Bolum 9 FPGA HAZIR

**Kalan kritik isler (15 May'a 3 gun):**
1. Vivado sentez (Umur ile, 13-14 May hafta sonu)
2. DDK testbench dizini ./dtr_demo (eleme, DDK paylasimi bekleniyor)
3. DTR PDF uretimi (pandoc Calibri 11pt 1.15 satir max 30 sayfa)
4. Final revizyon
