betul605/2026_ZUGA-IC/tb/obi_assertions.sv

// ============================================================================
// obi_assertions.sv
// OBI bus protocol kontrolleri (Verilator 5.020 uyumlu).
//
// Sartname Madde 4.2.2.2 odul kriteri #3: "AXI Protocol Check" karsiligi.
// Bizim bus'imiz OBI; AXI4-Lite wrapper eklendiginde ayni metodoloji.
//
// Bu simulator SVA cycle-delay (##N) desteklemiyor, bu yuzden klasik
// always_ff + assert(condition) yapisini kullaniyoruz.
//
// Kontrol edilen kurallar:
//   1. gnt sadece req aktifken cikabilir
//   2. rvalid handshake'siz cikamaz
//   3. handshake sonrasi 1 cycle icinde rvalid gelmeli
//   4. req aktifken adres degismemeli (basitlestirilmis)
// ============================================================================

module obi_assertions #(
    parameter string BUS_NAME = "OBI"
)(
    input  logic        clk_i,
    input  logic        rst_ni,

    input  logic        req_i,
    input  logic        gnt_i,
    input  logic        rvalid_i,
    input  logic        we_i,
    input  logic [31:0] addr_i,
    input  logic [31:0] wdata_i,
    input  logic [31:0] rdata_i
);

    // ========================================================================
    // RULE 1: gnt sadece req aktifken cikabilir
    // ========================================================================
    always_ff @(posedge clk_i) begin
        if (rst_ni && gnt_i && !req_i) begin
            $display("[%s ASSERT FAIL @ %0t] gnt aktif ama req pasif!",
                     BUS_NAME, $time);
        end
    end

    // ========================================================================
    // RULE 2 + 3: handshake sonrasi 1 cycle icinde rvalid
    //   - handshake_q'yi flip-flop ile takip et
    //   - Bir cycle sonra rvalid olmali
    // ========================================================================
    logic handshake_q;
    always_ff @(posedge clk_i or negedge rst_ni) begin
        if (!rst_ni) handshake_q <= 1'b0;
        else         handshake_q <= req_i && gnt_i;
    end

    always_ff @(posedge clk_i) begin
        if (rst_ni && handshake_q && !rvalid_i) begin
            $display("[%s ASSERT FAIL @ %0t] handshake sonrasi rvalid yok!",
                     BUS_NAME, $time);
        end
        if (rst_ni && rvalid_i && !handshake_q) begin
            $display("[%s ASSERT FAIL @ %0t] rvalid var ama handshake yok!",
                     BUS_NAME, $time);
        end
    end

    // ========================================================================
    // NOTE: Assertion 4 (addr_stable) kaldirildi.
    //   Bizim slave'lerimizde gnt = req (combinational, tek cycle handshake).
    //   Bu durumda addr stability kuralı otomatik karsilanir; ayrica yazmak
    //   yanlis pozitif uretmektedir. AXI4-Lite wrapper geldiginde tekrar
    //   eklenecektir (orada handshake gec0ikebilir).
    // ========================================================================

    // ========================================================================
    // COVERAGE — handshake sayilari
    // ========================================================================
    int unsigned read_count  = 0;
    int unsigned write_count = 0;

    always_ff @(posedge clk_i) begin
        if (rst_ni && req_i && gnt_i) begin
            if (we_i) write_count <= write_count + 1;
            else      read_count  <= read_count  + 1;
        end
    end

    final begin
        $display("[%s COVERAGE] Toplam okuma: %0d, yazma: %0d, toplam: %0d",
                 BUS_NAME, read_count, write_count, read_count + write_count);
    end

endmodule
