betul605/2026_ZUGA-IC/(commit log)

2026-04-22 Milestone 01: CV32E40P ayakta, 'Hi' mesajı UART'tan basıldı
2026-04-22 Milestone 02: Modüler SoC yapısı + OBI bus select latch düzeltmesi — 'Hi\n' tam basılıyor
2026-04-24 Milestone 03: GPIO modülü + self-checking test — write/read 0xAA -> 'P'
2026-04-24 DTR durum raporu eklendi — 21 gun kala yol haritasi
2026-04-24 Milestone 04: Timer modulu + self-check — CLR/ENA/CNT calisiyor, 'T' basildi
2026-04-24 Dokumantasyon: Milestone 03 (GPIO) ve Milestone 04 (Timer) raporlari
2026-04-24 README.md eklendi — proje ozeti, kurulum, calistirma
2026-04-26 Milestone 06: EK-2 uyumlu UART (CPB/STP/RDR/TDR/CFG) - adres 0x40002000, regression-free
2026-04-26 Dokumantasyon: Milestone 06 (EK-2 uyumlu UART) raporu
2026-04-27 Milestone 09: UART Faz 2 - gercek baud generator + 10-bit TX state machine, sentezlenebilir RTL, tx_o pin
2026-04-27 Dokumantasyon: Milestone 09 (UART Faz 2) raporu
2026-04-27 Milestone 14: I2C Master Faz 1 - 6 yazmac + 5-state machine + bagimsiz testbench (22 edge)
2026-04-28 Milestone 15: I2C SoC entegrasyonu - 6. slave (0x40004000), test_full.S guncellendi, DATA writes 13->17, regression yok
2026-04-28 Dokumantasyon: Milestone 15 (I2C SoC Entegrasyonu) raporu
2026-05-02 Milestone 20: Timer AXI4-Lite Slave - 8 yazmac (sartname EK-2), prescaler + event, 5/5 test PASS, 0 hata
2026-05-02 Milestone 21: UART AXI4-Lite Slave - 5 yazmac (sartname EK-2), TX state machine + baud generator, 6/6 test PASS, 0 hata
2026-05-02 Milestone 22: I2C Master AXI4-Lite Slave - 5 yazmac (sartname EK-2), 10-durumlu I2C state machine, 5/5 test PASS, 0 hata
2026-05-03 Milestone 23: AXI4-Lite Protocol Check (Faz 8) - 5 SVA assertion (AW/W/B/AR/R stability), 3 modulde bind (RAM/GPIO/Timer), 63 handshake/0 FAIL, sartname min. kriter #3 karsilandi
    [axi_lite_assertions.sv, gpio_axi_tb.sv, ram_axi_tb.sv, timer_axi_tb.sv]
2026-05-05 Milestone 25: AXI test screenshot kanitlari - 6 modul (RAM/GPIO/Timer/UART/I2C/Bridge), 6 PNG + 6 TXT, DTR Bolum 7 icin gorsel referans
2026-05-07 Milestone 29: Boot ROM (512 B @ 0x00, OTR Tablo 1 uyumlu) - bootloader.S/elf/bin/hex, ram_axi.sv parametreli (WRITE_ENABLE=0) yeniden kullanildi yeni RTL yok, 6/6 test PASS, 0 hata, AXI Protocol Chec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
    [boot_rom_axi_tb.sv]
2026-05-07 Milestone 30: DTR Memory Map OTR uyumlu guncellendi - Bolum 3.1 (mevcut) ve 3.2 (Final, OTR Tablo 1 birebir), Boot ROM M29 OK satiri, UART-1 Pzt planli, IRAM 0x0001_0000'a kaydirildi (OTR uyumu), 110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
2026-05-07 Milestone 31: Dual UART (Sartname §4.2.2 2x UART) - uart_axi.sv 2 instance (UART-0 Genel + UART-1 Stream), yeni RTL YOK, 6/6 test PASS, 'U' 'S' '1' karakterleri ekranda gozlendi, 31 handshake/0 FAIL,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
    [uart_dual_axi_tb.sv]
2026-05-07 Milestone 31: Dual UART (Sartname 2x UART) - uart_axi.sv 2 instance (UART-0 Genel + UART-1 Stream), yeni RTL YOK, 6/6 test PASS, U S 1 karakterleri ekranda gozlendi, 31 handshake/0 FAIL, OTR Tablo 1 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
2026-05-07 Milestone 35: DTR Bolum 4 (Modul Detaylari) tamamen yenilendi - 13 RTL modul detayli, AXI4-Lite Bridge (M17), ram_axi 3 amac (IRAM/DRAM/Boot ROM) tablo, Boot ROM (M29), Dual UART (M31), AXI Protocol 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
2026-05-07 Milestone 37: DTR Bolum 8 (Karsilasilan Zorluklar) tamamen yenilendi - AXI gec0is hikayesi (M16-M23, 5 gun, 8 faz), Boot ROM mühendislik zarafeti, Dual UART yeniden kullanim, Faz 1 sorunlari referans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
2026-05-08 Milestone 40: README.md milestone tablosu ve metrikleri guncellendi - milestone badge 25->39, Faz 5 (Boot ROM + Dual UART + DTR ikinci dalga, M27-M39, 13 milestone), tarih 5 May->7 May, toplam transa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
2026-05-08 Milestone 44: 4 mermaid diyagram PNG (M40 sonrasi sistem) - 12_system (AXI4-Lite genel mimari), 13_modules (RTL hiyerarsi), 14_axi_handshake (yazma+okuma sequence), 15_boot_sequence (Power-On->BootRO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
2026-05-08 Milestone 47: DTR Bolum 7 (Dogrulama Sonuclari) refresh - 7.4 tablosuna Boot ROM (M29) + Dual UART (M31) eklendi (37->49 transaction), 7.6 Protocol Check tablosuna 6 modul + 117 handshake (63->117), 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
2026-05-08 Milestone 49: FAZ 7 TAMAMLANDI - soc_top_axi.sv (Tam AXI4-Lite SoC, 520 satir) - Harvard mimari (instr ROM + data AXI4-Lite peripheral bus), CV32E40P + obi_to_axi_lite Bridge + 6 AXI4-Lite slave (DRA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
2026-05-11 Milestone 53 TAMAMLANDI: UART RX modulu + testbench 5/5 PASS - uart_axi.sv 264->364 satir (RX FSM 4 durum RX_IDLE/START/DATA/STOP + 2-cycle synchronizer metastability koruma + bit-ortasi sampling CPB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
2026-05-11 Milestone 54: DTR'ye UART RX (M53) yansitildi - 4 yer 'Faz 3 ertelendi/Final donemi' -> 'M53 TAMAMLANDI 8 May' (Bolum 2 ONTR tablosu + Bolum 11 takvim + Bolum 12 risk), Bolum 4.6 uart_axi.sv (264->36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
2026-05-11 Daily Journal: M53 (UART RX 5/5 PASS) + M54 (DTR yansitma) eklendi - 28 milestone, DTR 2228 satir, +18 puan, kalan kritik isler
2026-05-11 Milestone 55: README guncellemesi (M01-M54 reflect) - badge 39->72 commit ve 39->54 milestone, AXI tests 100+ -> 117+, tarih 7 May -> 11 May, ozet 25 milestone -> 54 milestone + 4 gun kaldi + sartnam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
2026-05-12 Milestone 59: Regression suite 9/9 PASS (54 tx, 113 hs) - UART RX (M53) regression'a eklendi (build_uart_rx_axi.sh script + run_regression.sh satiri), uart_dual_axi_tb.sv rx_i baglandi (1'b1 idle) - 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
2026-05-12 Milestone 60: DTR'ye regression 9/9 PASS yansitildi - 4 yer guncellendi (Bolum 7.8 Regression Suite + Sartname tablosu #2 + Bolum 10 ozet), 8/8 -> 9/9 PASS, 49 -> 54 transaction, M59 12 May screensho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
2026-05-12 Milestone 61: DTR tutarlilik revizyonu - 3 RTL modul sayisi guncellemesi (13->14, soc_top_axi.sv M49 dahil), 1 testbench sayisi (11->12, UART RX M53), 2 gorsel sayisi (11 PNG->19 PNG), 9 commit/miles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
2026-05-12 Milestone 64: YZ Bolum 16 sartname §5.2 #4 ve EK-1 uyum guclendirme - 16.1 hedef uygulama TFLite Micro Speech Tiny Conv1D olarak EK-1 ile birebir esleshtirildi (KWS keyword spotting birincil + akusti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
2026-07-29 FPGA fix: fpga_top_axi Vivado-guvenli sozdizim
    [fpga_top_axi.sv]
2026-07-30 fix(fpga): Nexys Video XDC bank 14 VCCO cakismasi giderildi (led[6] W17->W15, sw->btn[4:0])
    [fpga_top_axi.sv]
2026-07-31 fix(rtl): cfg_q coklu-surucu (DRC MDRV-1) giderildi
    [i2c_master_axi.sv, uart_axi.sv]
2026-08-01 feat(asic): gpio_axi tam GDSII (OpenLane/Sky130, DRC/LVS/ERC temiz)
    [metrics.csv]
2026-08-02 feat(asic): 6 cevre blogu tam GDSII (Sky130, DRC/LVS/ERC temiz)
    [metrics.csv]
2026-09-16 FPGA demo WORKING: yz_accel actm/logitm moved to sync-only block (Vivado RAM inference, fixes sim/FPGA mismatch); UART-1 stream RX; demo firmware (UART->AXI weights+input); harness 100% golden on own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
    [manifest.csv]
2026-09-16 FPGA demo FINAL: 25 MHz + generated-clock kisiti (50 MHz kisitsiz saatte zamanlama ihlali logit3'u bozuyordu), gercek micro_speech agirliklari + giris donusumu; harness public_dataset %99.36, robustn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
    [robustness.csv, samples.csv]
2026-09-17 Demo: port ve manifest yolu duzeltmeleri, 18 Eylul harness raporlari (40/40 %100, 156 vektor %99.36)
    [manifest.csv, robustness.csv, samples.csv]
2026-09-17 Demo calistirma komutlari, LED anlamlari ve hata cozumleri
2026-09-18 Demo kurallari: LED durumuna gore adim atlama
2026-09-19 Demo komut listesi guncellendi
    [robustness.csv, samples.csv]
